msayad97/Amplifier/1kw-peak-rfpa-rc-1.0/1kw-peak-rfpa-rc-1.0/res/img/capacitor-holder-mounted.jpg

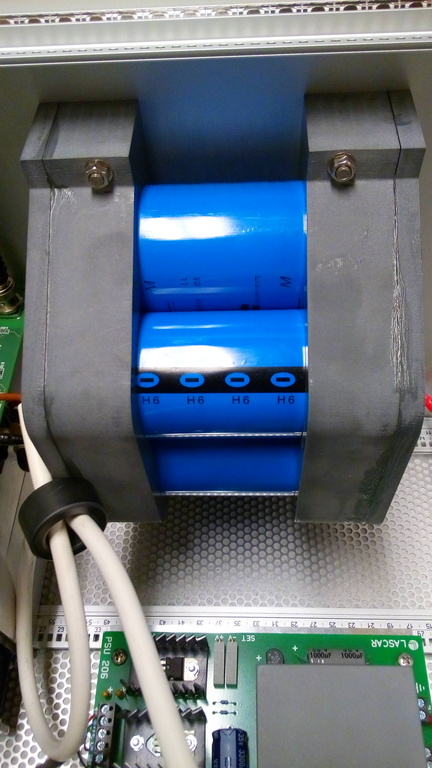
1kw-peak-rfpa-rc-1.0/1kw-peak-rfpa-rc-1.0/res/img/capacitor-holder-mounted.jpg
