msayad97/Amplifier/1kw-peak-rfpa-rc-1.0/1kw-peak-rfpa-rc-1.0/res/img/enclosure/IMG_20180207_160841.jpg

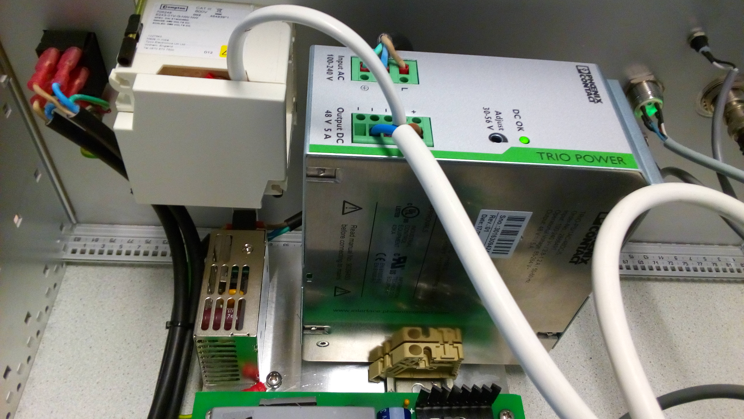
1kw-peak-rfpa-rc-1.0/1kw-peak-rfpa-rc-1.0/res/img/enclosure/IMG_20180207_160841.jpg
