msayad97/Amplifier/HF.png

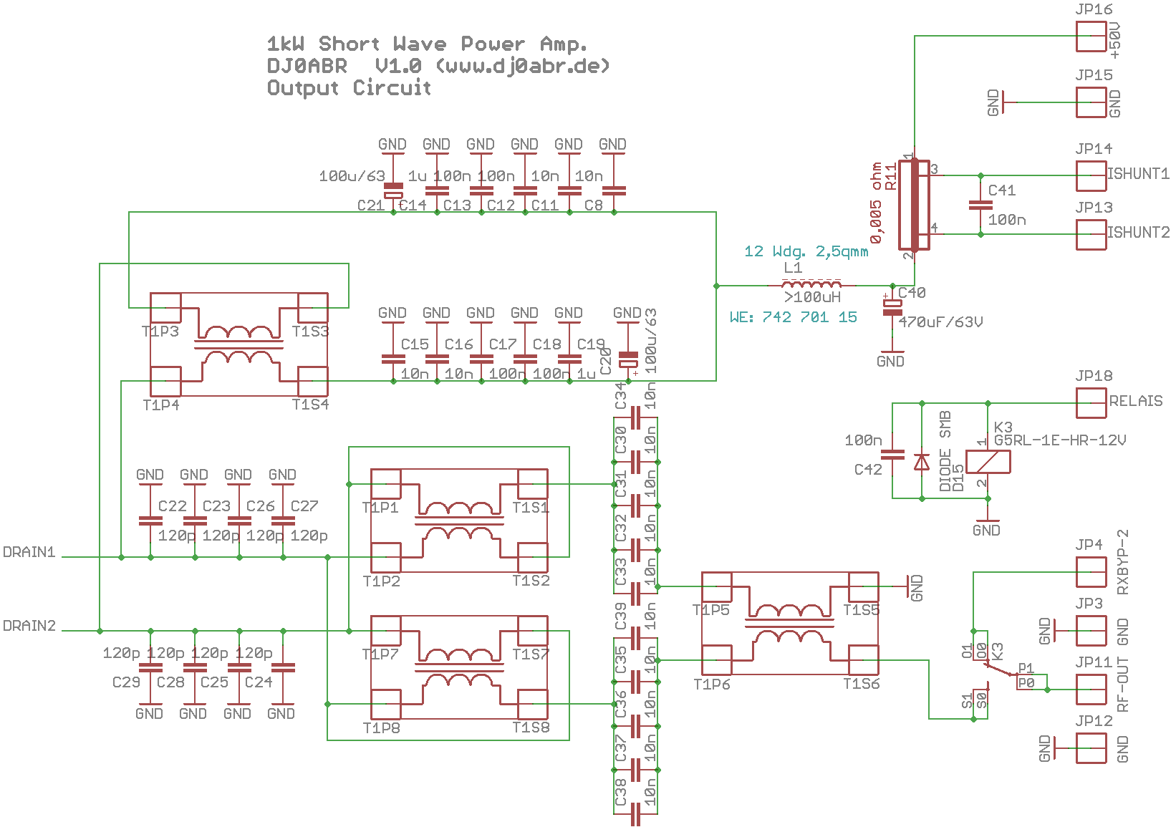
HF.png
