msayad97/Amplifier/KiCad/PCB/1.png

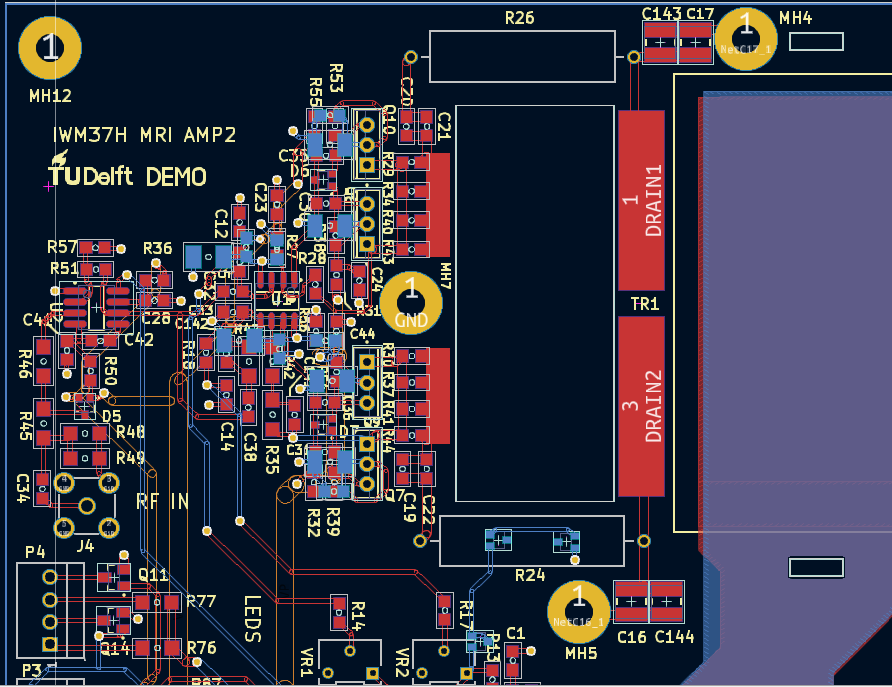
KiCad/PCB/1.png
