msayad97/Amplifier/KiCad/PCB/2.png

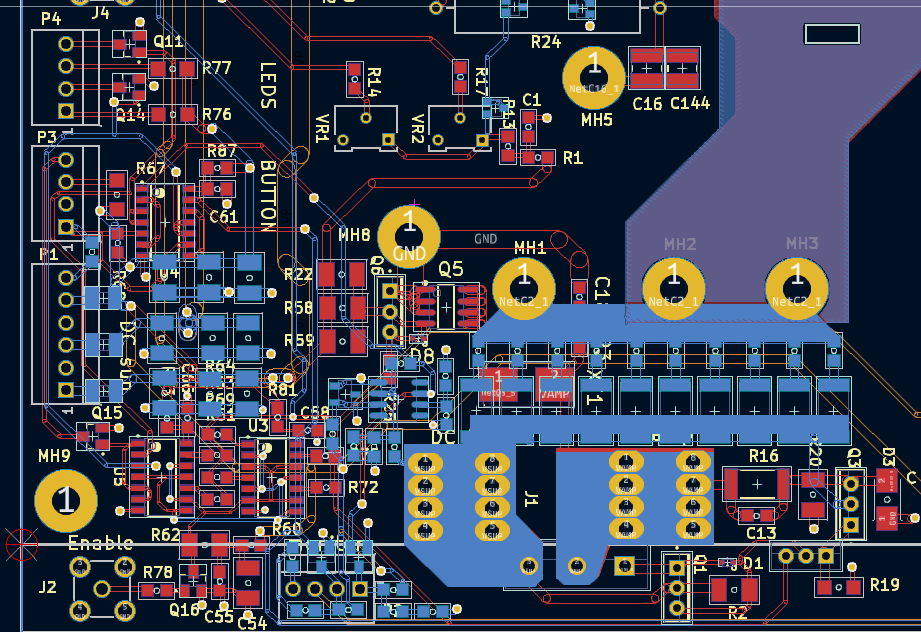
KiCad/PCB/2.png
