msayad97/Amplifier/KiCad/PCB/gs.png

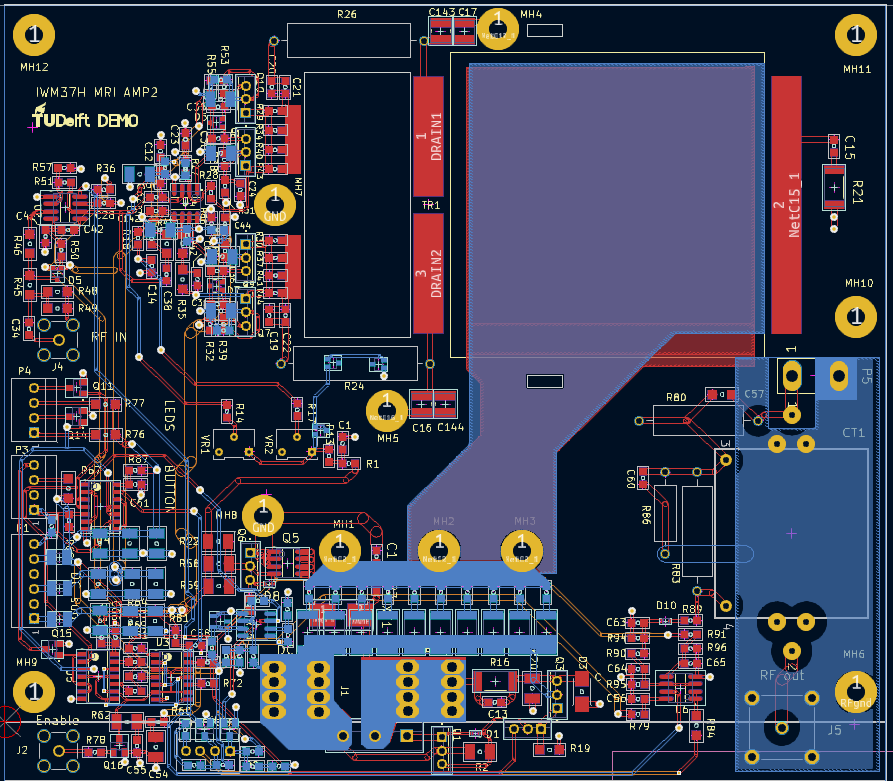
KiCad/PCB/gs.png
