msayad97/Amplifier/KiCad/PCB/PCB1.png

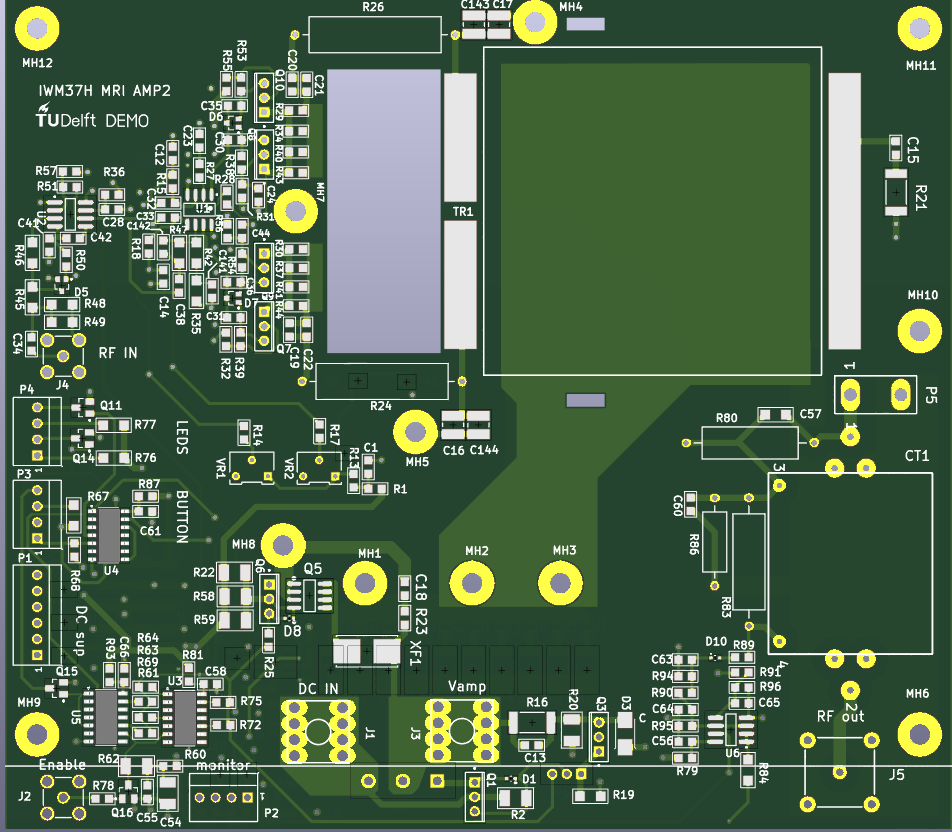
KiCad/PCB/PCB1.png
