msayad97/Amplifier/KiCad/PCB/PCB2.png

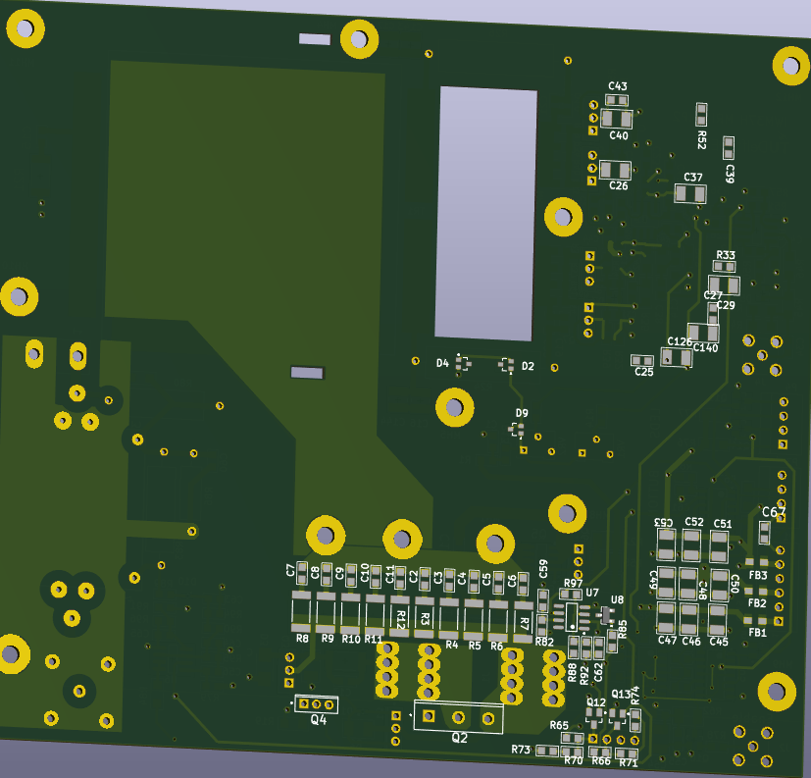
KiCad/PCB/PCB2.png
