msayad97/Amplifier/Pics/BSC340N08NS3.jpg

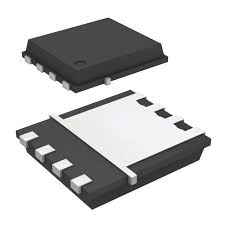
Pics/BSC340N08NS3.jpg
