msayad97/Amplifier/Pics/E4E.jpg

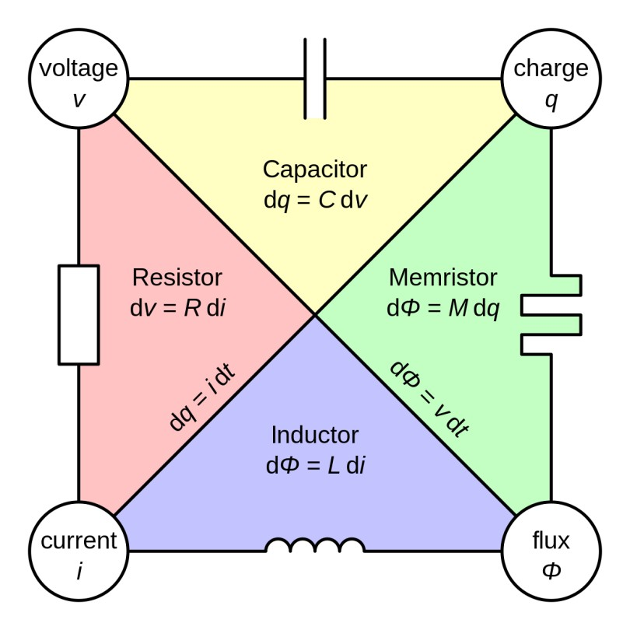
Pics/E4E.jpg
