msayad97/Amplifier/Pics/EE.jpg

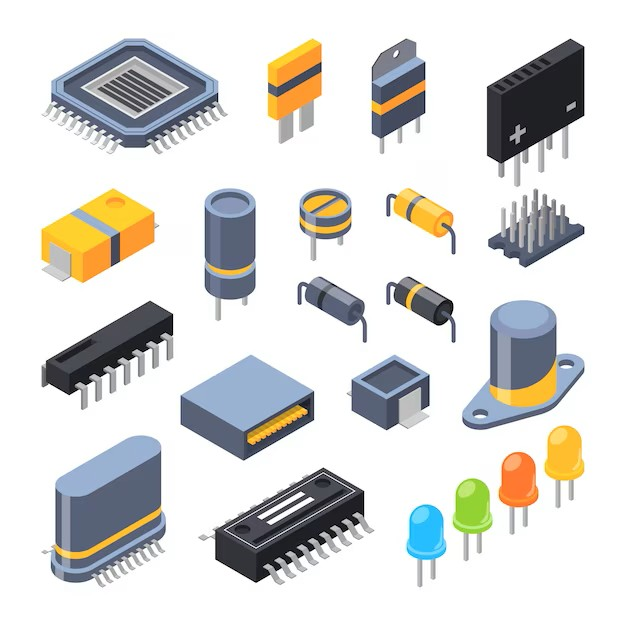
Pics/EE.jpg
