msayad97/Amplifier/Pics/IXTH90P10P.jpg

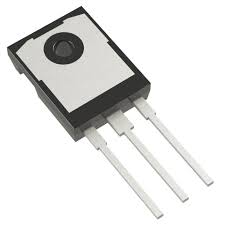
Pics/IXTH90P10P.jpg
