msayad97/Amplifier/Pics/ldmos.jpg

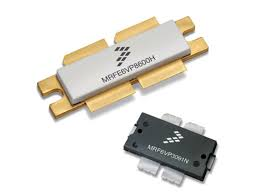
Pics/ldmos.jpg
