msayad97/Amplifier/Pics/opvs.png

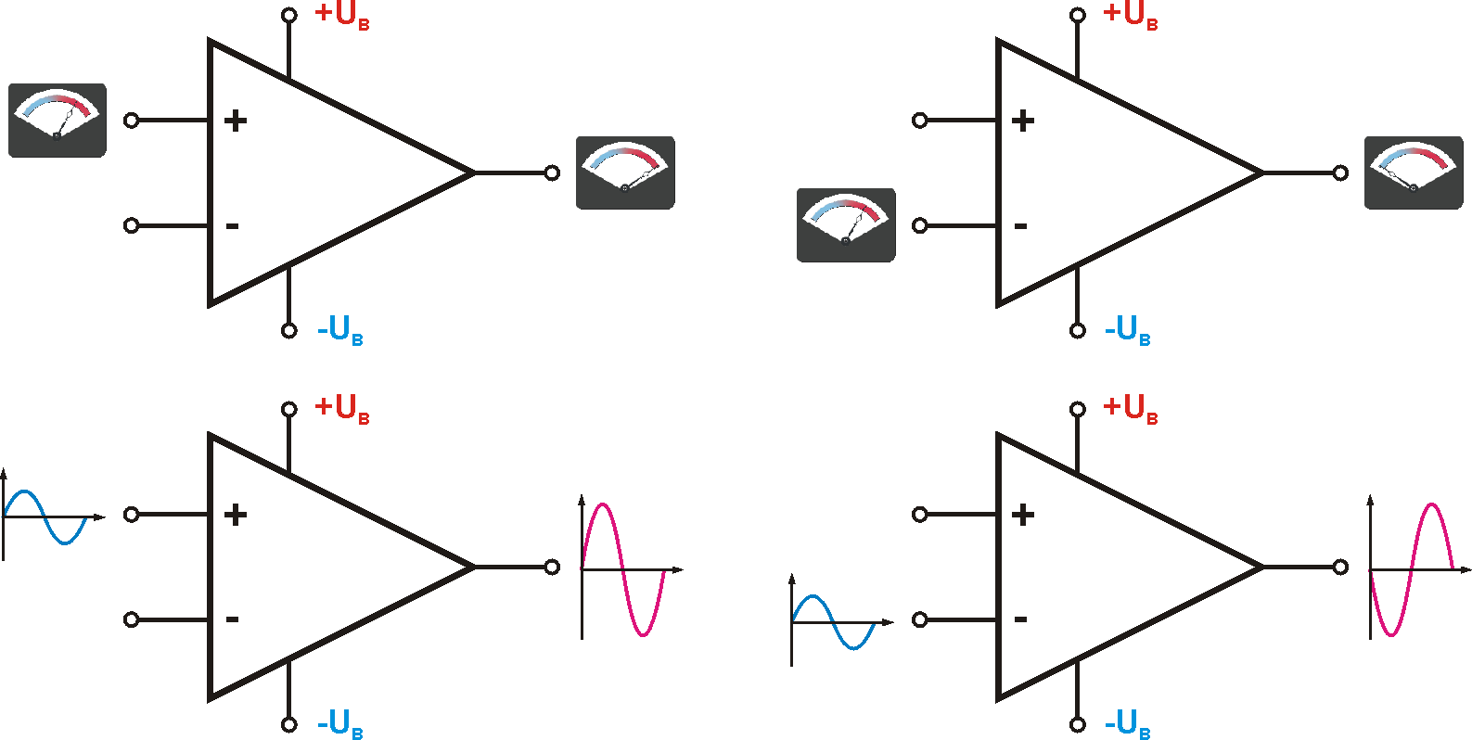
Pics/opvs.png
