msayad97/Amplifier/Pics/pcb.jpg

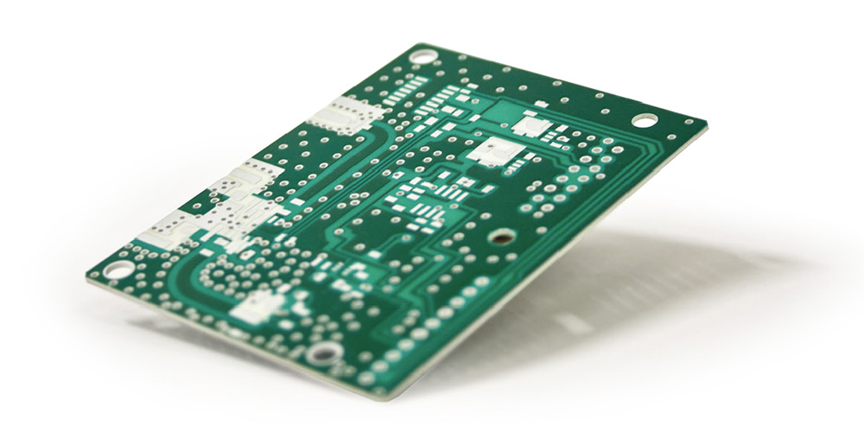
Pics/pcb.jpg
