msayad97/Amplifier/Pics/ssq.png

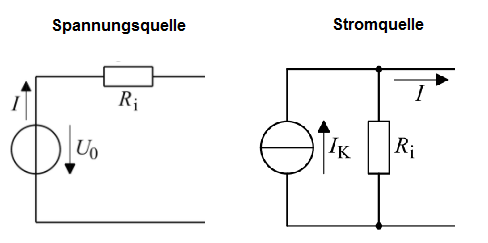
Pics/ssq.png
