msayad97/Amplifier/Pics_KiCad/1.png

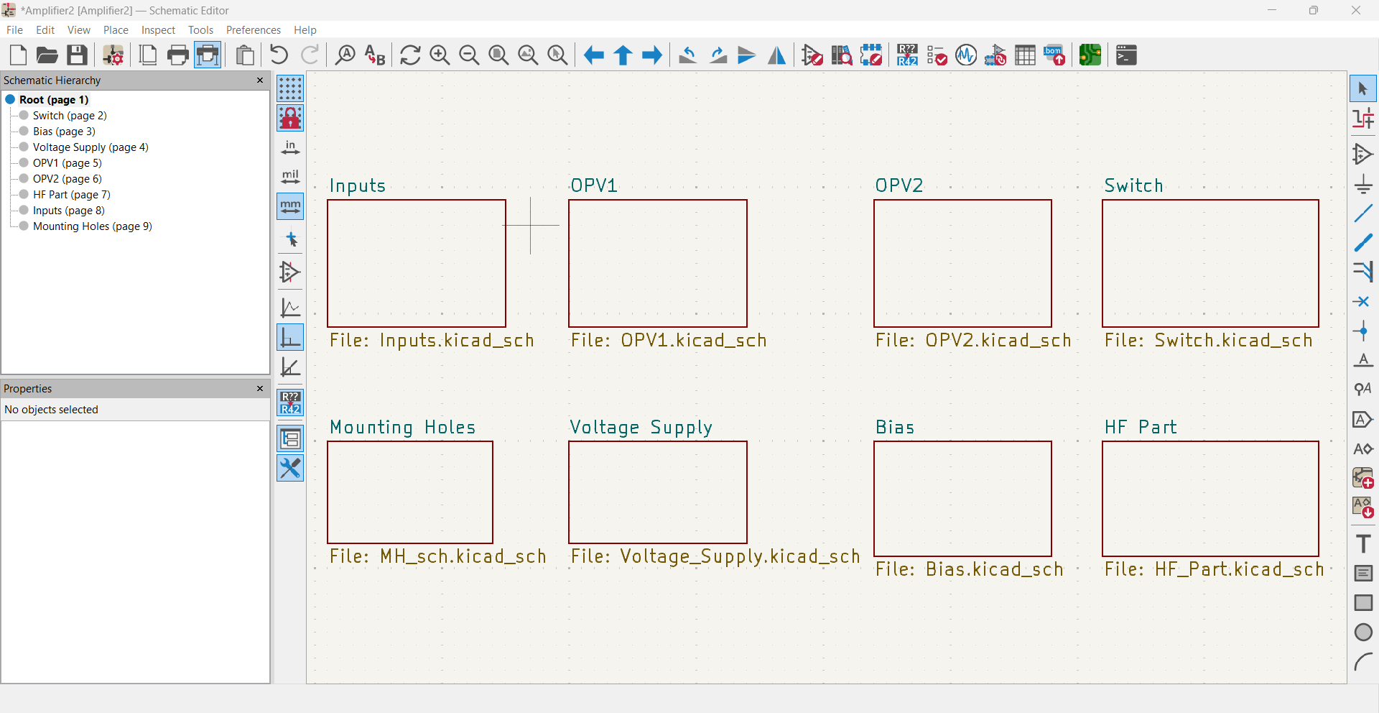
Pics_KiCad/1.png
