msayad97/Amplifier/Pics_KiCad/2.png

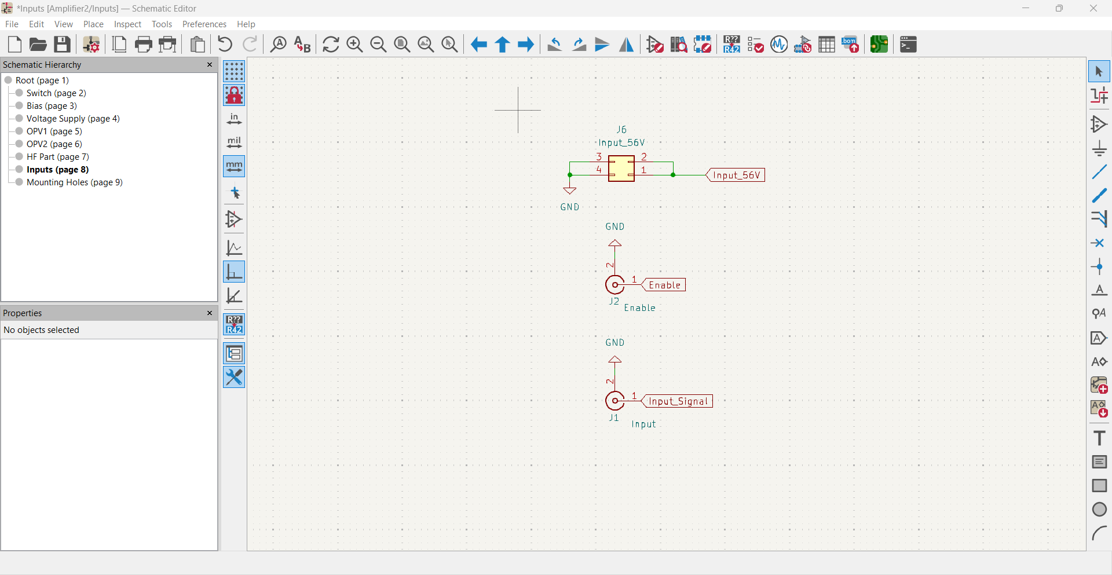
Pics_KiCad/2.png
