msayad97/Amplifier/Pics_KiCad/3.png

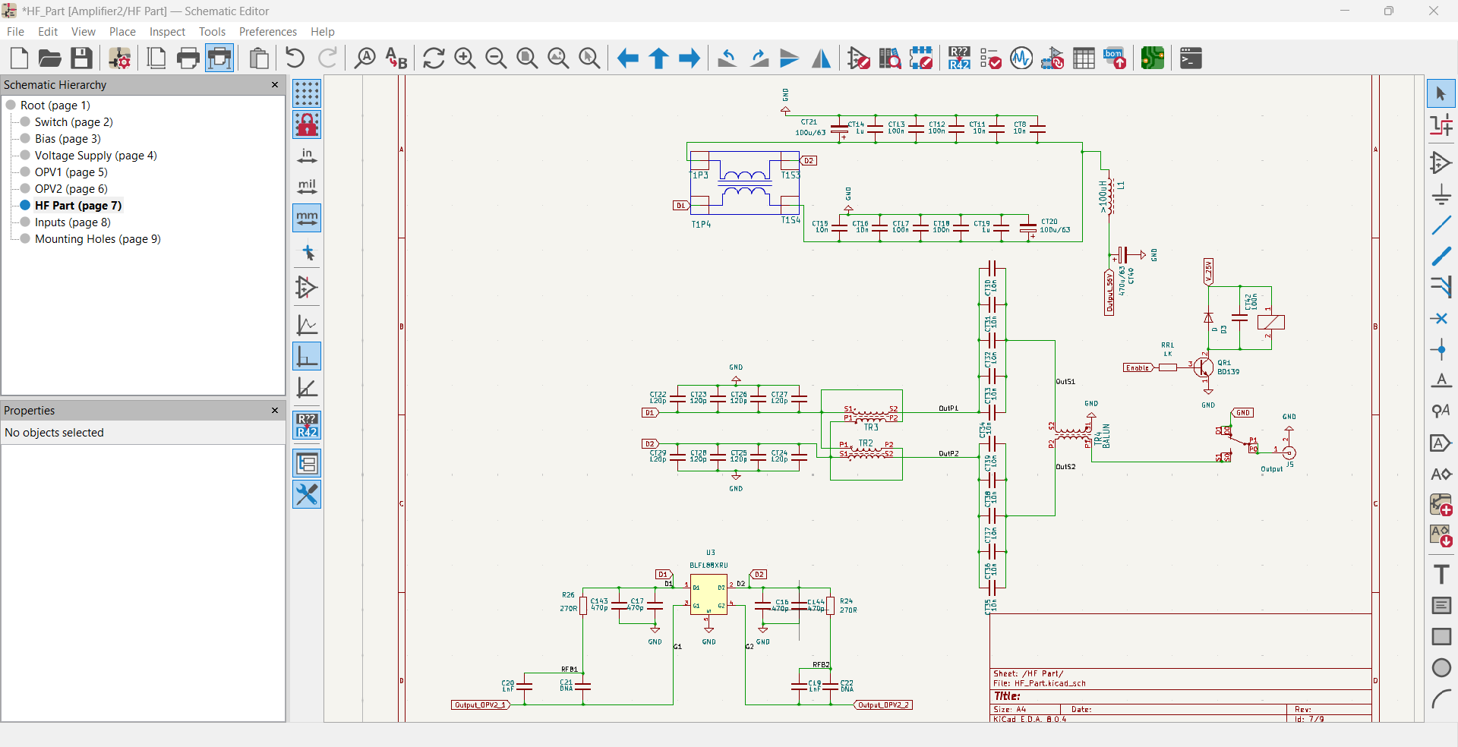
Pics_KiCad/3.png
