msayad97/Amplifier/Pics_KiCad/4.png

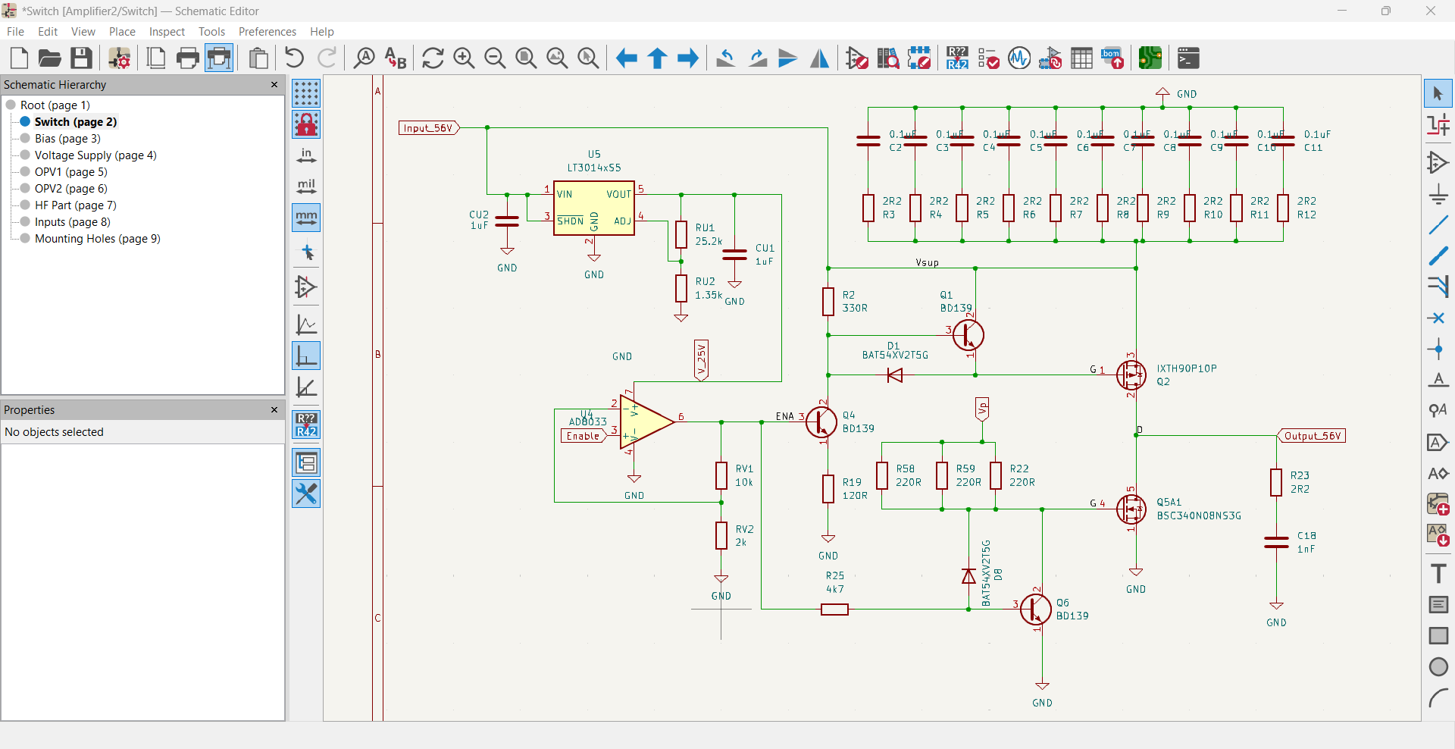
Pics_KiCad/4.png
