msayad97/Amplifier/Pics_KiCad/5.png

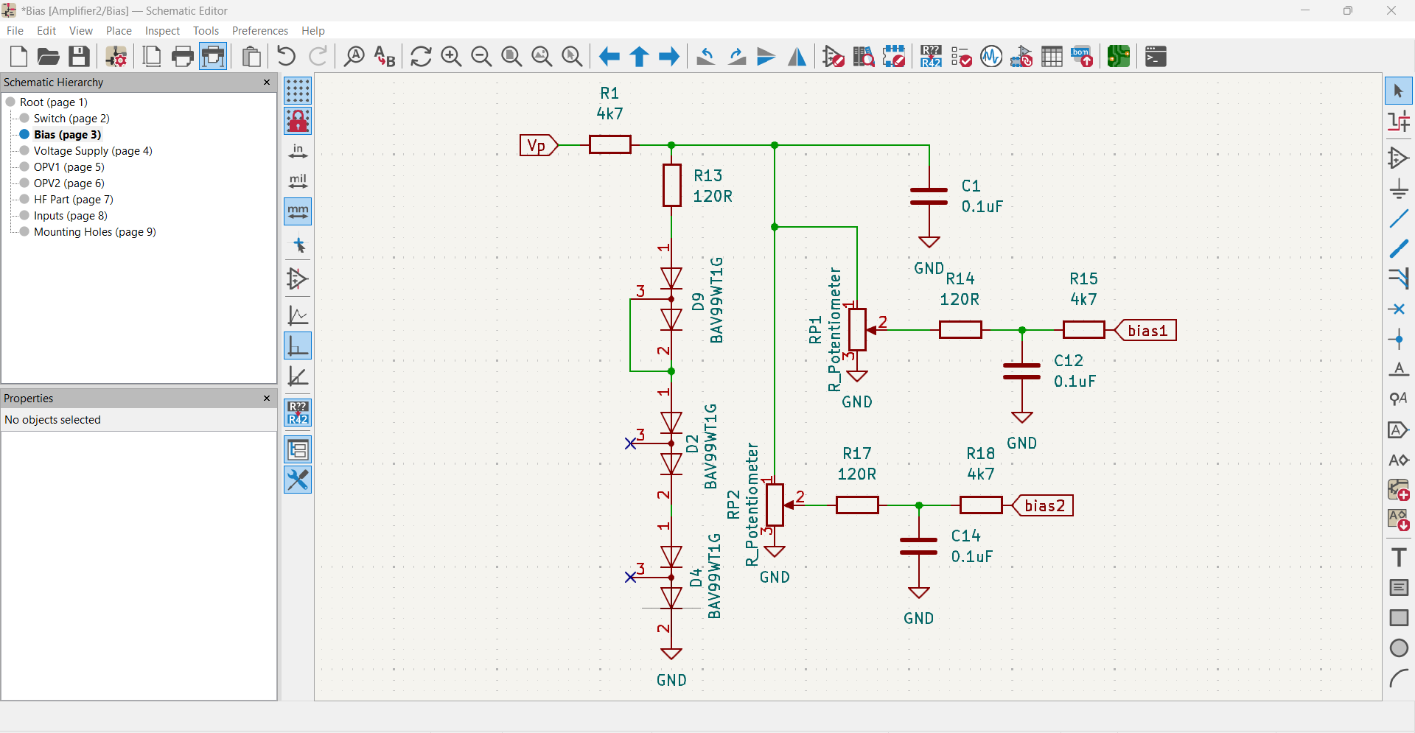
Pics_KiCad/5.png
