msayad97/Amplifier/Pics_KiCad/6.png

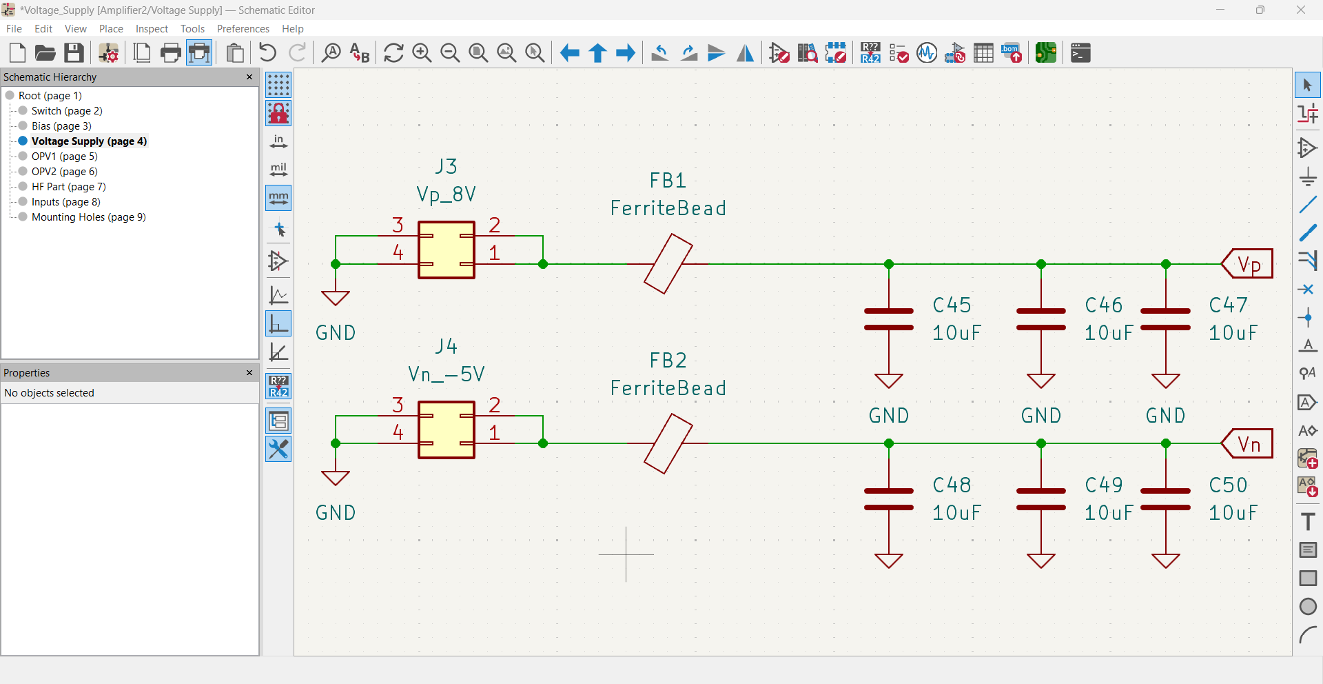
Pics_KiCad/6.png
