msayad97/Amplifier/Pics_KiCad/7.png

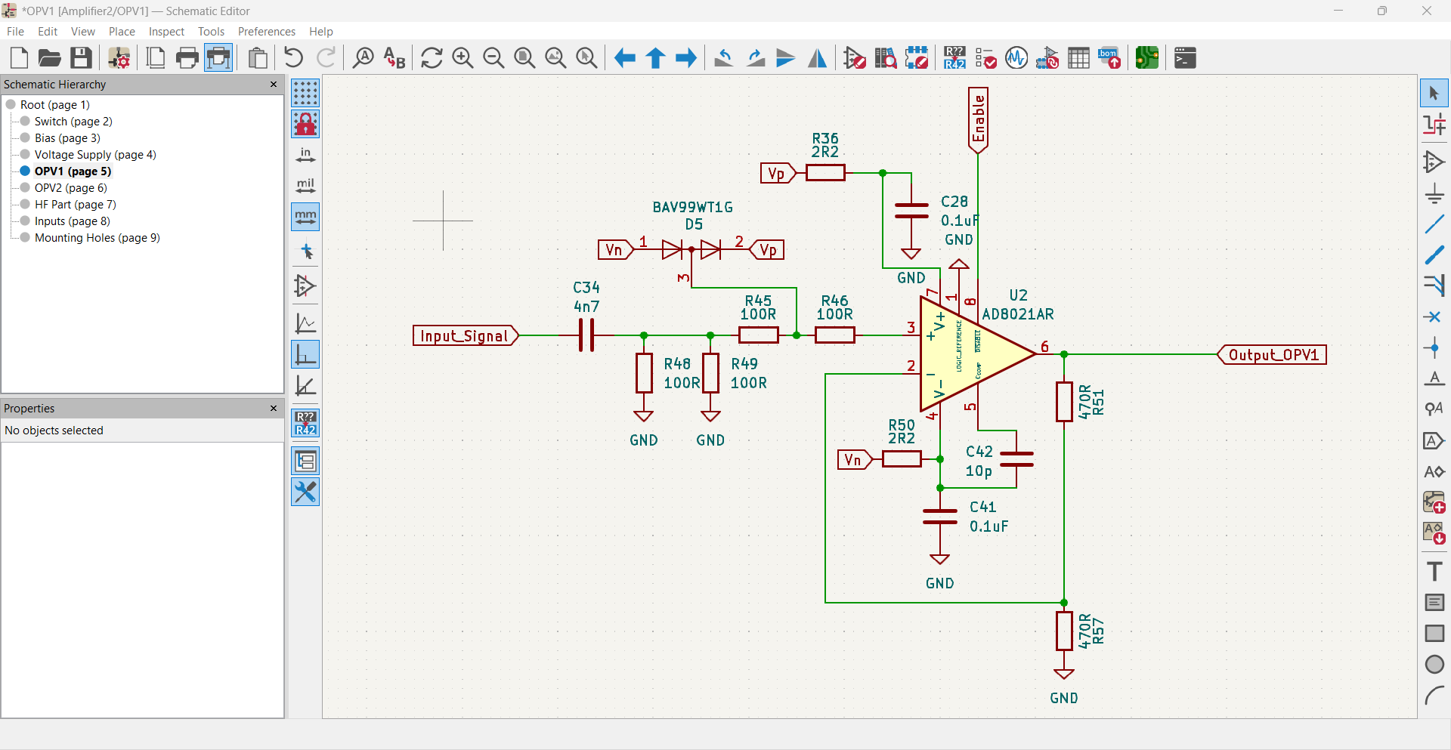
Pics_KiCad/7.png
