msayad97/Amplifier/Pics_KiCad/8.png

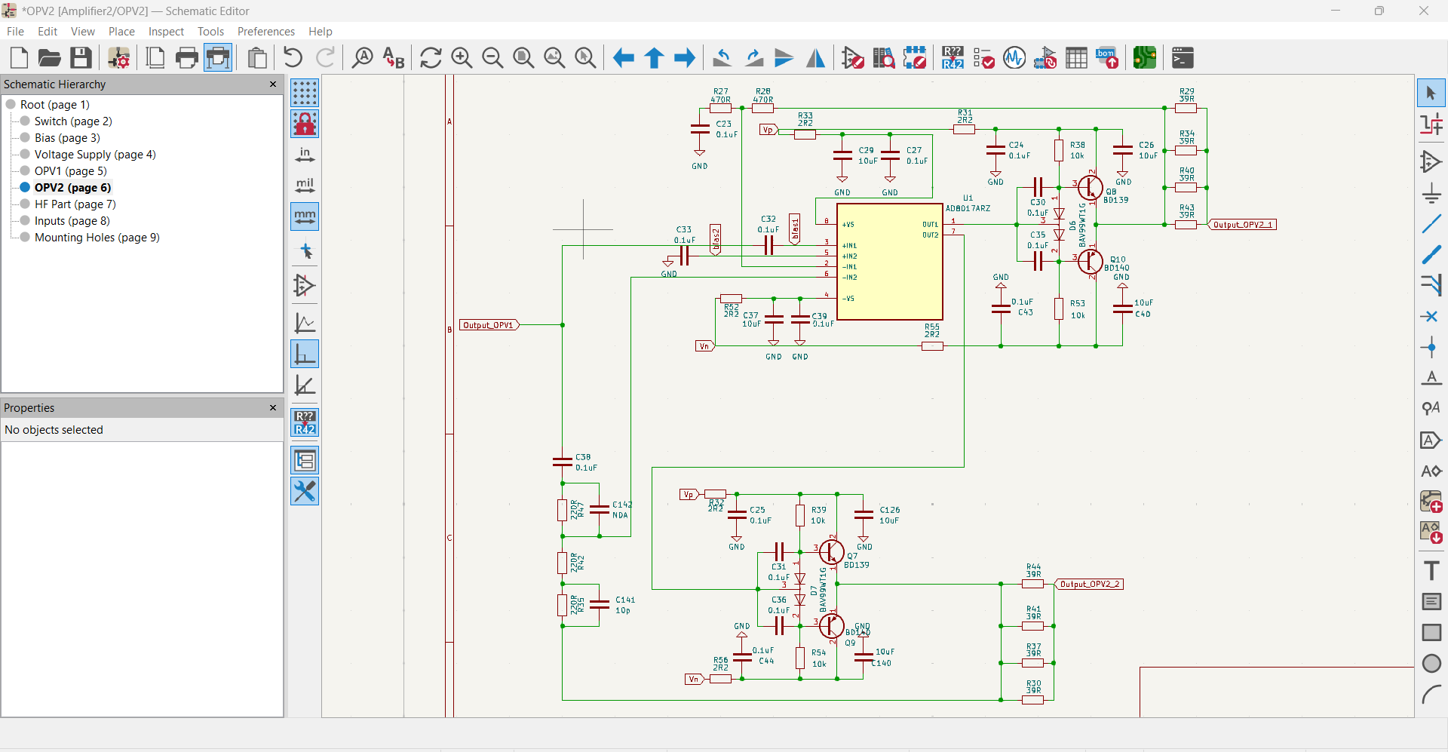
Pics_KiCad/8.png
