msayad97/Amplifier/Pics_KiCad/9.png

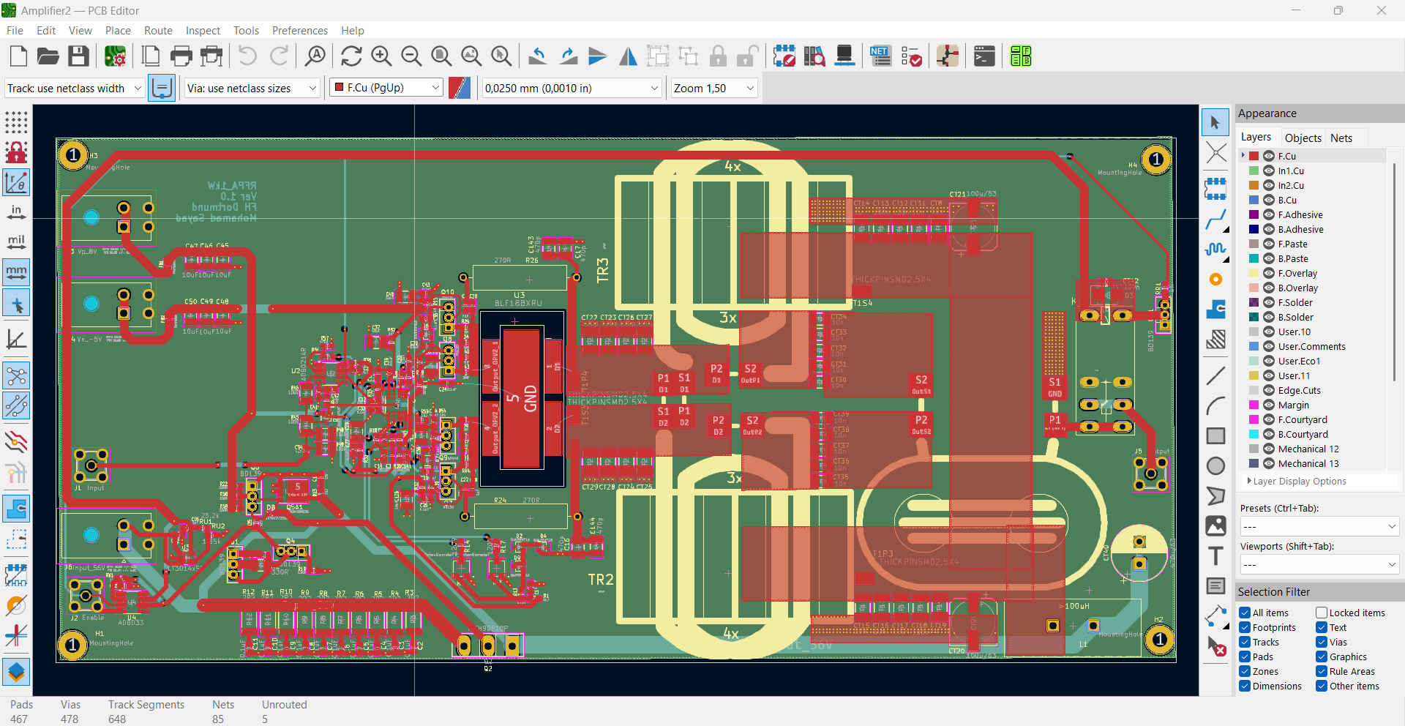
Pics_KiCad/9.png
