msayad97/Amplifier/Pics_KiCad/Bias.png

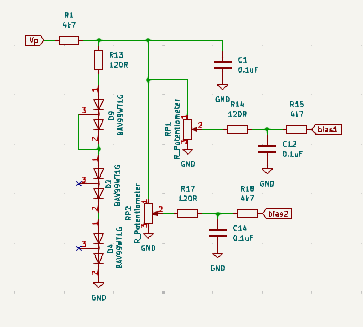
Pics_KiCad/Bias.png
