msayad97/Amplifier/Pics_KiCad/HFTeil.png

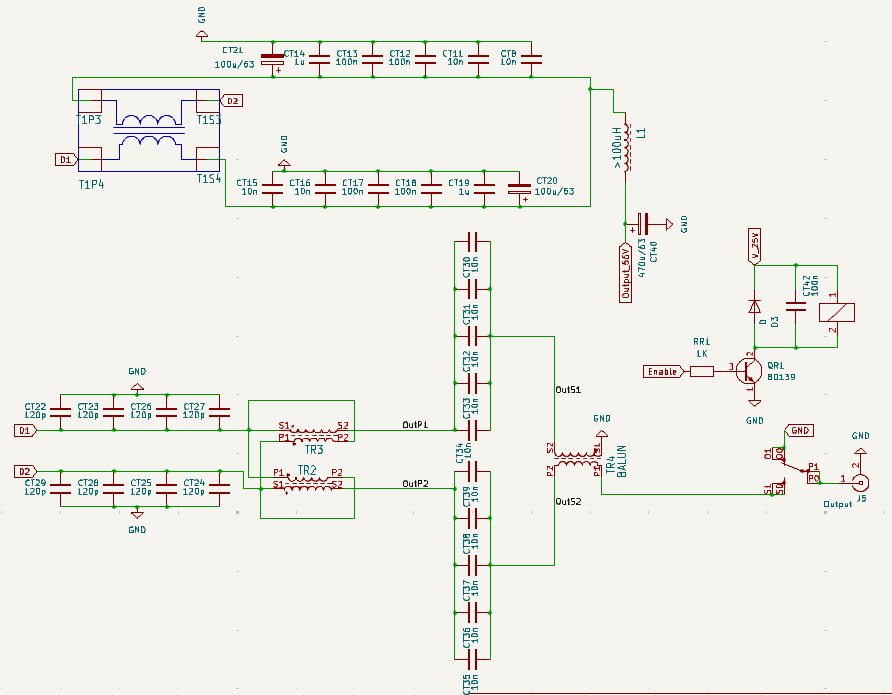
Pics_KiCad/HFTeil.png
