msayad97/Amplifier/Pics_KiCad/IStufe.png

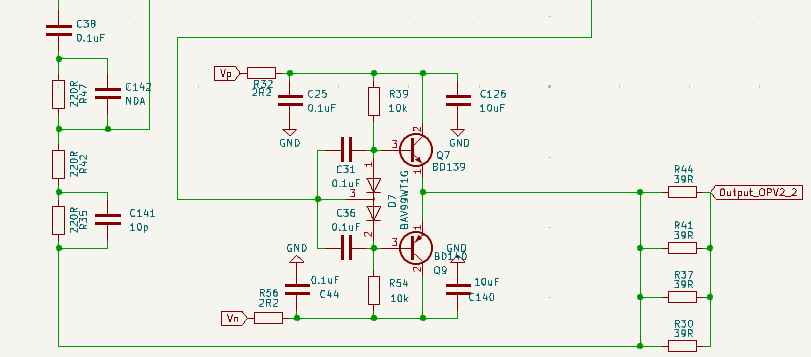
Pics_KiCad/IStufe.png
