msayad97/Amplifier/Pics_KiCad/kc1.png

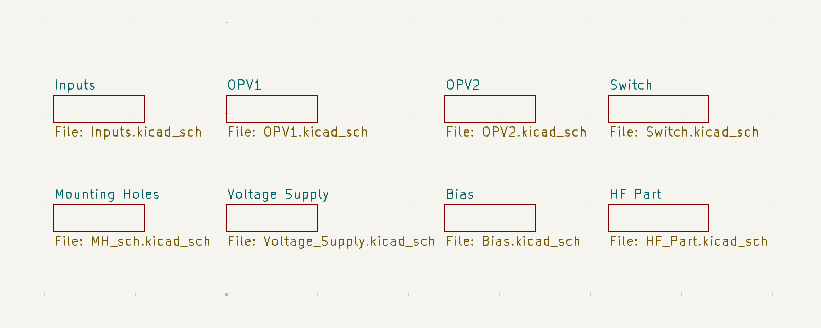
Pics_KiCad/kc1.png
