msayad97/Amplifier/Pics_KiCad/kc.png

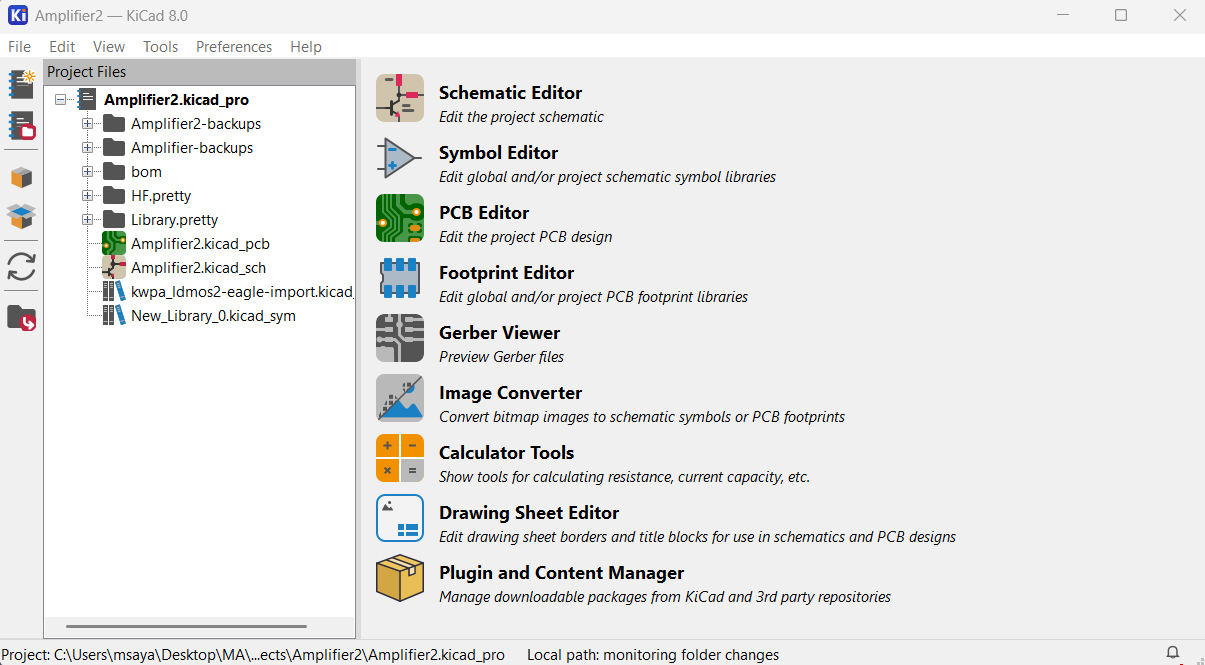
Pics_KiCad/kc.png
