msayad97/Amplifier/Pics_KiCad/kcpcb.png

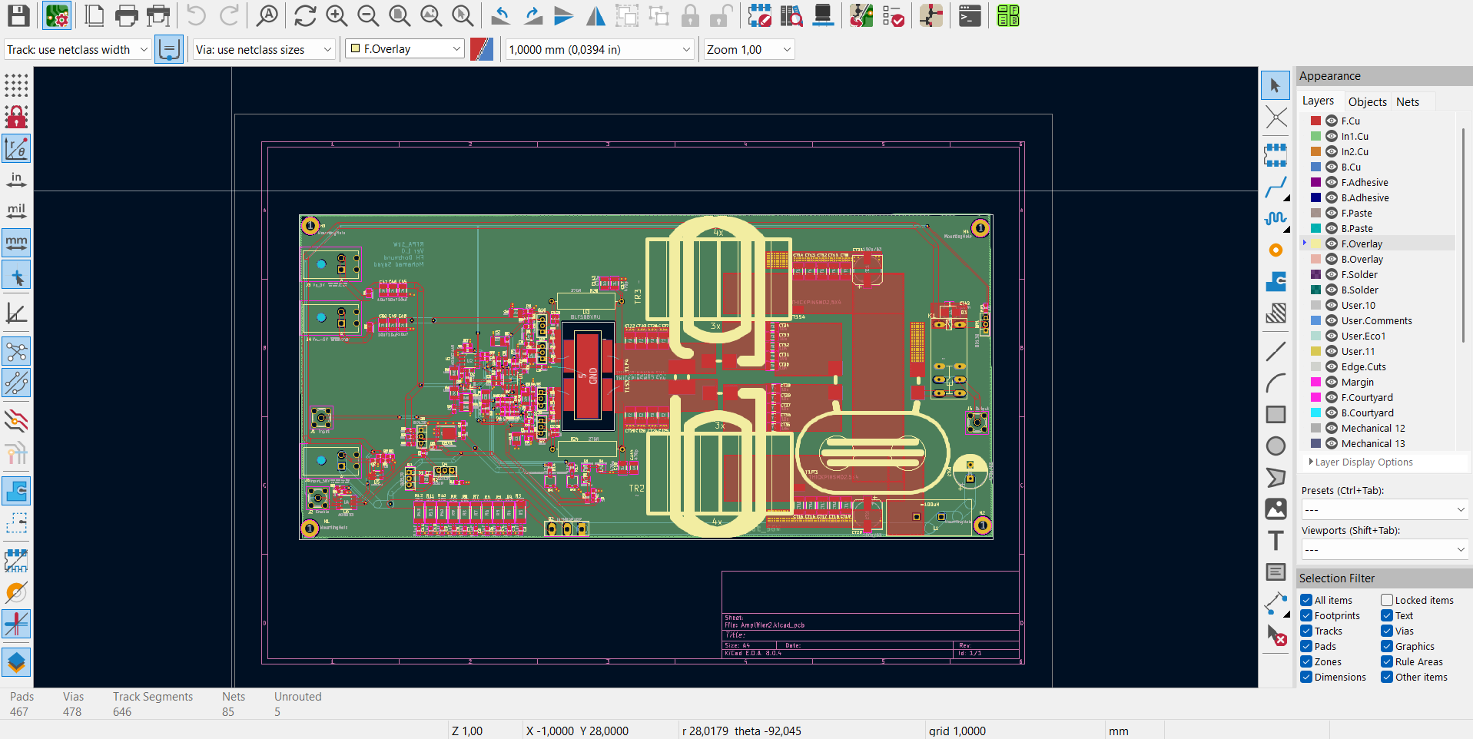
Pics_KiCad/kcpcb.png
