msayad97/Amplifier/Pics_KiCad/kcpcbb.png

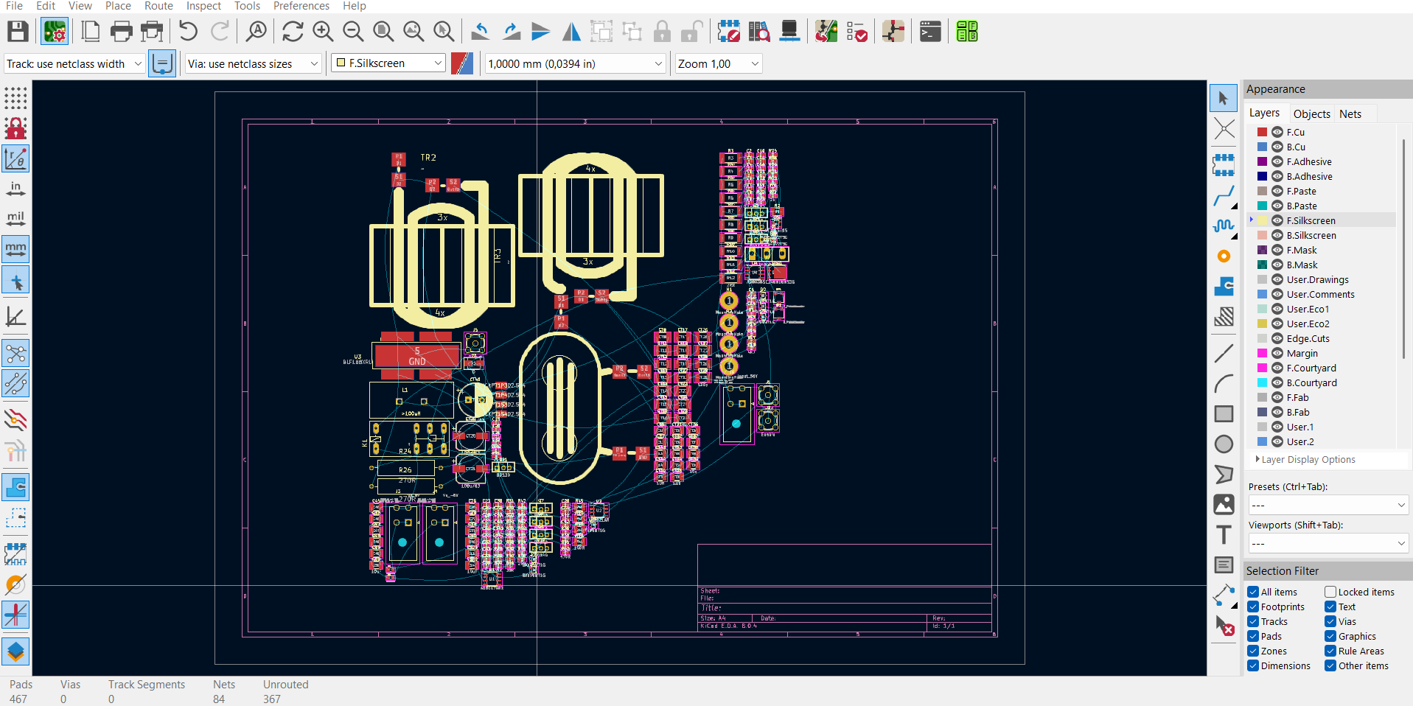
Pics_KiCad/kcpcbb.png
