msayad97/Amplifier/Pics_KiCad/kcrc.png

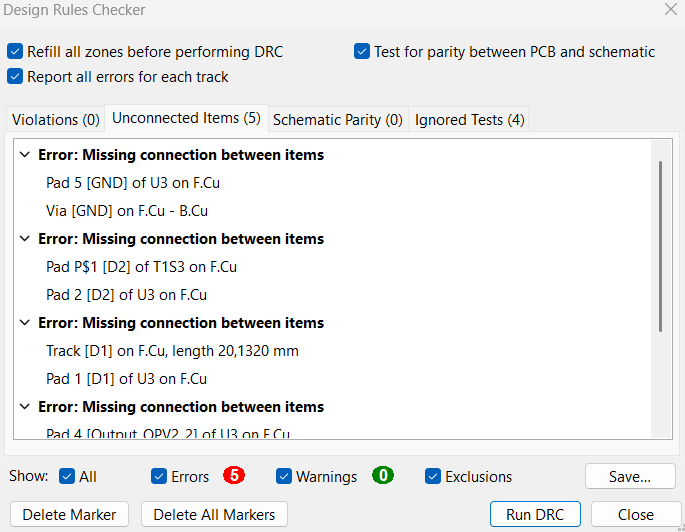
Pics_KiCad/kcrc.png
