msayad97/Amplifier/Pics_KiCad/LDMOS.png

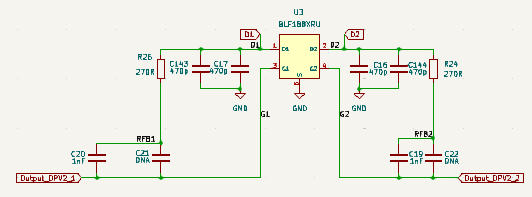
Pics_KiCad/LDMOS.png
