msayad97/Amplifier/Pics_KiCad/NIStufe.png

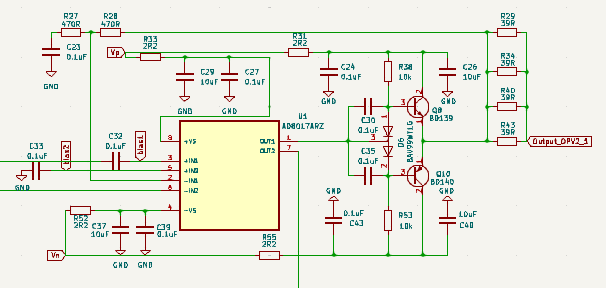
Pics_KiCad/NIStufe.png
