msayad97/Amplifier/Pics_KiCad/S1.png

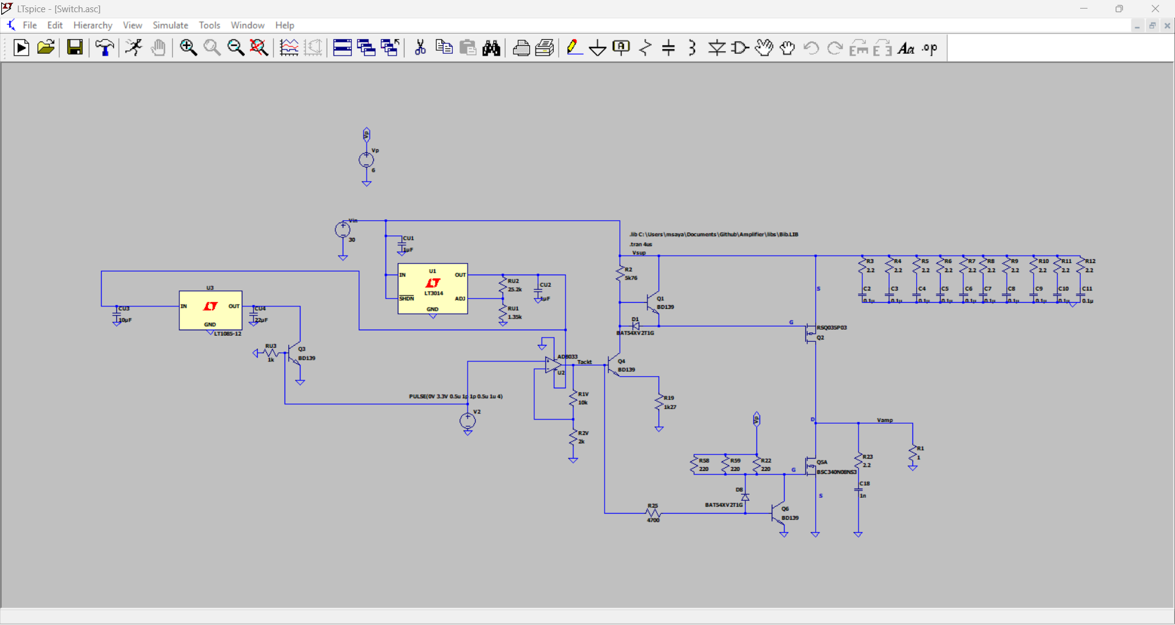
Pics_KiCad/S1.png
