msayad97/Amplifier/Pics_KiCad/S2.png

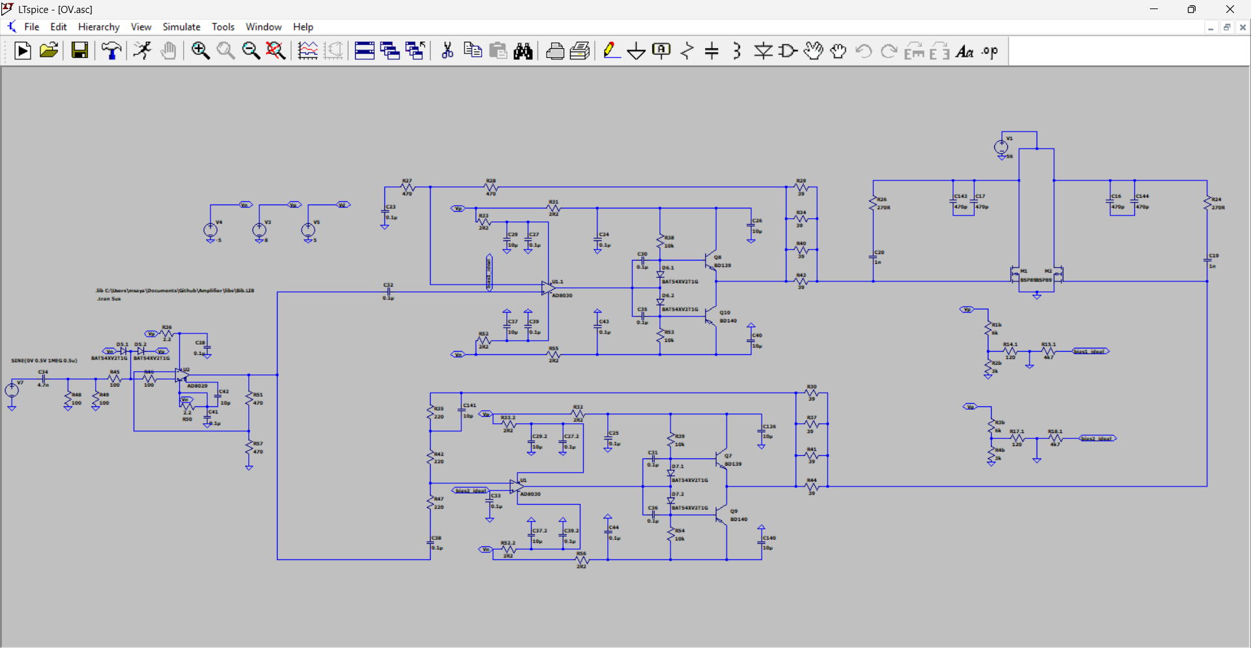
Pics_KiCad/S2.png
