msayad97/Amplifier/Pics_KiCad/stufe1.png

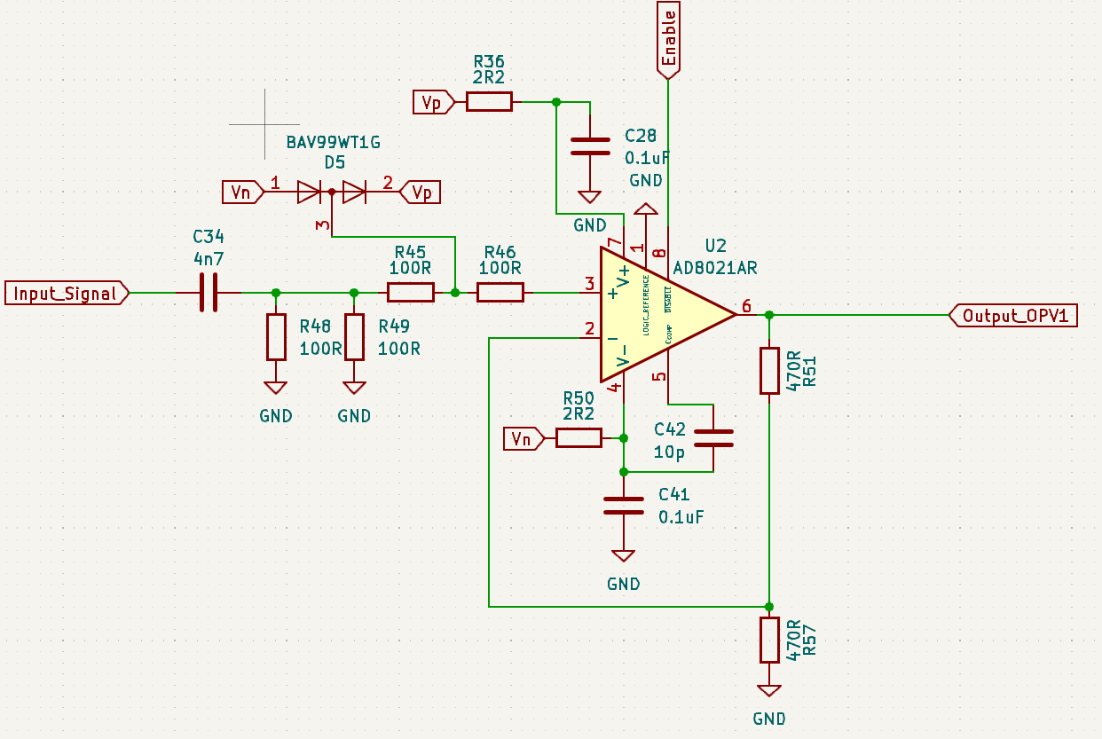
Pics_KiCad/stufe1.png
