msayad97/Amplifier/Pics_KiCad/switch.png

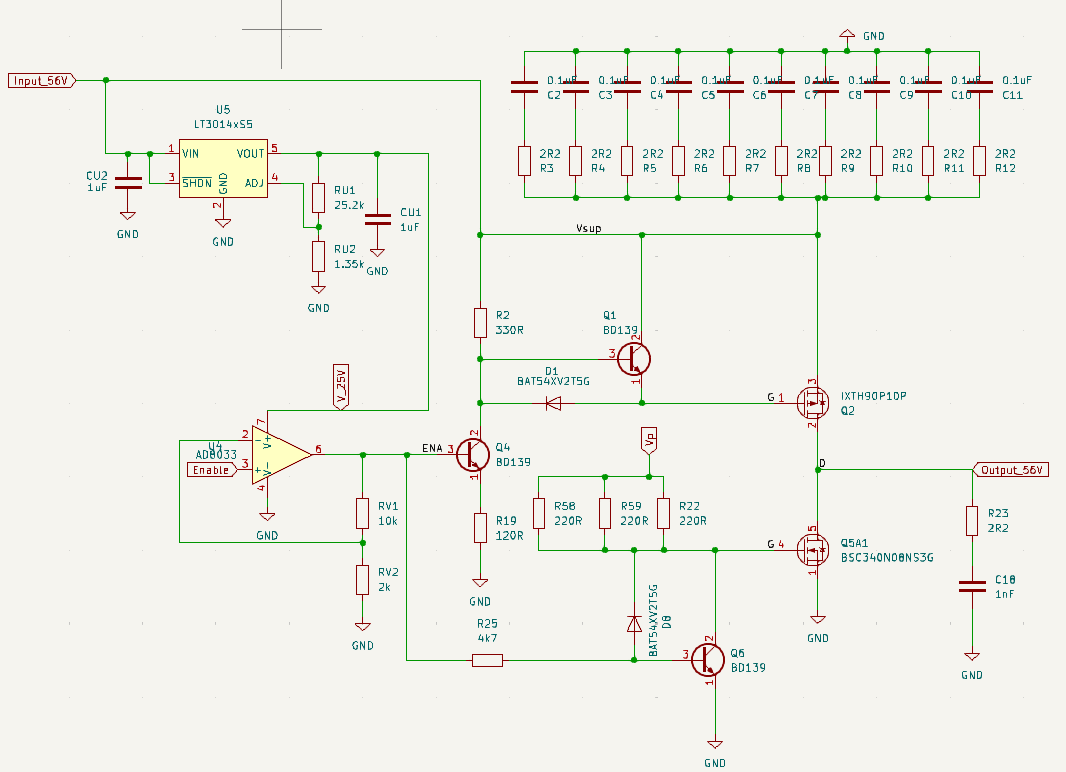
Pics_KiCad/switch.png
