msayad97/Amplifier/Pics_Labor/Coils.jpg

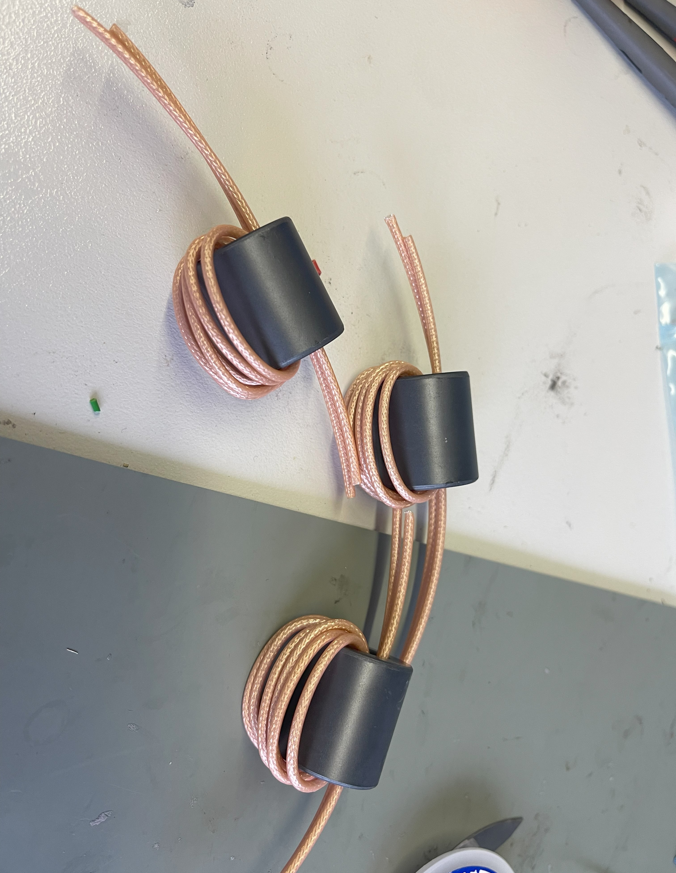
Pics_Labor/Coils.jpg
