msayad97/Amplifier/Pics_Labor/lm.jpg

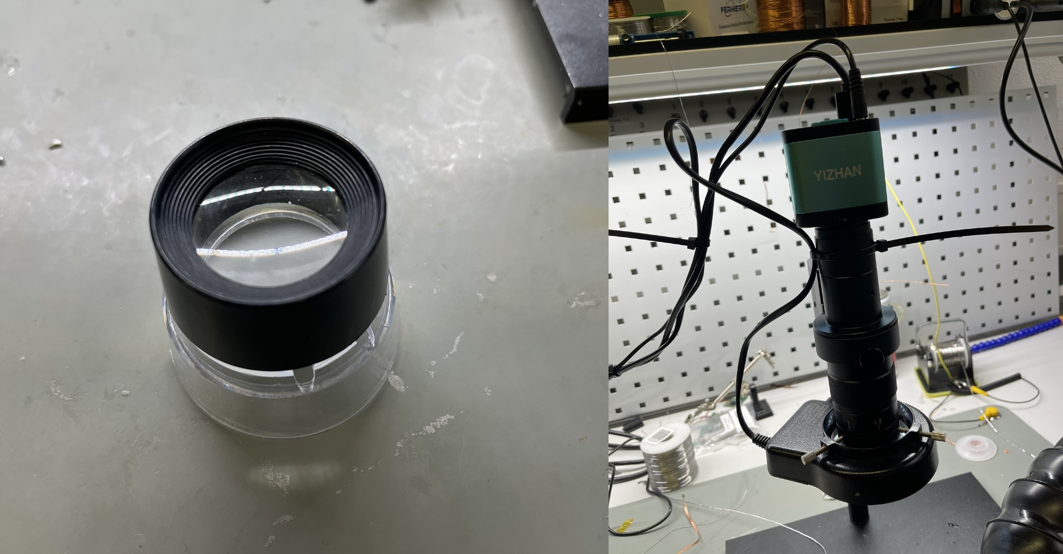
Pics_Labor/lm.jpg
