msayad97/Amplifier/Pics_Labor/Loeten.jpg

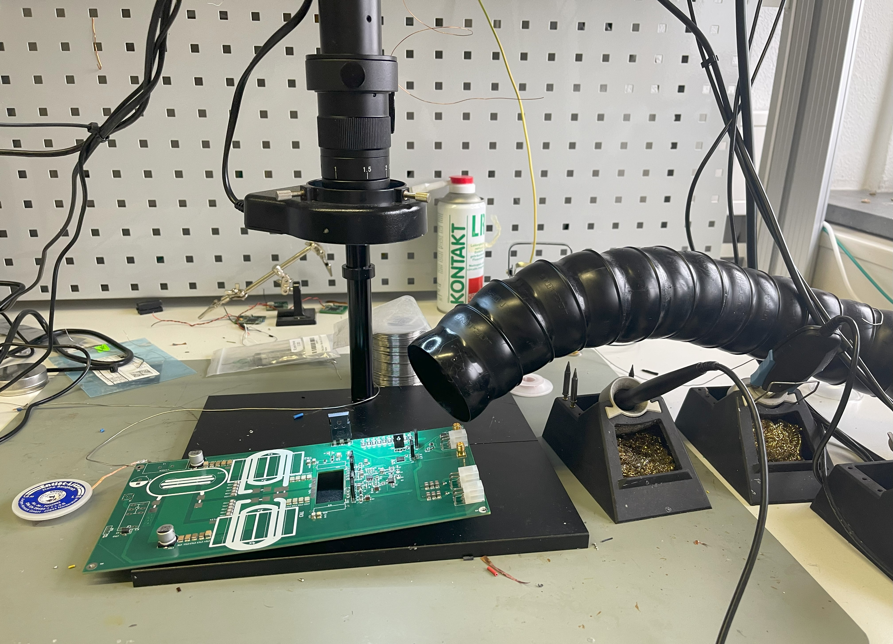
Pics_Labor/Loeten.jpg
