msayad97/Amplifier/Pics_Labor/Lupe.jpg

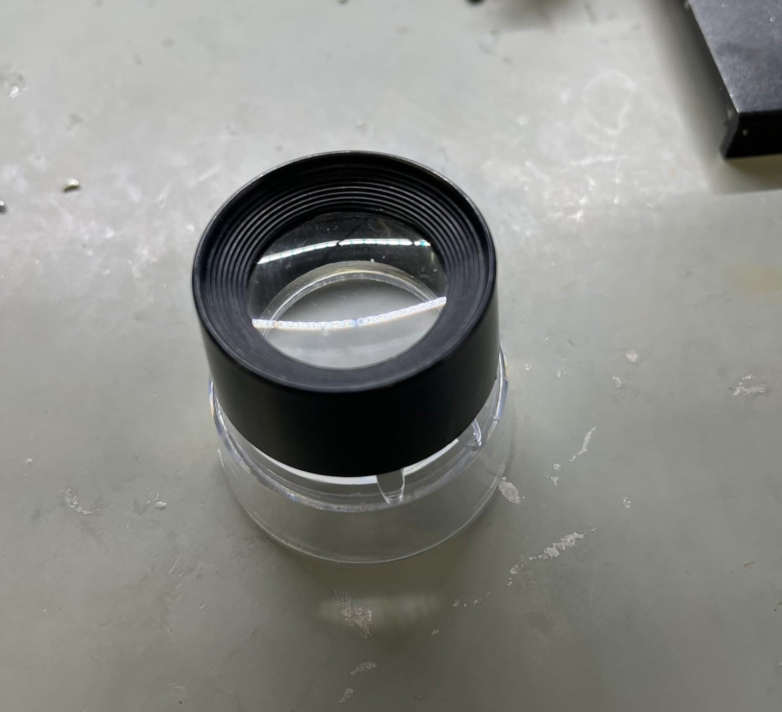
Pics_Labor/Lupe.jpg
