msayad97/Amplifier/Pics_Labor/Mikroskope.jpg

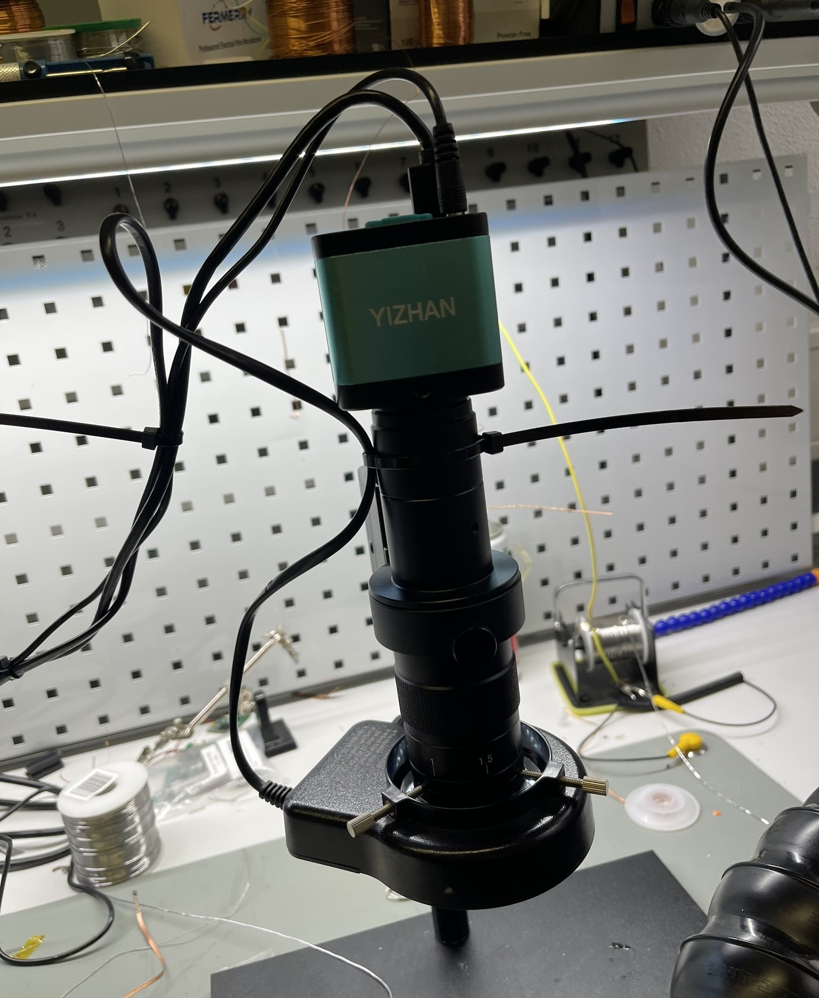
Pics_Labor/Mikroskope.jpg
