msayad97/Amplifier/Pics_Labor/Multimeter.jpg

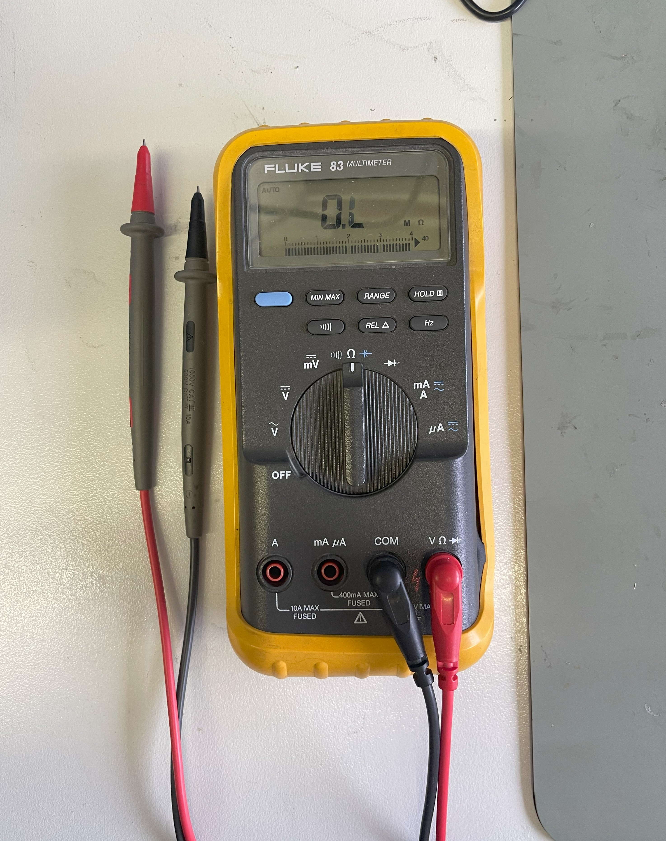
Pics_Labor/Multimeter.jpg
