msayad97/Amplifier/Pics_Labor/ok.jpg

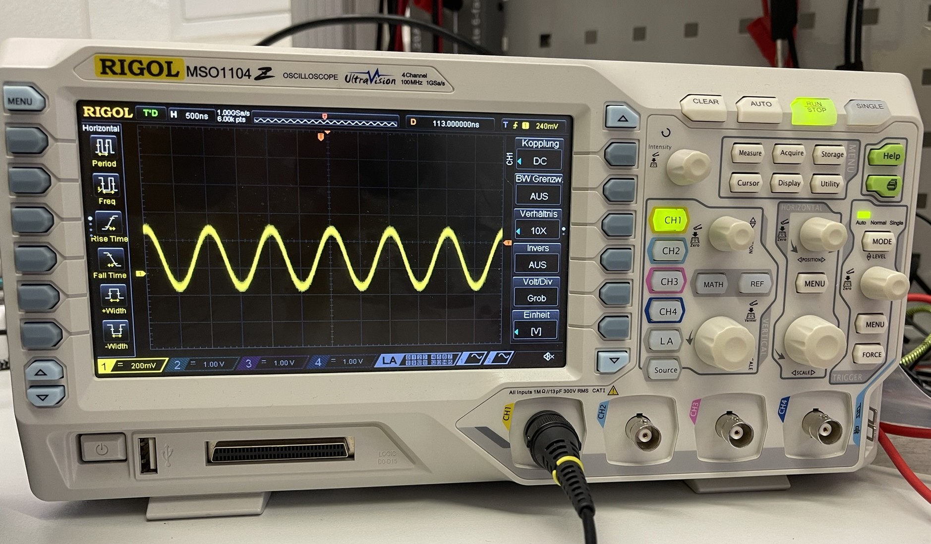
Pics_Labor/ok.jpg
