msayad97/Amplifier/Pics_Labor/oka1.jpg

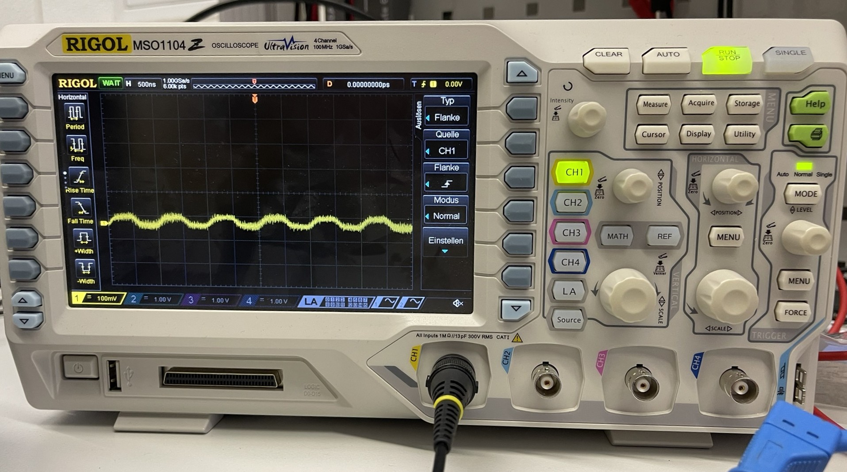
Pics_Labor/oka1.jpg
