msayad97/Amplifier/Pics_Labor/okes.jpg

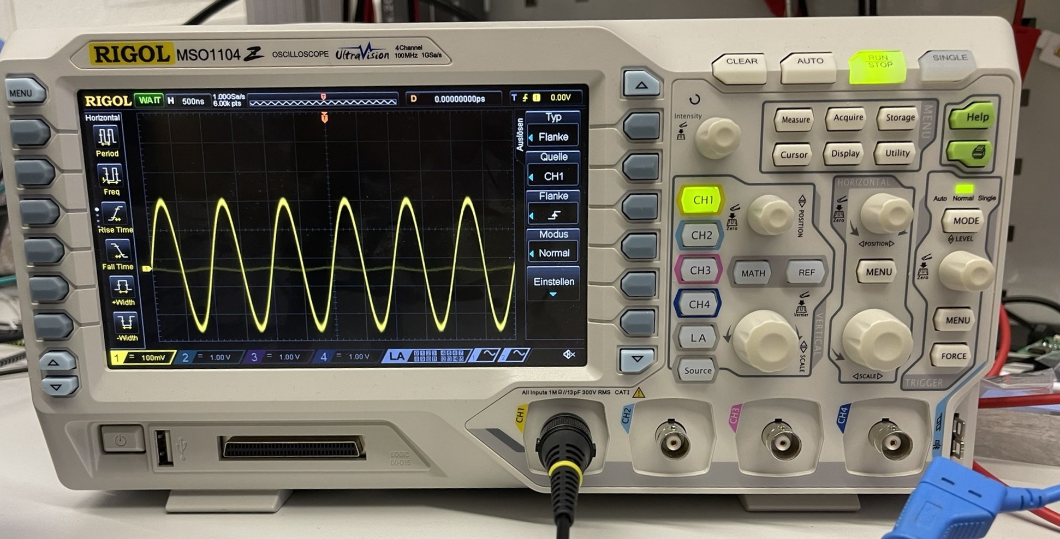
Pics_Labor/okes.jpg
