msayad97/Amplifier/Pics_Labor/Platine1.jpg

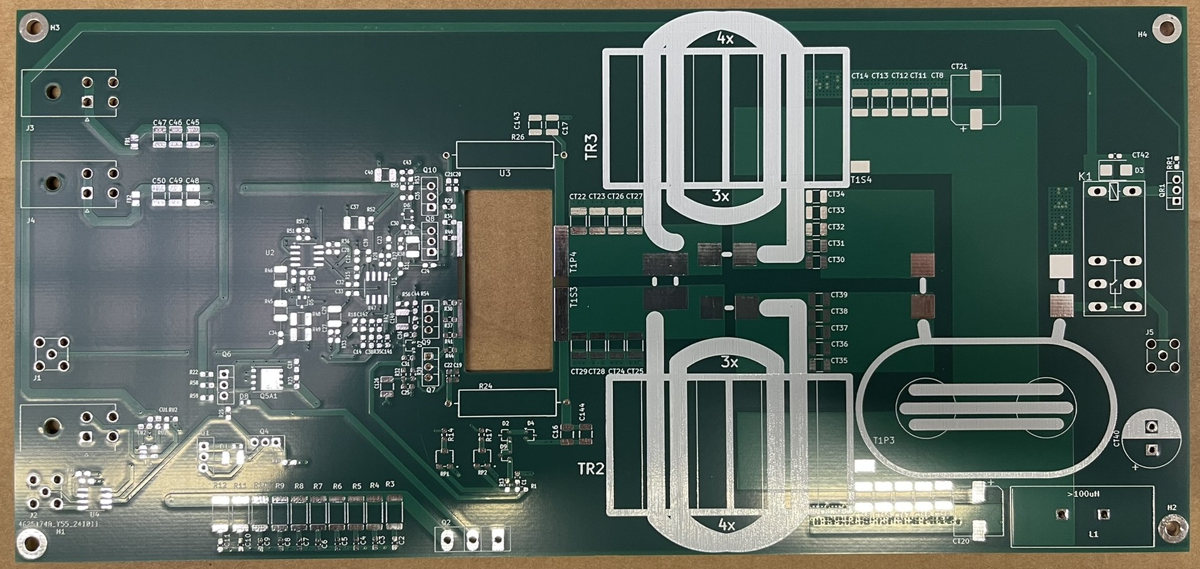
Pics_Labor/Platine1.jpg
