msayad97/Amplifier/Pics_Labor/Platine2.jpg

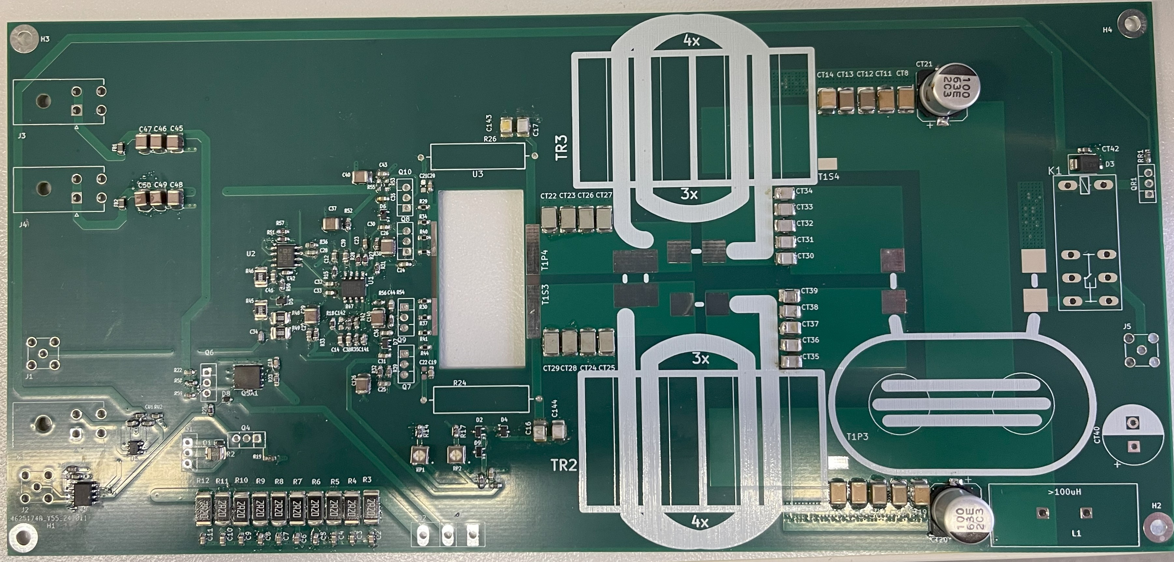
Pics_Labor/Platine2.jpg
