msayad97/Amplifier/Pics_Labor/Platine3.jpg

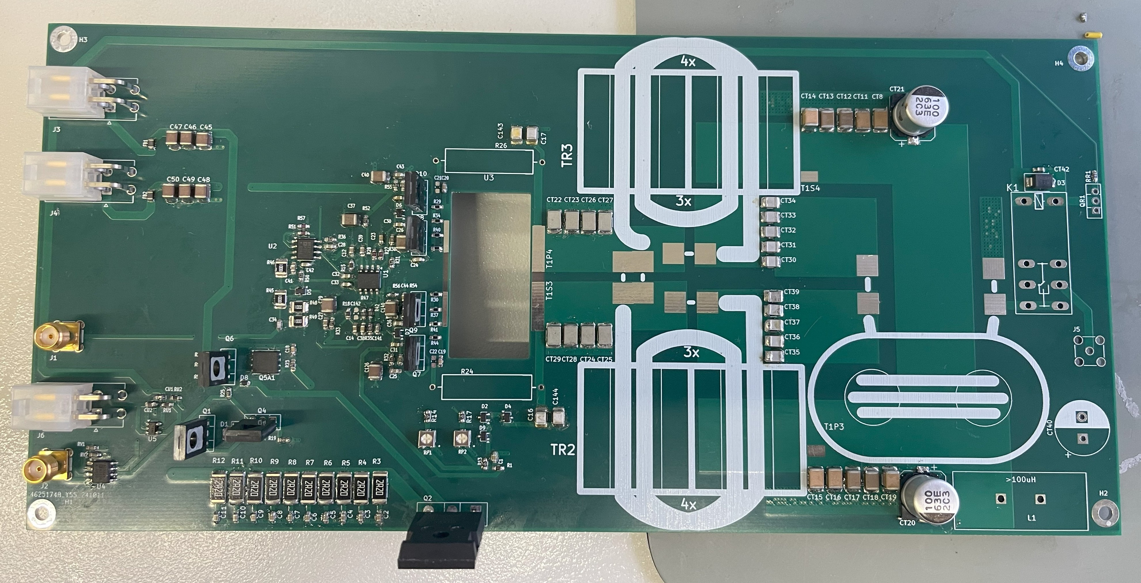
Pics_Labor/Platine3.jpg
