msayad97/Amplifier/Pics_Labor/pps.jpg

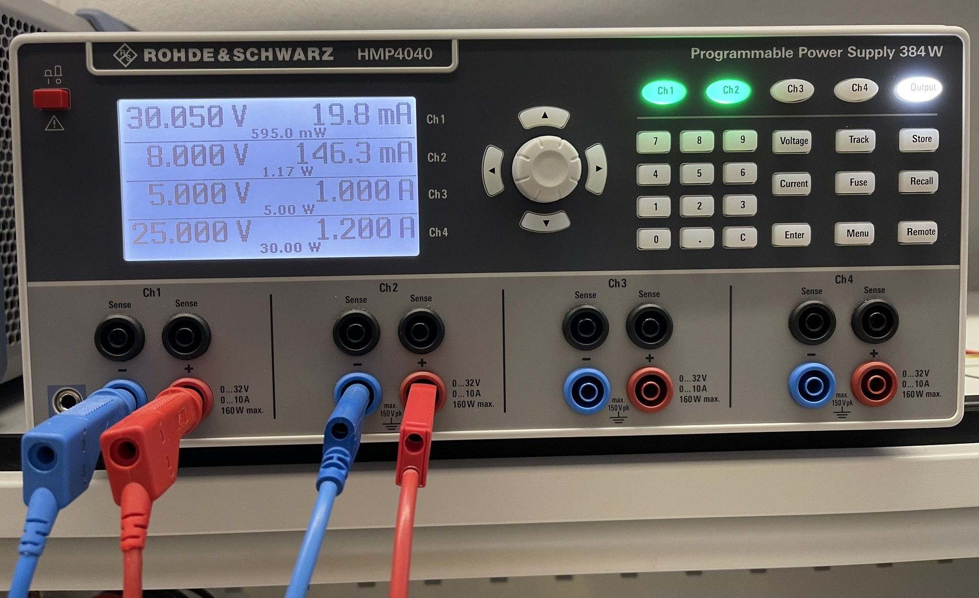
Pics_Labor/pps.jpg
