msayad97/Amplifier/Pics_Labor/psc.jpg

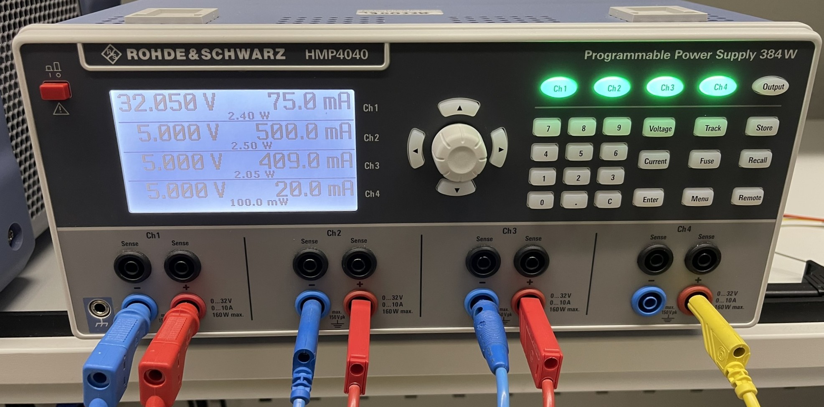
Pics_Labor/psc.jpg
