msayad97/Amplifier/Pics_Labor/pst.jpg

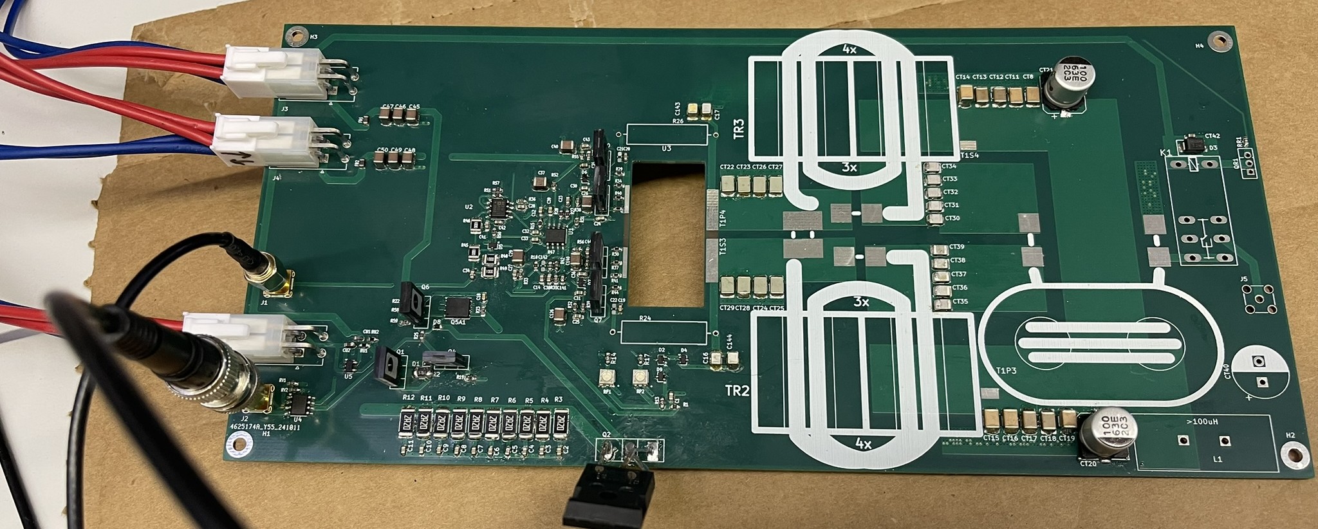
Pics_Labor/pst.jpg
