msayad97/Amplifier/Pics_Labor/Reflowofen.jpg

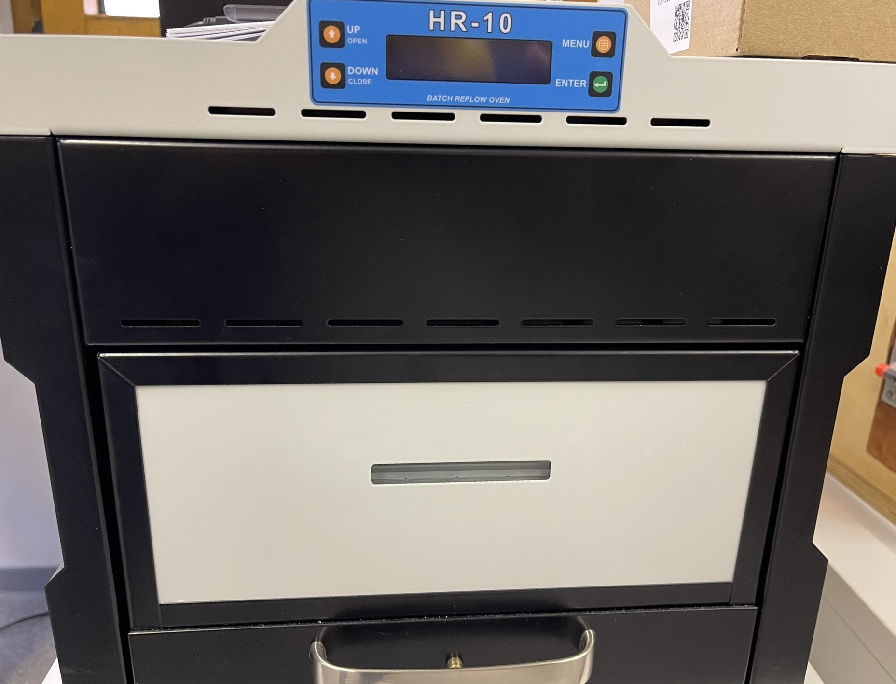
Pics_Labor/Reflowofen.jpg
