msayad97/Amplifier/Pics_Labor/Spannung_G.jpg

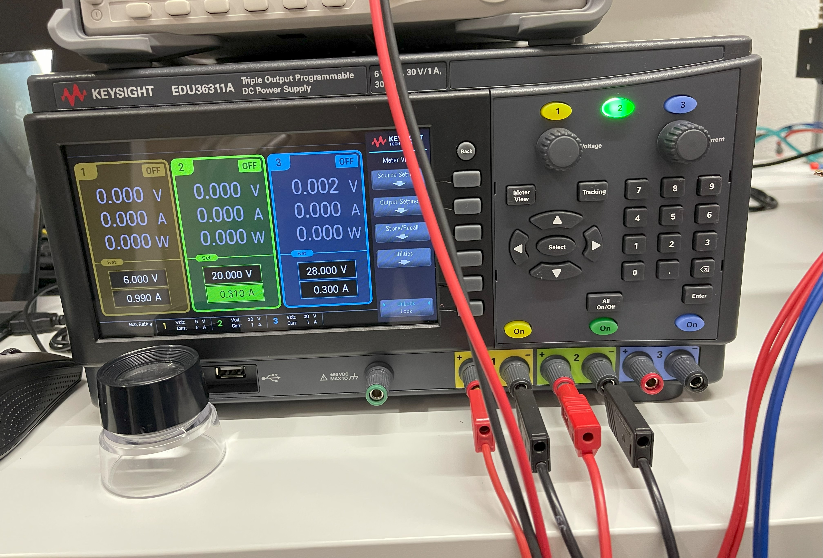
Pics_Labor/Spannung_G.jpg
