msayad97/Amplifier/Pics_Labor/spe.jpg

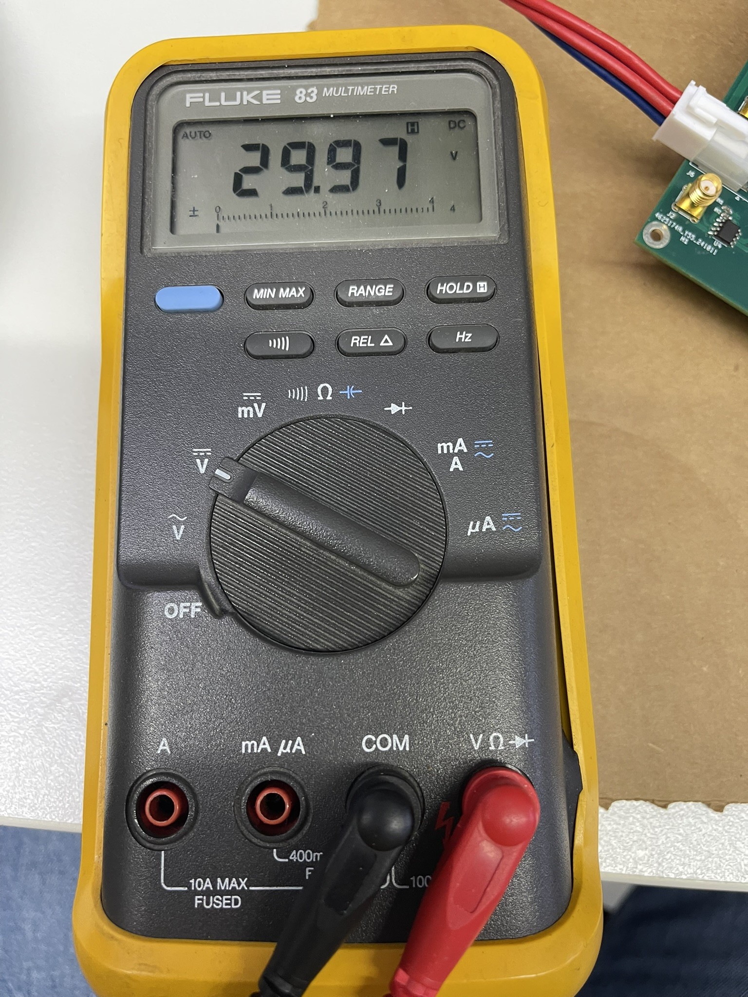
Pics_Labor/spe.jpg
