msayad97/Amplifier/Pics_Labor/wfg.jpg

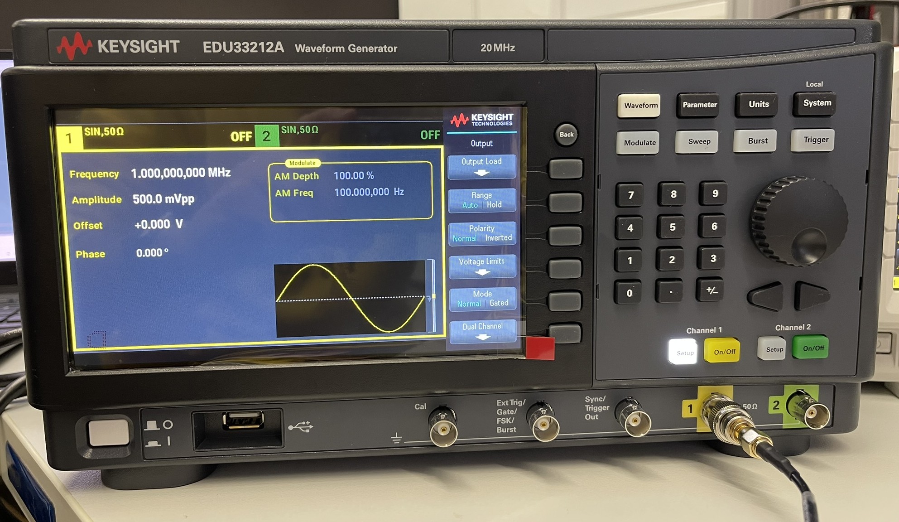
Pics_Labor/wfg.jpg
