msayad97/Amplifier/Parts.xlsx

Name | Zahl | Vorhanden | Value | Footprint | Link
Q2 | 1 | 2 | IXTH90P10P | TO247AA | https://www.mouser.de/ProductDetail/IXYS/IXTH90P10P?qs=cvHLLyFtoE2HXFAQhp8S5g%3D%3D
Q5 | 1 | 10 | BSC340N08NS3 | SO8_N | https://www.mouser.de/ProductDetail/Infineon-Technologies/BSC340N08NS3-G?qs=wK%252BoHS4yu56oxiRkZOh2VA%3D%3D
Q1, Q4, Q6, Q7, Q8, QR1 | 6 | 10 | BD139 | SOT-32 | https://www.mouser.de/ProductDetail/STMicroelectronics/BD139?qs=ljbEvF4DwOPW%2FLxHSWYMMA%3D%3D
Q9, Q10 | 2 | 0 | BD140 | SOT-32 | https://www.mouser.de/ProductDetail/STMicroelectronics/BD140?qs=ljbEvF4DwOOQh3TFtIzRQQ%3D%3D
D1, D8 | 2 | 19 | BAT54XV2T5G | ONSC-SOD-523 | https://www.mouser.de/ProductDetail/onsemi/BAT54XV2T5G?qs=Jh7l0IbPjidwB61nzvybLg%3D%3D
D2, D4, D5, D6, D7, D9 | 6 | 0 | BAV99WT1G | ONSC-SOT-323_SC-70 | https://www.mouser.de/ProductDetail/onsemi/BAV99WT1G?qs=vLkC5FC1VN9SjWG14gepYQ%3D%3D
D3 | 1 | 0 | Schottky Diode | SMB | https://www.mouser.de/ProductDetail/onsemi-Fairchild/S2M?qs=a0wxjULRyoFPR8XEAEgF8g%3D%3D
U1 | 1 | 0 | AD8017ARZ | SOIC-8_3.9x4.9mm | https://www.mouser.de/ProductDetail/Analog-Devices/AD8017ARZ?qs=%2FtpEQrCGXCxC1I0PLIQj%252Bw%3D%3D
U2 | 1 | 0 | AD8021ARZ | SOIC-8_3.9x4.9mm | https://www.mouser.de/ProductDetail/Analog-Devices/AD8021ARZ?qs=%2FtpEQrCGXCweFPqth1foHw%3D%3D
U3 | 1 | 0 | BLF188XRU | SOT-539A | https://www.digikey.de/de/products/detail/ampleon-usa-inc/568-10993-ND/4475922?productid=4475922&gad_source=1
U4 | 1 | 0 | AD8033 | SOIC-8_3.9x4.9mm | https://www.mouser.de/ProductDetail/Analog-Devices/AD8033ARZ
U5 | 1 | 0 | LT3014xS5 | SOT-23-5 | https://www.mouser.de/ProductDetail/Analog-Devices/LT3014ES5TRPBF?qs=ytflclh7QUWV0z9%2FazH%252BHQ%3D%3D
J3, J4, J6 | 3 | 0 | Molex Stecker | MOLEX_26013115 | https://www.mouser.de/ProductDetail/Molex/26-01-3115?qs=ZhwKFWhxrSGK%252BR23HkHJ9A%3D%3D
J1, J2, J5 | 3 | 0 | Connector_Coaxial | SMA_Amphenol_901-144_Vertical | https://www.mouser.de/ProductDetail/Amphenol-RF/901-144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
K1 | 1 | 0 | G5RL-1A-E-HR-DC24 |  | https://www.mouser.de/ProductDetail/Omron-Electronics/G5RL-1A-E-HR-DC24?qs=dLWB%2FtR6aAYjzNZDpNo%252BQw%3D%3D
L1 | 1 | 0 | Ferrite Ring | 74270115 | https://www.mouser.de/ProductDetail/Wurth-Elektronik/74270115?qs=5twSNpOB8ICdjrXY2lZ6Mg%3D%3D
TR1-TR4 | 8 | 0 | Ferrite Core | 875-28B0562-100 | https://www.mouser.de/ProductDetail/Laird-Performance-Materials/28B1020-100?qs=qgZcrvoyHAc38je3HtKGYg%3D%3D
Koaxialkabel | 2-3 m |  |  | RG-402 | https://www.digikey.de/de/products/filter/koaxialkabel-hf/475
Ferrite Bead | sind vorhanden ?
FB1, FB2 | 2 |  | BLM21PG300SN1B | SMD/SMT | https://www.mouser.de/ProductDetail/Murata-Electronics/BLM21PG300SN1B?qs=%2F%252BYoplLUB5gFXEj12WWW%2Fg%3D%3D
Resistors | sind vorhanden ?
R1, R15, R18, R25 | 4 |  | 4k7 | SM/R_0603 | https://www.mouser.de/ProductDetail/Panasonic/ERJ-3EKF4701V?qs=MVjVSMjNRMouVvwnqrpO2w%3D%3D
R23, R31, R32, R33, R36, R50, R52, R55, R56 | 9 |  | 2R2 | SM/R_0603 | https://www.mouser.de/ProductDetail/YAGEO/AF0603FR-072R2L?qs=tggtontpCXPYp5lxWRUBGQ%3D%3D
R27, R28, R51, R57 | 4 |  | 470R | SM/R_0603 | https://www.mouser.de/ProductDetail/Panasonic/ERJ-3EKF4700V?qs=MVjVSMjNRMpQ3VsSe9R%252BEw%3D%3D
R13, R14, R17 | 3 |  | 120R | SM/R_0603 | https://www.mouser.de/ProductDetail/Panasonic/ERJ-3EKF1200V?qs=iBwFsHVUAOfkZ4Bj0qjBGg%3D%3D
R29, R30 R34, R37, R40, R41, R43, R44 | 8 |  | 39R | SM/R_0603 | https://www.mouser.de/ProductDetail/Panasonic/ERJ-3EKF39R0V?qs=MVjVSMjNRMrPQ5sbEUWOOA%3D%3D
RV1 | 1 |  | 2k | SM/R_0603 | https://www.mouser.de/ProductDetail/Panasonic/ERJ-3EKF2001V?qs=66DK8nO8gJB6oRfYYGuuZQ%3D%3D
RV2, R38, R38, R53, R54 | 5 |  | 10k | SM/R_0603 | https://www.mouser.de/ProductDetail/Panasonic/ERJ-3EKF1002V?qs=H7k1u0Mp9JSrGPQ5%2F5COuw%3D%3D
RU1 | 1 |  | 25.2k | SM/R_0603 | https://www.mouser.de/ProductDetail/YAGEO/RT0603DRE0725K2L?qs=bQfrgN9vNvwDpsvHYd6T0A%3D%3D
RU2 | 1 |  | 1.35k | SM/R_0603 | https://www.mouser.de/ProductDetail/YAGEO/RT0603DRE071K35L?qs=bQfrgN9vNvxBhy5MLnTFmw%3D%3D
R22, R58, R59 | 3 |  | 220R/0.5W | SM/R_1210 | https://www.mouser.de/ProductDetail/YAGEO/RC1210FR-07220RL?qs=bz%2FLPVPAsTJDiDe0dEiWnQ%3D%3D
R2 | 1 |  | 30R/0.5W | SM/R_1210 | https://www.mouser.de/ProductDetail/YAGEO/RC1210FR-0730RL?qs=bz%2FLPVPAsTKt%2FuXlfH%252By9g%3D%3D
R45, R46, R48, R49 | 4 |  | 100R | SM/R_1210 | https://www.mouser.de/ProductDetail/YAGEO/RC1210FR-07100RL?qs=H6bTqIa4pvXUYEtXBKuT6Q%3D%3D
R19 | 1 |  | 120R | SM/R_1210 | https://www.mouser.de/ProductDetail/YAGEO/RC1210FR-07120RL?qs=H6bTqIa4pvXFKAQXn0HwSg%3D%3D
R35, R42, R47 | 3 |  | 220R | SM/R_1210 | https://www.mouser.de/ProductDetail/YAGEO/RC1210FR-07220RL?qs=bz%2FLPVPAsTJDiDe0dEiWnQ%3D%3D
R3 - R12 | 10 |  | 2R2 | SMD/R_2512 | https://www.mouser.de/ProductDetail/YAGEO/RC2512FK-072R2L?qs=GMd7ukQor4NniTQQgcp5QA%3D%3D
R24, R26 | 2 |  | 270R | THT | https://www.mouser.de/ProductDetail/Vishay-Beyschlag/MBA02040C2707JC100
RP1, RP2 | 2 |  | PVG3A504C01R00 | SMD/SMT-PVG3A | https://www.mouser.de/ProductDetail/Bourns/PVG3A504C01R00?qs=M0b1YOHIqsYRRc79b8YmqA%3D%3D
Capacitors | sind vorhanden ?
CT20, CT21 | 2 |  | 100u/63 | 10mm | https://www.mouser.de/ProductDetail/KEMET/EEV107M063A9PAA?qs=T9vdlufmP8xWnyLn5NExPw%3D%3D
CT40 | 1 |  | 470/63 | 12.5mm | https://www.mouser.de/ProductDetail/Panasonic/ECA-1JM471?qs=E4Q0ehfCm3r14YA4URj%252BEQ%3D%3D
C42 | 1 |  | 10p | SM/C_0603 | https://www.mouser.de/ProductDetail/YAGEO/CC0603JRNPO9BN100?qs=vTakOoo5QyIFwFOmdMrXhw%3D%3D
C34 | 1 |  | 4n7 | SM/C_0603 | https://www.mouser.de/ProductDetail/YAGEO/CC0603JRNPO9BN472?qs=mzRxyRlhVdt1Dpz0dRJBKQ%3D%3D
C18, C19, C20. CU1, CU2 | 5 |  | 1nF | SM/C_0603 | https://www.mouser.de/ProductDetail/YAGEO/CC0603JRNPO9BN102?qs=5q%252BqlK8CmJQpy%2F%252BA6LqOAg%3D%3D
C1 - C12, C14, C23, C24, C25, C27, C30, C31, C32, C33, C36, C38, C39, C28, C41, C43, C44 | 28 |  | 0.1uF | SM/C_0603 | https://www.mouser.de/ProductDetail/YAGEO/CC0603KRX7R9BB104?qs=vTakOoo5QyLvVCYM2ge8LQ%3D%3D
C21, C22, C142 | 3 |  | DNA | SM/C_0603
C16, C17, C143, C144 | 4 |  | 470p | SM/C_1210 | https://www.mouser.de/ProductDetail/YAGEO/CC1210JKNPOCBN471?qs=7s%252B3O6pAiyDWdRwrSwOy1Q%3D%3D
CT30 - CT 39 | 10 |  | 10n | SM/C_1210 | https://www.mouser.de/ProductDetail/Vishay/GA1210Y471KBEAR31G?qs=uwxL4vQweFMphFwYkYFSRw%3D%3D
C26, C29, C37, C40, C45 - C50, C126, C140 | 12 |  | 10uF | SM/C_1210 | https://www.mouser.de/ProductDetail/YAGEO/CC1210KKX5R9BB106?qs=vD1oOtXSXtyTFw74GyUNMg%3D%3D
CT22 - CT29 | 8 |  | 120p/3kW | SM/C_1812 | https://www.mouser.de/ProductDetail/Vishay-Vitramon/VJ1812A121KXGAT4X?qs=vnwGVgFuQibngR2KfGIO2g%3D%3D
CT8, CT11, CT15, CT16 | 4 |  | 10n/1kW | SM/C_1812 | https://www.mouser.de/ProductDetail/Vishay-Vitramon/VJ1812Y103MXGTW1BC?qs=9qnzKDpA3VCGTbAdPIIpZA%3D%3D
CT12, CT13, CT17, CT18 | 4 |  | 100n/500V | SM/C_1812 | https://www.mouser.de/ProductDetail/Vishay-Sprague/VJ1812Y104KXLAT4X?qs=8pwaB%2FoWVO0qwA%252BKaR5R%2Fg%3D%3D
CT14, CT19 | 2 |  | 1u/250V | SM/C_1812 | https://www.mouser.de/ProductDetail/KYOCERA-AVX/1812VC105KAT2A?qs=%252BdQmOuGyFcHXq8CuawQPbg%3D%3D
