msayad97/Amplifier/1kw-peak-rfpa-rc-1.0/1kw-peak-rfpa-rc-1.0/src/TODO capacitor-holder/20-04-02 Duitsland/Cad models/IWM37H-01-M304~Capacitor_holder_cover_PVC.dxf

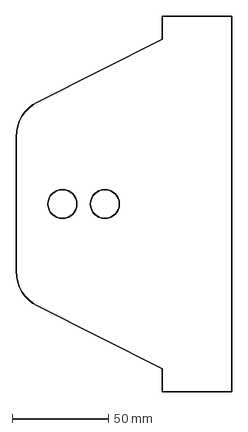
[picture p141: CAD file, 2024-08-07]
1kw-peak-rfpa-rc-1.0/1kw-peak-rfpa-rc-1.0/src/TODO capacitor-holder/20-04-02 Duitsland/Cad models/IWM37H-01-M304~Capacitor_holder_cover_PVC.dxf
111.8 x 194.6 mm
