msayad97/Amplifier/KiCad/3D models/PVG3A504C01R00.STEP

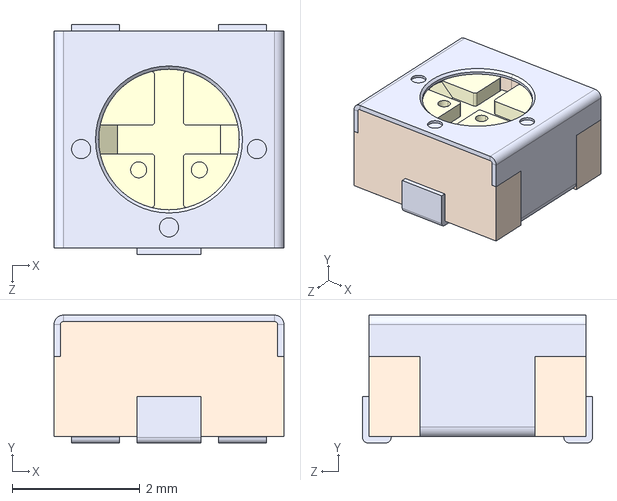
[picture p142: CAD file, 2024-08-15]
KiCad/3D models/PVG3A504C01R00.STEP
3.60 x 2.00 x 3.60 mm
