msayad97/Amplifier/KiCad/Projects/MRIAMP/ALTIUM_EMBEDDED_MODELS/DBZ0003AakaMF03A.stp

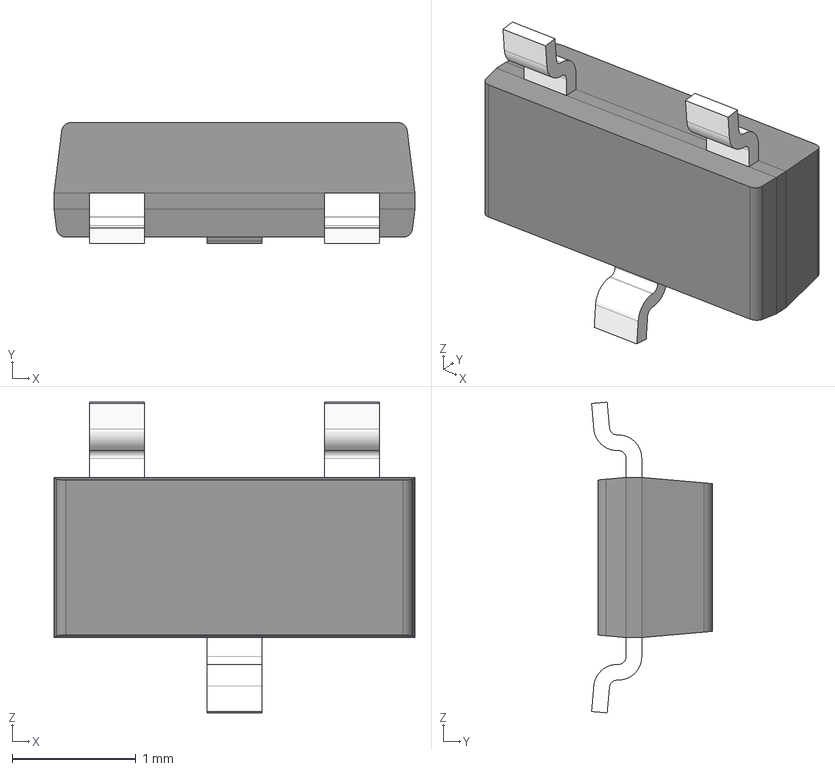
[picture p143: CAD file, 2024-08-07]
KiCad/Projects/MRIAMP/ALTIUM_EMBEDDED_MODELS/DBZ0003AakaMF03A.stp
2.92 x 0.978 x 2.51 mm
