msayad97/Amplifier/1kw-peak-rfpa-rc-1.0/1kw-peak-rfpa-rc-1.0/src/TODO capacitor-holder/20-04-02 Duitsland/Cad models/IWM37H-01-M305~Capacitor_con_plate_outer.dxf

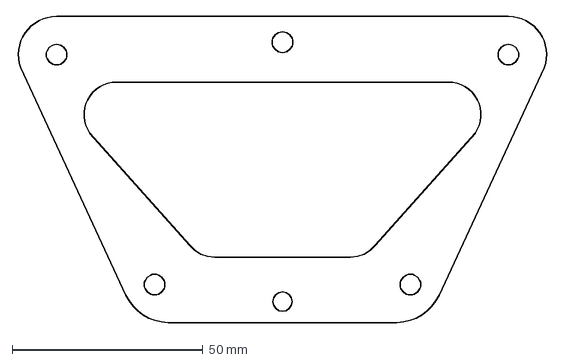
[picture p144: CAD file, 2024-08-07]
1kw-peak-rfpa-rc-1.0/1kw-peak-rfpa-rc-1.0/src/TODO capacitor-holder/20-04-02 Duitsland/Cad models/IWM37H-01-M305~Capacitor_con_plate_outer.dxf
139.3 x 80.1 mm
