msayad97/Amplifier/KiCad/3D models/BLM21PG300SN1B.STEP

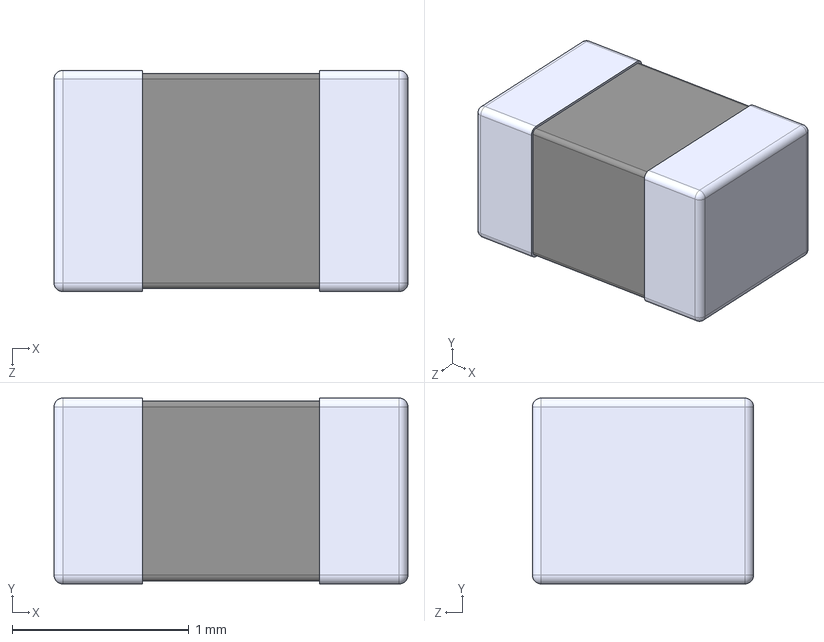
[picture p145: CAD file, 2024-08-15]
KiCad/3D models/BLM21PG300SN1B.STEP
2.00 x 1.05 x 1.25 mm
