msayad97/Amplifier/KiCad/Projects/MRIAMP/ALTIUM_EMBEDDED_MODELS/SOIC-14akaD0014AakaM14A.stp

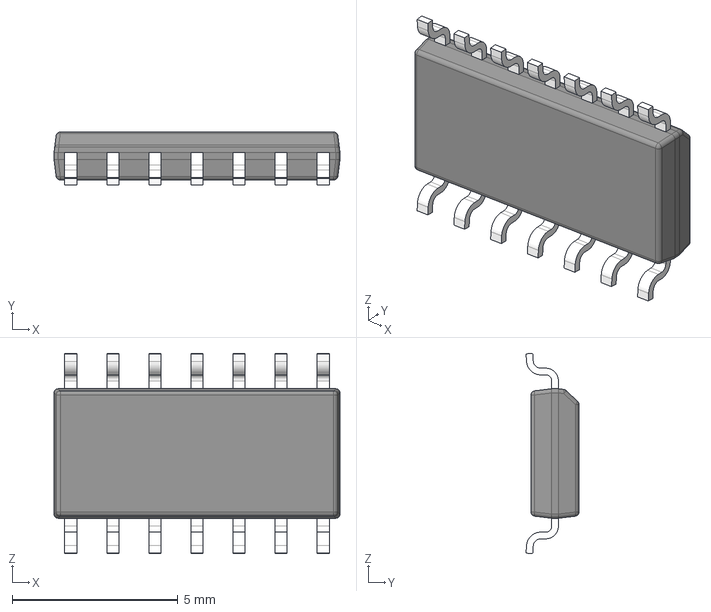
[picture p146: CAD file, 2024-08-07]
KiCad/Projects/MRIAMP/ALTIUM_EMBEDDED_MODELS/SOIC-14akaD0014AakaM14A.stp
8.64 x 1.60 x 6.05 mm
