msayad97/Amplifier/1kw-peak-rfpa-rc-1.0/1kw-peak-rfpa-rc-1.0/src/TODO capacitor-holder/20-04-02 Duitsland/Cad models/IWM37H-01-M306~Capacitor_con_plate_inner.dxf

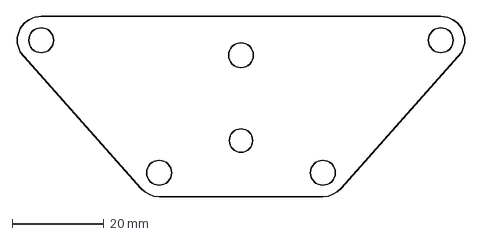
[picture p147: CAD file, 2024-08-07]
1kw-peak-rfpa-rc-1.0/1kw-peak-rfpa-rc-1.0/src/TODO capacitor-holder/20-04-02 Duitsland/Cad models/IWM37H-01-M306~Capacitor_con_plate_inner.dxf
97.8 x 39.2 mm
