msayad97/Amplifier/KiCad/3D models/26-01-3115--3DModel-STEP-269445.STEP

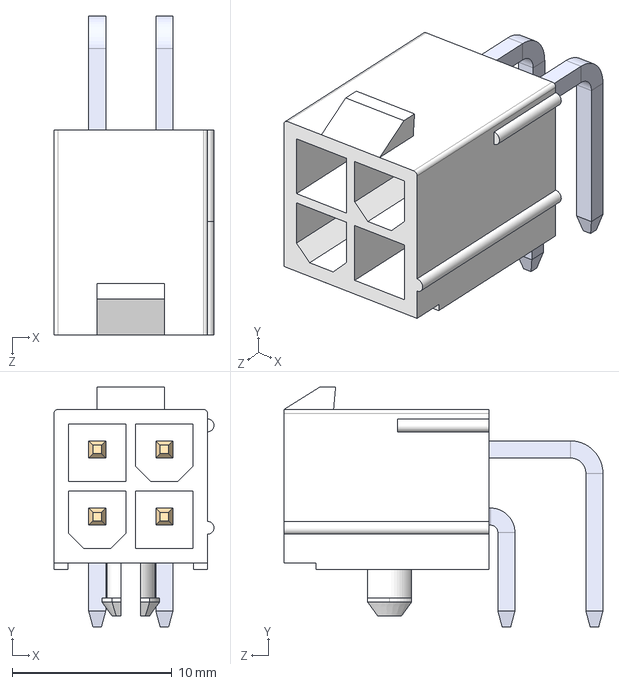
[picture p148: CAD file, 2024-08-15]
KiCad/3D models/26-01-3115--3DModel-STEP-269445.STEP
10.0 x 15.0 x 19.9 mm
