msayad97/Amplifier/1kw-peak-rfpa-rc-1.0/1kw-peak-rfpa-rc-1.0/src/TODO capacitor-holder/20-04-02 Duitsland/Cad models/IWM37H-01-M303~Capacitor_holder_cup_PVC.dxf

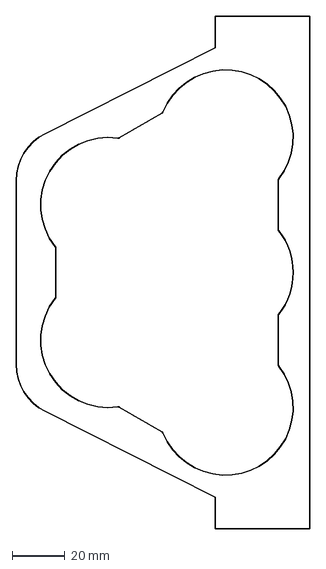
[picture p149: CAD file, 2024-08-07]
1kw-peak-rfpa-rc-1.0/1kw-peak-rfpa-rc-1.0/src/TODO capacitor-holder/20-04-02 Duitsland/Cad models/IWM37H-01-M303~Capacitor_holder_cup_PVC.dxf
111.5 x 194.6 mm
