msayad97/Amplifier/KiCad/3D models/901-144.stp

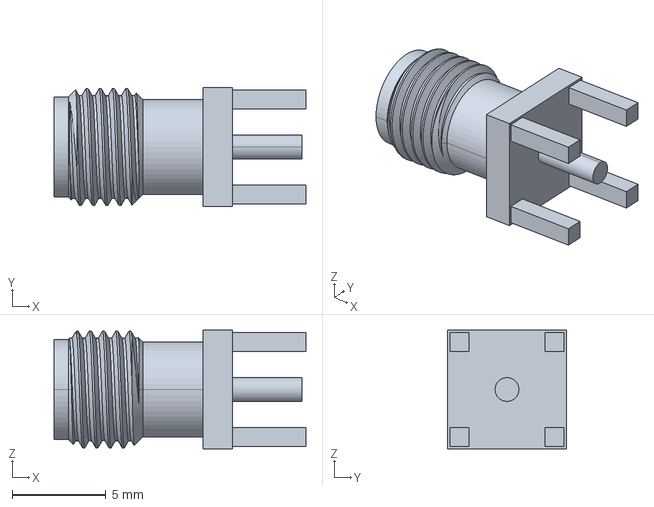
[picture p150: CAD file, 2024-08-15]
KiCad/3D models/901-144.stp
13.5 x 6.35 x 6.35 mm
