msayad97/Amplifier/KiCad/3D models/BLF188XRU.STEP

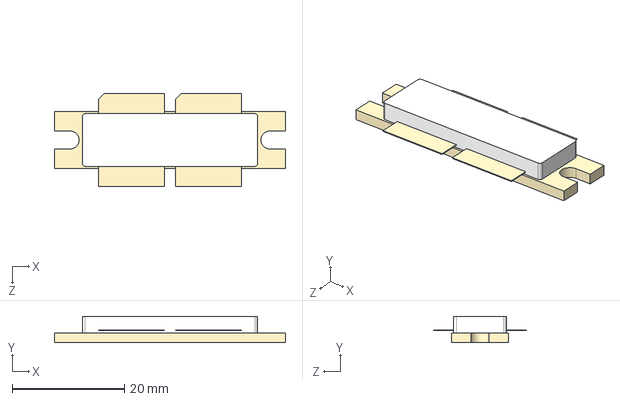
[picture p151: CAD file, 2024-07-07]
KiCad/3D models/BLF188XRU.STEP
41.2 x 4.70 x 16.6 mm
