msayad97/Amplifier/Pics_Labor/Test_V.jpg

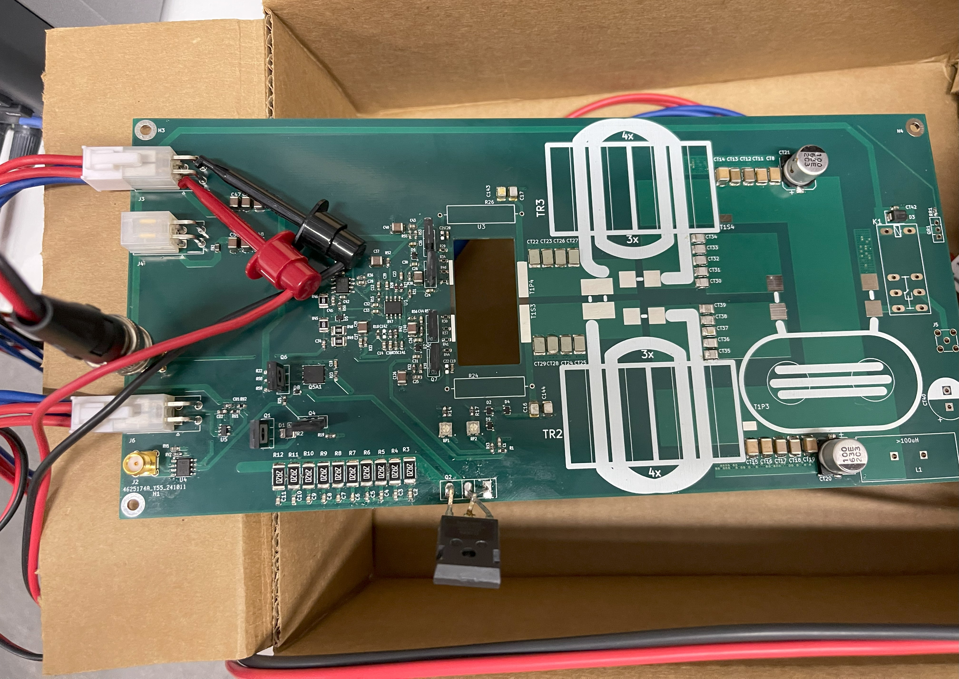
Pics_Labor/Test_V.jpg
