msayad97/Amplifier/1kw-peak-rfpa-rc-1.0/1kw-peak-rfpa-rc-1.0/src/TODO capacitor-holder/20-04-02 Duitsland/Drawings/IWM37H-01-M303~Capacitor_holder_cup_PVC.pdf

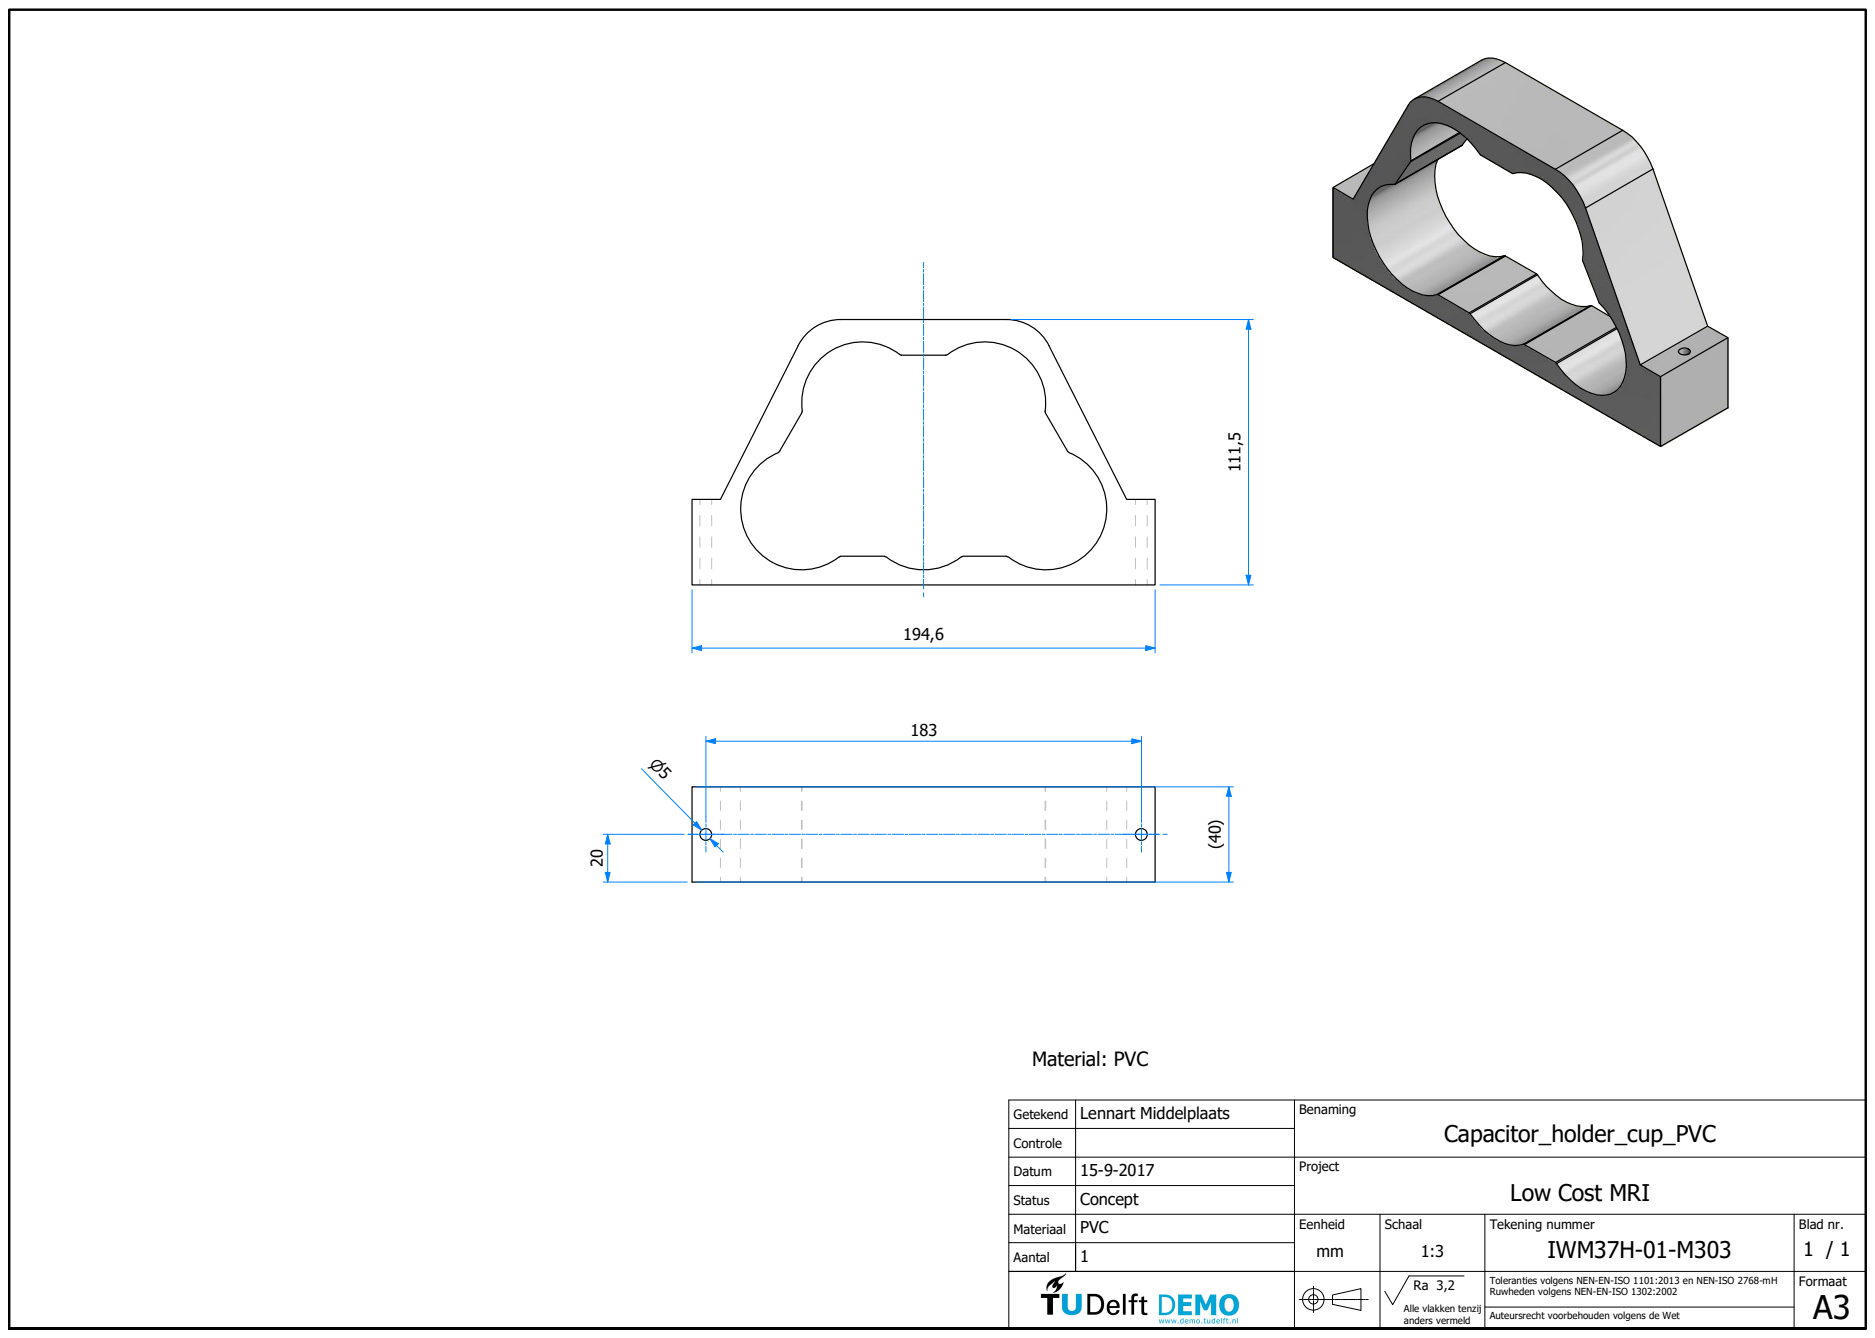
[picture p176: page 1]
Material: PVC

Getekend | Lennart Middelplaats | Benaming Capacitor_holder_cup_PVC

Controle
Datum | 15-9-2017 | Project Low Cost MRI

Status | Concept

Materiaal | PVC | Eenheid mm | Schaal 1:3 | Tekening nummer IWM37H-01-M303 | Blad nr. 1 / 1

Aantal | 1

Ra 3,2 Alle vlakken tenzij anders vermeld | Toleranties volgens NEN-EN-ISO 1101:2013 en NEN-ISO 2768-mH Ruwheden volgens NEN-EN-ISO 1302:2002 | Formaat A3

Auteursrecht voorbehouden volgens de Wet
