msayad97/Amplifier/1kw-peak-rfpa-rc-1.0/1kw-peak-rfpa-rc-1.0/src/TODO capacitor-holder/20-04-02 Duitsland/Drawings/IWM37H-01-M305~Capacitor_con_plate_outer.pdf

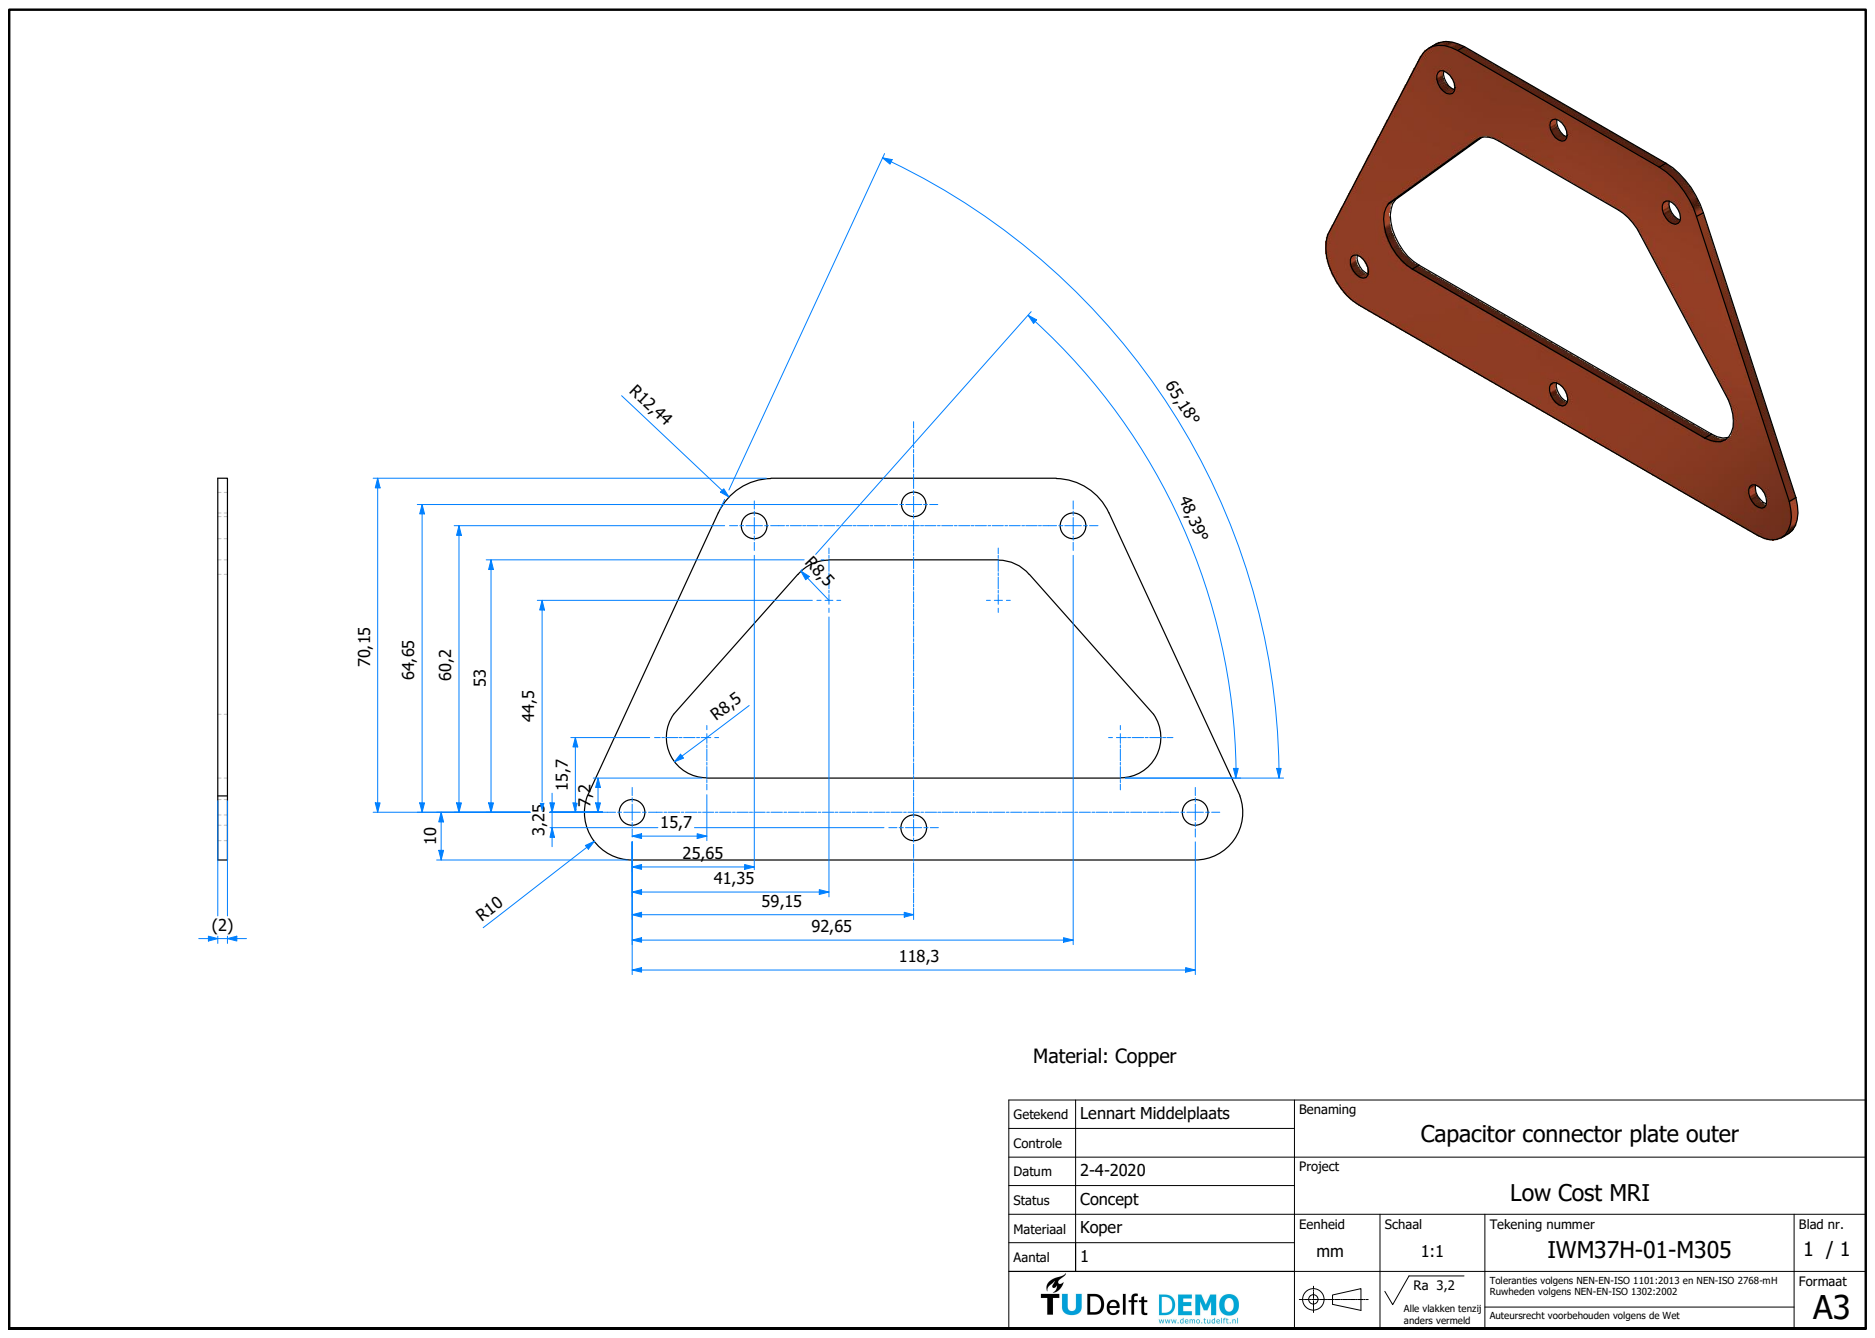
[picture p177: page 1]
Material: Copper

Getekend | Lennart Middelplaats | Benaming Capacitor connector plate outer

Controle
Datum | 2-4-2020 | Project Low Cost MRI

Status | Concept

Materiaal | Koper | Eenheid mm | Schaal 1:1 | Tekening nummer IWM37H-01-M305 | Blad nr. 1 / 1

Aantal | 1

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

Auteursrecht voorbehouden volgens de Wet
