msayad97/Amplifier/Schematic Prints AMP2.pdf

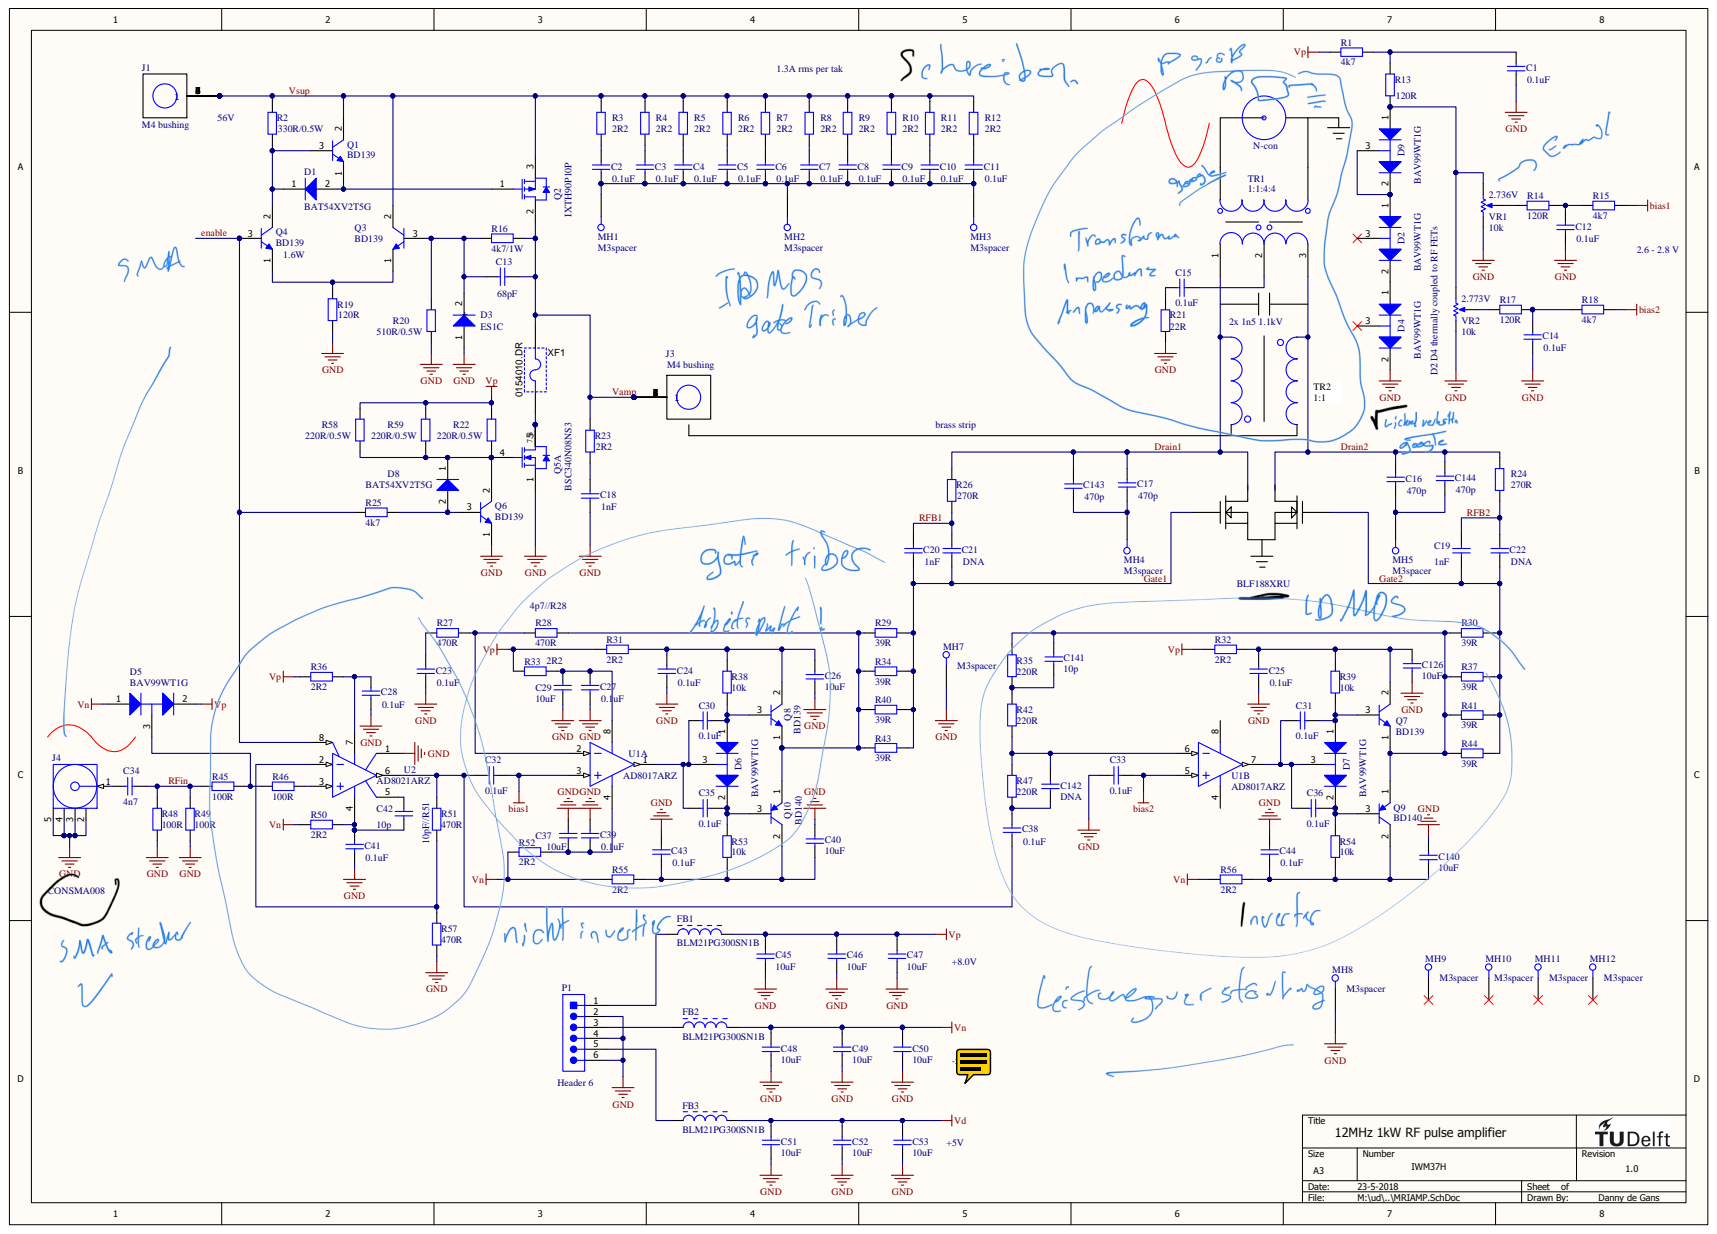
[picture p178: page 1]

D2 D4 thermally coupled to RF FETs
