msayad97/Amplifier/1kw-peak-rfpa-rc-1.0/1kw-peak-rfpa-rc-1.0/src/TODO capacitor-holder/20-04-02 Duitsland/Drawings/IWM37H-01-S013~Capacitor_holder.pdf

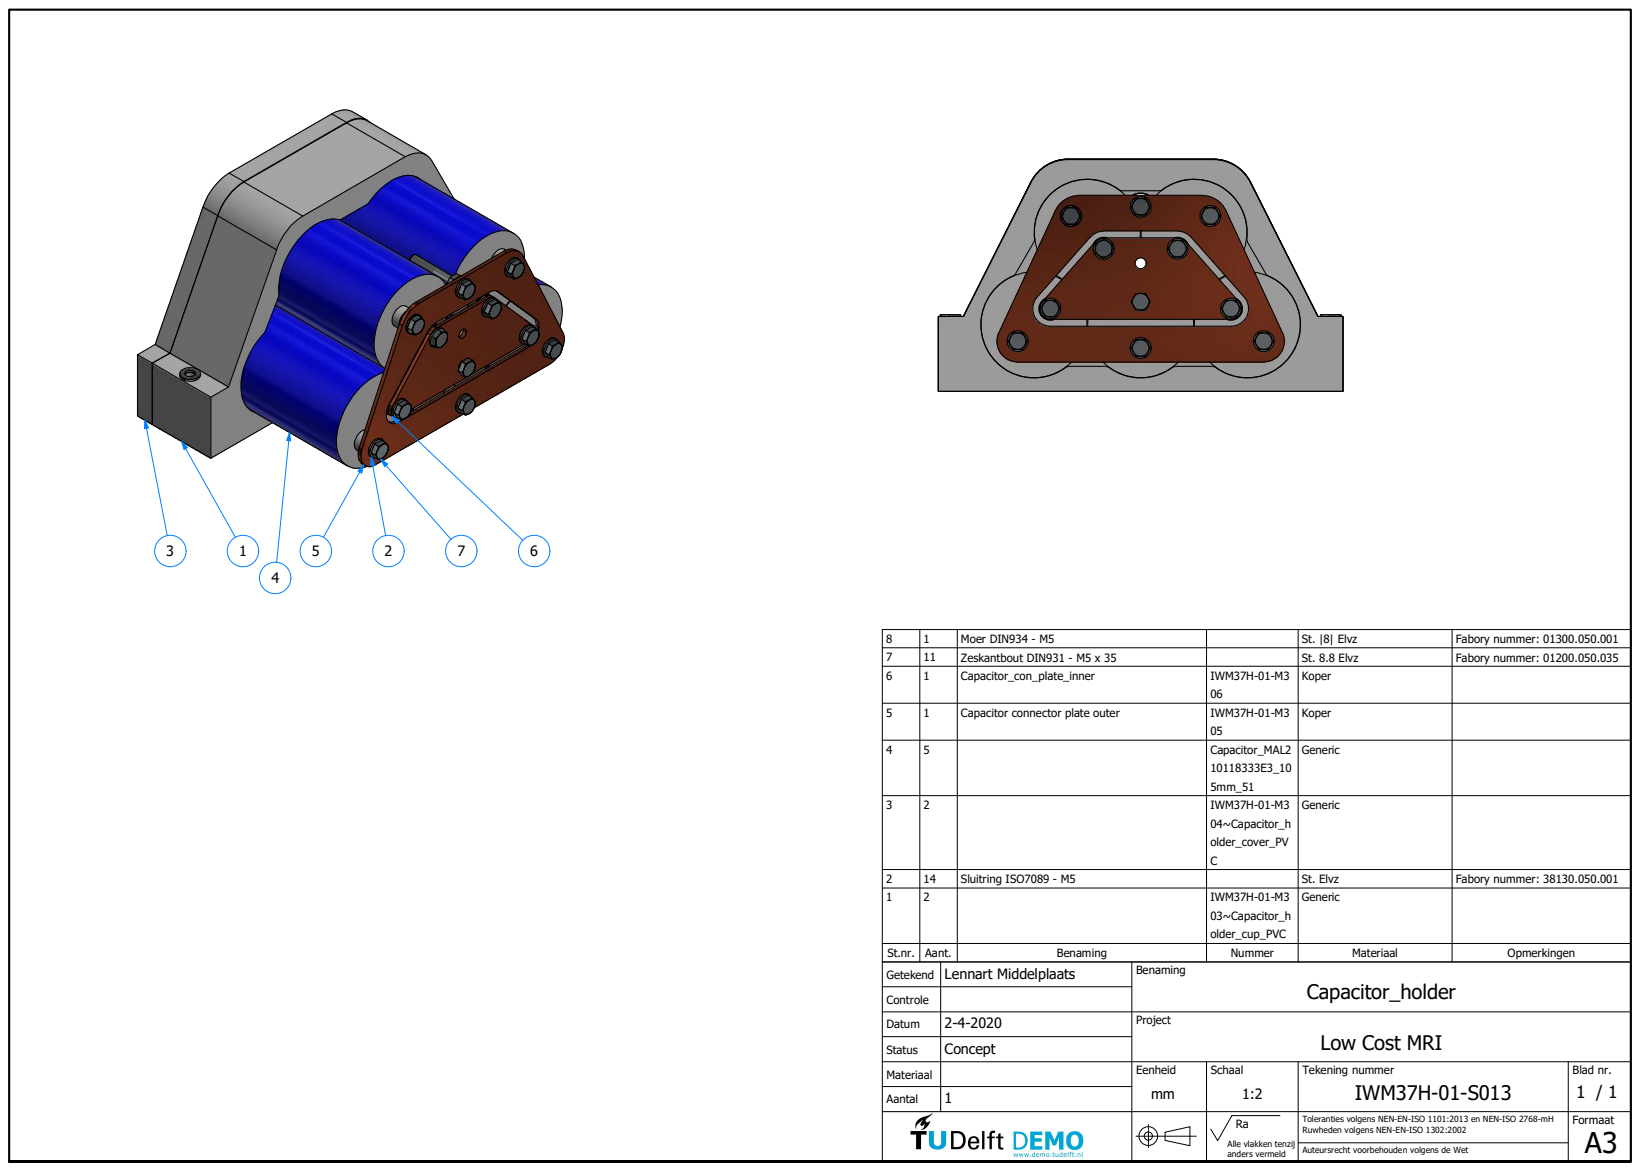
[picture p179: page 1]
al Controle; Project; Alle

8 | 1 | M o e r D I N 9 3 4 -M 5 | | S t . |8| Elv z | F a b o r y n u m m e r : 0 1 3 0 0 . 0 5 0 . 0 0 1
7 | 1 1 | Z e s k a n t b o u t D I N 9 3 1 -M 5 x 3 5 | | S t . 8 . 8 Elv z | F a b o r y n u m m e r : 0 1 2 0 0 . 0 5 0 . 0 3 5
6 | 1 | C a p a c i t o r _ c o n _ pla t e _ i n n e r | I W M 3 7 H -0 1 -M 3 0 6 | K o p e r

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

3 | 2 | | I W M 3 7 H -0 1 -M 3 0 4 ~ C a p a c i t o r_ h old e r_ c o v e r_ P V C | G e n e r i c

2 | 1 4 | Slu i t r i n g I S O 7 0 8 9 -M 5 | | S t . Elv z | F a b o r y n u m m e r : 3 8 1 3 0 . 0 5 0 . 0 0 1
1 | 2 | | I W M 3 7 H -0 1 -M 3 0 3 ~ C a p a c i t o r_ h old e r_ c u p _ P V C | G e n e r i c

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

M a t e r i a al Aantal | 1 | E e n h e i d m m | S c h a 1 : 2 | T e ke n i n g n u m m e r I W M 3 7 H -0 1 -S 0 1 3 | Bla d n r . 1 / 1
