msayad97/Amplifier/LTSpice/Simulations/Switch/Switch.asc

C2: cap; 0.1µ
C3: cap; 0.1µ
C4: cap; 0.1µ
C5: cap; 0.1µ
C6: cap; 0.1µ
C7: cap; 0.1µ
C8: cap; 0.1µ
C9: cap; 0.1µ
C10: cap; 0.1µ
C11: cap; 0.1µ
C18: cap; 1n
CU1: cap; 1µF
CU2: cap; 1µF
CU3: cap; 10µF
CU4: cap; 22µF
D1: diode; BAT54XV2T1G
D8: diode; BAT54XV2T1G
Q1: npn; BD139
Q2: pmos; RSQ035P03
Q3: npn; BD139
Q4: npn; BD139
Q5A: nmos; BSC340N08NS3
Q6: npn; BD139
R1: res; 1
R1V: res; 10k
R2: res; 5k76; pwr=0.5
R2V: res; 2k
R3: res; 2.2
R4: res; 2.2
R5: res; 2.2
R6: res; 2.2
R7: res; 2.2
R8: res; 2.2
R9: res; 2.2
R10: res; 2.2
R11: res; 2.2
R12: res; 2.2
R19: res; 1k27
R22: res; 220; pwr=0.5
R23: res; 2.2
R25: res; 4700
R58: res; 220; pwr=0.5
R59: res; 220; pwr=0.5
RU1: res; 1.35k
RU2: res; 25.2k
RU3: res; 1k
U1: LT3014
U2: AD8033
U3: LT1085-12
V2: voltage; PULSE(0V 3.3V 0.5u 1p 1p 0.5u 1u 4)
Vin: voltage; 30
Vp: voltage; 6
Named nets: 0, Vsup, Vamp, Vp, Tackt
.tran 4us
.lib C:\\Users\\msaya\\Documents\\Github\\Amplifier\\libs\\Bib.LIB
G
G
D
S
S
