msayad97/Amplifier/LTSpice/Simulations/Switch/Switch1.asc

C1: cap; 0.1µ
C2: cap; 0.1µ
C3: cap; 0.1µ
C4: cap; 0.1µ
C5: cap; 0.1µ
C6: cap; 0.1µ
C7: cap; 0.1µ
C8: cap; 0.1µ
C9: cap; 0.1µ
C10: cap; 0.1µ
C11: cap; 0.1µ
C13: cap; 68p
C18: cap; 1n
D1: diode; BAT54XV2T1G
D2.1: diode; BAT54XV2T1G
D2.2: diode; BAT54XV2T1G
D3: diode; ES1D
D4.1: diode; BAT54XV2T1G
D4.2: diode; BAT54XV2T1G
D8: diode; BAT54XV2T1G
D9.1: diode; BAT54XV2T1G
D9.2: diode; BAT54XV2T1G
Q1: npn; BD139
Q2: pmos; RSQ035P03
Q3: npn; BD139
Q4: npn; BD139
Q5A: nmos; BSC340N08NS3
Q6: npn; BD139
R1: res; 4k7
R2: res; 330; pwr=0.5
R3: res; 2.2
R4: res; 2.2
R5: res; 2.2
R6: res; 2.2
R7: res; 2.2
R8: res; 2.2
R9: res; 2.2
R10: res; 2.2
R11: res; 2.2
R12: res; 2.2
R13: res; 120
R14: res; 120
R15: res; 4k7
R16: res; 4k7
R17: res; 120
R18: res; 4k7
R19: res; 120
R20: res; 510R
R22: res; 220; pwr=0.5
R23: res; 2.2
R25: res; 4700
R58: res; 220; pwr=0.5
R59: res; 220; pwr=0.5
Rtest1: res; 1
V1: voltage; 56
V2: voltage; PULSE(0V 20V 0.5u 1n 1n 0.5u 1u 3)
Vd: voltage; 5
Vn: voltage; -4
Vp: voltage; 8
Named nets: 0, Vsup, Vp, Vamp, Tackt, bias1, bias2, Vn, Vd
.tran 4us
.lib C:\\Users\\msaya\\Documents\\Github\\Amplifier\\libs\\Bib.LIB
G
G
D
S
S
