msayad97/Amplifier/LTSpice/Simulations/OVtest/OVtest.asc

C28: cap; 0.1µ
C34: cap; 4.7n
C41: cap; 0.1µ
C42: cap; 10p
CR51: cap; 10p
D5.1: diode; BAT54XV2T1G
D5.2: diode; BAT54XV2T1G
R36: res; 2.2
R45: res; 100
R46: res; 100
R48: res; 100
R49: res; 100
R50: res; 2.2
R51: res; 470
R57: res; 470
U1: AD8029
V3: voltage; 8
V4: voltage; -4
V5: voltage; 5
V7: voltage; SINE(0V 10V 1MEG 0.5u)
Named nets: 0, Vp, Vn, Vd
.tran 5us
.lib C:\\Users\\msaya\\Documents\\Github\\Amplifier\\libs\\Bib.LIB
