msayad97/Amplifier/LTSpice/Simulations/PAmp/PAmp.asc

C1: cap; 0.1µ
C2: cap; 0.1µ
C3: cap; 0.1µ
C4: cap; 0.1µ
C5: cap; 0.1µ
C6: cap; 0.1µ
C7: cap; 0.1µ
C8: cap; 0.1µ
C9: cap; 0.1µ
C10: cap; 0.1µ
C11: cap; 0.1µ
C18: cap; 1n
C23: cap; 0.1µ
C24: cap; 0.1µ
C25: cap; 0.1µ
C26: cap; 10µ
C27: cap; 0.1µ
C28: cap; 0.1µ
C29: cap; 10µ
C30: cap; 0.1µ
C31: cap; 0.1µ
C32: cap; 0.1µ
C34: cap; 4.7n
C35: cap; 0.1µ
C36: cap; 0.1µ
C37: cap; 10µ
C38: cap; 0.1µ
C39: cap; 0.1µ
C40: cap; 10µ
C41: cap; 0.1µ
C42: cap; 10p
C43: cap; 0.1µ
C44: cap; 0.1µ
C126: cap; 10µ
C140: cap; 10µ
C141: cap; 10p
C142: cap; 0.1µ
CR51: cap; 10p
D1: diode; BAT54XV2T1G
D2.1: diode; BAT54XV2T1G
D2.2: diode; BAT54XV2T1G
D2: diode; BAT54XV2T1G
D4.1: diode; BAT54XV2T1G
D4.2: diode; BAT54XV2T1G
D5.1: diode; BAT54XV2T1G
D5.2: diode; BAT54XV2T1G
D6.1: diode; BAT54XV2T1G
D6.2: diode; BAT54XV2T1G
D7.1: diode; BAT54XV2T1G
D7.2: diode; BAT54XV2T1G
D9.1: diode; BAT54XV2T1G
D9.2: diode; BAT54XV2T1G
Q1: npn; BD139
Q2: pmos; RSQ035P03
Q4: npn; BD139
Q5A: nmos; BSC340N08NS3
Q6: npn; BD139
Q7: npn; BD139
Q8: npn; BD139
Q9: pnp; BD140
Q10: pnp; BD140
R1: res; 4k7
R1testt: res; 1Meg
R1testttt: res; 1Meg
R2: res; 330; pwr=0.5
R3: res; 2.2
R4: res; 2.2
R5: res; 2.2
R6: res; 2.2
R7: res; 2.2
R8: res; 2.2
R9: res; 2.2
R10: res; 2.2
R11: res; 2.2
R12: res; 2.2
R13: res; 120
R14: res; 120
R15: res; 4k7
R17: res; 120
R18: res; 4k7
R19: res; 120
R22: res; 220; pwr=0.5
R23: res; 2.2
R25: res; 4700
R27: res; 470
R28: res; 470
R29: res; 39
R30: res; 39
R31: res; 2R2
R32: res; 2R2
R33: res; 2R2
R34: res; 39
R35: res; 220
R36: res; 2.2
R37: res; 39
R38: res; 10k
R39: res; 10k
R40: res; 39
R41: res; 39
R42: res; 220
R43: res; 39
R44: res; 39
R45: res; 100
R46: res; 100
R47: res; 220
R48: res; 100
R49: res; 100
R50: res; 2.2
R51: res; 470
R52: res; 2R2
R53: res; 10k
R54: res; 10k
R55: res; 2R2
R56: res; 2R2
R57: res; 470
R58: res; 220; pwr=0.5
R59: res; 220; pwr=0.5
Rtest1: res; 1
U1: AD8021
U2.1: AD8017
U2: AD8017
V1: voltage; 56
V3: voltage; 8
V4: voltage; -4
V5: voltage; 5
V7: voltage; SINE(0V 10V 1MEG 0.5u)
Vtackt1: voltage; PULSE(0V 20V 0.5u 0 0 0.5u 1u 3)
Named nets: 0, Vp, Vn, Vd, 8, 4, bias1, bias2, Vsup, Vamp, Tackt
.tran 5us
.lib C:\\Users\\msaya\\Documents\\Github\\Amplifier\\libs\\Bib.LIB
G
G
D
S
S
