msayad97/Amplifier/LTSpice/Simulations/OVK/OV/OV.asc

C1: cap; 0.1µ
C16: cap; 470p
C17: cap; 470p
C19: cap; 1n
C20: cap; 1n
C23: cap; 0.1µ
C24: cap; 0.1µ
C25: cap; 0.1µ
C26: cap; 10µ
C27.2: cap; 0.1µ
C27: cap; 0.1µ
C28: cap; 0.1µ
C29.2: cap; 10µ
C29: cap; 10µ
C30: cap; 0.1µ
C31: cap; 0.1µ
C32: cap; 0.1µ
C33: cap; 0.1µ
C34: cap; 4.7n
C35: cap; 0.1µ
C36: cap; 0.1µ
C37.2: cap; 10µ
C37: cap; 10µ
C38: cap; 0.1µ
C39.2: cap; 0.1µ
C39: cap; 0.1µ
C40: cap; 10µ
C41: cap; 0.1µ
C42: cap; 10p
C43: cap; 0.1µ
C44: cap; 0.1µ
C126: cap; 10µ
C140: cap; 10µ
C141: cap; 10p
C143: cap; 470p
C144: cap; 470p
D2.1: diode; BAT54XV2T1G
D2.2: diode; BAT54XV2T1G
D4.1: diode; BAT54XV2T1G
D4.2: diode; BAT54XV2T1G
D5.1: diode; BAT54XV2T1G
D5.2: diode; BAT54XV2T1G
D6.1: diode; BAT54XV2T1G
D6.2: diode; BAT54XV2T1G
D7.1: diode; BAT54XV2T1G
D7.2: diode; BAT54XV2T1G
D9.1: diode; BAT54XV2T1G
D9.2: diode; BAT54XV2T1G
M1: nmos; BSP89
M2: nmos; BSP89
Q7: npn; BD139
Q8: npn; BD139
Q9: pnp; BD140
Q10: pnp; BD140
R1: res; 4k7
R1b: res; 6k
R2b: res; 3k
R3b: res; 6k
R4b: res; 3k
R13: res; 120
R14.1: res; 120
R14: res; 120
R15.1: res; 4k7
R15: res; 4k7
R17.1: res; 120
R17: res; 120
R18.1: res; 4k7
R18: res; 4k7
R24: res; 270R
R26: res; 270R
R27: res; 470
R28: res; 470
R29: res; 39
R30: res; 39
R31: res; 2R2
R32: res; 2R2
R33.2: res; 2R2
R33: res; 2R2
R34: res; 39
R35: res; 220
R36: res; 2.2
R37: res; 39
R38: res; 10k
R39: res; 10k
R40: res; 39
R41: res; 39
R42: res; 220
R43: res; 39
R44: res; 39
R45: res; 100
R46: res; 100
R47: res; 220
R48: res; 100
R49: res; 100
R50: res; 2.2
R51: res; 470
R52.2: res; 2R2
R52: res; 2R2
R53: res; 10k
R54: res; 10k
R55: res; 2R2
R56: res; 2R2
R57: res; 470
U1.1: AD8030
U1: AD8030
U2: AD8029
V1: voltage; 56
V3: voltage; 8
V4: voltage; -5
V5: voltage; 5
V7: voltage; SINE(0V 0.5V 1MEG 0.5u)
Named nets: 0, Vp, Vn, Vd, bias1, bias2, bias1_ideal, bias2_ideal
.tran 5us
.lib C:\\Users\\msaya\\Documents\\Github\\Amplifier\\libs\\Bib.LIB
