msayad97/Amplifier/LTSpice/Simulations/OVK/inv/inv.asc

C1: cap; 0.1µ
C25: cap; 0.1µ
C27: cap; 0.1µ
C29: cap; 10µ
C31: cap; 0.1µ
C33: cap; 0.1µ
C36: cap; 0.1µ
C37: cap; 10µ
C38: cap; 0.1µ
C39: cap; 0.1µ
C44: cap; 0.1µ
C126: cap; 10µ
C140: cap; 10µ
C141: cap; 10p
D2.1: diode; BAT54XV2T1G
D2.2: diode; BAT54XV2T1G
D4.1: diode; BAT54XV2T1G
D4.2: diode; BAT54XV2T1G
D7.1: diode; BAT54XV2T1G
D7.2: diode; BAT54XV2T1G
D9.1: diode; BAT54XV2T1G
D9.2: diode; BAT54XV2T1G
M1: nmos; BSP89
Q1: npn; BD139
Q2: pnp; BD140
R1: res; 4k7
R2: res; 120
R3: res; 4k7
R4: res; 6k
R5: res; 3k
R13: res; 120
R14: res; 120
R15: res; 4k7
R17: res; 120
R18: res; 4k7
R30: res; 39
R32: res; 2R2
R33: res; 2R2
R35: res; 220
R37: res; 39
R39: res; 10k
R41: res; 39
R42: res; 220
R44: res; 39
R47: res; 220
R52: res; 2R2
R54: res; 10k
R56: res; 2R2
U1: AD8030
V1: voltage; SINE(0 0.5V 1MEG 0.5us)
V2: voltage; 56
V3: voltage; 8
V4: voltage; -4
V5: voltage; 5
V6: voltage; 10
Named nets: Vp, Vn, Vd, 0, bias1, bias2, bias2_ideal
.tran 5us
.lib C:\\Users\\msaya\\Documents\\Github\\Amplifier\\libs\\Bib.LIB
