msayad97/Amplifier/LTSpice/Simulations/OVK/nicht_inv/nicht_inv.asc

C1: cap; 0.1µ
C12.1: cap; 0.1µ
C12: cap; 0.1µ
C14: cap; 0.1µ
C23: cap; 0.1µ
C24: cap; 0.1µ
C26: cap; 10µ
C27: cap; 0.1µ
C29: cap; 10µ
C30: cap; 0.1µ
C32: cap; 0.1µ
C35: cap; 0.1µ
C37: cap; 10µ
C39: cap; 0.1µ
C40: cap; 10µ
C43: cap; 0.1µ
D2.1: diode; BAT54XV2T1G
D2.2: diode; BAT54XV2T1G
D4.1: diode; BAT54XV2T1G
D4.2: diode; BAT54XV2T1G
D6.1: diode; BAT54XV2T1G
D6.2: diode; BAT54XV2T1G
D9.1: diode; BAT54XV2T1G
D9.2: diode; BAT54XV2T1G
M1: nmos; BSP89
Q8: npn; BD139
Q10: pnp; BD140
R1: res; 4k7
R2: res; 6k
R3: res; 3k
R4: res; 10
R13: res; 120
R14.1: res; 120
R14: res; 120
R15.1: res; 4k7
R15: res; 4k7
R17: res; 120
R18: res; 4k7
R27: res; 470
R28: res; 470
R29: res; 39
R31: res; 2R2
R33: res; 2R2
R34: res; 39
R38: res; 10k
R40: res; 39
R43: res; 39
R52: res; 2R2
R53: res; 10k
R55: res; 2R2
U1: AD8030
V1: voltage; 10
V2: voltage; 5
V3: voltage; 8
V4: voltage; -4
V5: voltage; 5
V7: voltage; SINE(0V 0.5V 1MEG 0.5u)
VR1.1: res; 1k
VR1.2: res; 10k
VR2.1: res; 2k
VR2.2: res; 8k
Named nets: Vp, Vn, Vd, 0, bias1, bias2, bias1_ideal
.tran 5us
.lib C:\\Users\\msaya\\Documents\\Github\\Amplifier\\libs\\Bib.LIB
