msayad97/Amplifier/(list of files, drawings)

Other design files:
1kw-peak-rfpa-rc-1.0/1kw-peak-rfpa-rc-1.0/src/MRIamp/monitoring.SchDoc
1kw-peak-rfpa-rc-1.0/1kw-peak-rfpa-rc-1.0/src/MRIamp/MRIAMP.PcbDoc
1kw-peak-rfpa-rc-1.0/1kw-peak-rfpa-rc-1.0/src/MRIamp/MRIamp.PcbLib
1kw-peak-rfpa-rc-1.0/1kw-peak-rfpa-rc-1.0/src/MRIamp/MRIAMP.SchDoc
1kw-peak-rfpa-rc-1.0/1kw-peak-rfpa-rc-1.0/src/MRIamp/MRIamp.SchLib
1kw-peak-rfpa-rc-1.0/1kw-peak-rfpa-rc-1.0/src/MRIamp/PCB_Project_MRIamp.PrjPCB
1kw-peak-rfpa-rc-1.0/1kw-peak-rfpa-rc-1.0/src/MRIamp/PCC-0339-00456-1/Released/INF-PG-TO247-3-44.PcbLib
1kw-peak-rfpa-rc-1.0/1kw-peak-rfpa-rc-1.0/src/MRIamp/stroomtrafo.SchLib
1kw-peak-rfpa-rc-1.0/1kw-peak-rfpa-rc-1.0/src/TrafoPCB-NoGap/TrafoPCB-NoGap.PcbDoc
1kw-peak-rfpa-rc-1.0/1kw-peak-rfpa-rc-1.0/src/TrafoPCB-WithGap/TrafoPCB-WithGap.PcbDoc
KiCad/Projects/MRIAMP/MRIAMP.PcbDoc
