msayad97/Amplifier/KiCad/Projects/Amplifier2/Amplifier2.kicad_pcb

## KiCad design KiCad/Projects/Amplifier2/Amplifier2.kicad_pcb (2025-01-21)

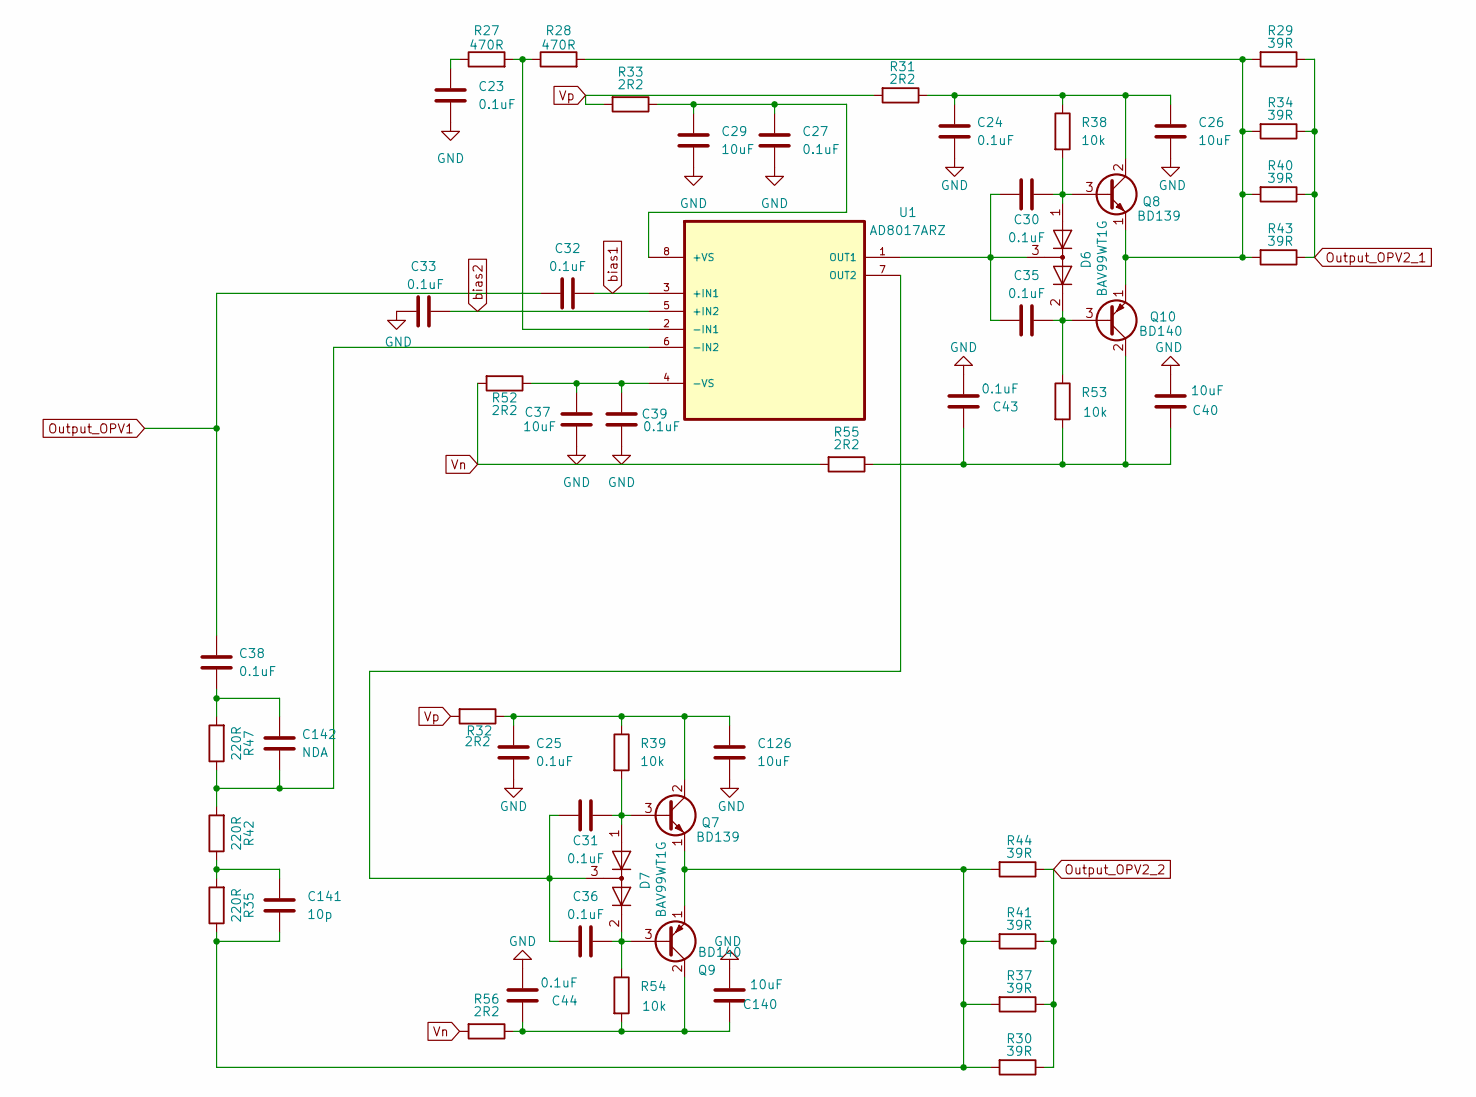
[picture p180: schematic OPV2.kicad_sch]

Parts:
C23, C24, C25, C27, C30, C31, C32, C33, C35, C36, C38, C39, C43, C44: 0.1uF; C_0603_1608Metric_Pad1.08x0.95mm_HandSolder
C26, C29, C37, C40, C126, C140: 10uF; C_1210_3225Metric_Pad1.33x2.70mm_HandSolder
C141: 10p; C_0603_1608Metric_Pad1.08x0.95mm_HandSolder
C142: NDA; C_0603_1608Metric_Pad1.08x0.95mm_HandSolder
D6, D7: BAV99WT1G; SOT-323_SC-70
Q7, Q8: BD139; TO-126-3_Vertical
Q9, Q10: BD140; TO-126-3_Vertical
R27, R28: 470R; R_0603_1608Metric_Pad0.98x0.95mm_HandSolder
R29, R30, R34, R37, R40, R41, R43, R44: 39R; R_0603_1608Metric_Pad0.98x0.95mm_HandSolder
R31, R32, R33, R52, R55, R56: 2R2; R_0603_1608Metric_Pad0.98x0.95mm_HandSolder
R35, R42, R47: 220R; R_0603_1608Metric_Pad0.98x0.95mm_HandSolder
R38, R39, R53, R54: 10k; R_0603_1608Metric_Pad0.98x0.95mm_HandSolder
U1: AD8017ARZ; SOIC-8_3.9x4.9mm_P1.27mm; MPN AD8017ARZ

Connections:
GND: C23.2, C24.2, C25.2, C26.2, C27.2, C29.2, C33.1, C37.2, C39.2, C40.2, C43.2, C44.2, C126.2, C140.2; also elsewhere on the board
unnamed: C23.1, R27.1
unnamed: C141.1, R35.2, R42.1
unnamed: C38.2, C142.1, R47.2
unnamed: C35.2, D6.2 (A), Q10.3 (B), R53.1
unnamed: C36.2, D7.2 (A), Q9.3 (B), R54.1
unnamed: C31.2, D7.1 (K), Q7.3 (B), R39.2
unnamed: C25.1, C126.1, Q7.2 (C), R32.1, R39.1
unnamed: C141.2, Q7.1 (E), Q9.1 (E), R30.2, R35.1, R37.2, R41.2, R44.2
unnamed: C30.2, D6.1 (K), Q8.3 (B), R38.2
unnamed: C24.1, C26.1, Q8.2 (C), R31.1, R38.1
unnamed: C44.1, C140.1, Q9.2 (C), R54.2, R56.1
unnamed: C40.1, C43.1, Q10.2 (C), R53.2, R55.1
unnamed: Q8.1 (E), Q10.1 (E), R28.2, R29.2, R34.2, R40.2, R43.2
unnamed: C27.1, C29.1, R33.1, U1.8 (+VS)
unnamed: R27.2, R28.1, U1.2 (-IN1)
unnamed: C142.2, R42.2, R47.1, U1.6 (-IN2)
unnamed: C37.1, C39.1, R52.1, U1.4 (-VS)
unnamed: C30.1, C35.1, D6.3 (K), U1.1 (OUT1)
unnamed: C31.1, C36.1, D7.3 (K), U1.7 (OUT2)
Output_OPV1: C32.1, C38.1; also elsewhere on the board
Output_OPV2_1: R29.1, R34.1, R40.1, R43.1; also elsewhere on the board
Output_OPV2_2: R30.1, R37.1, R41.1, R44.1; also elsewhere on the board
Vn: R52.2, R55.2, R56.2; also elsewhere on the board
Vp: R31.2, R32.2, R33.2; also elsewhere on the board
bias1: C32.2, U1.3 (+IN1); also elsewhere on the board
bias2: C33.2, U1.5 (+IN2); also elsewhere on the board

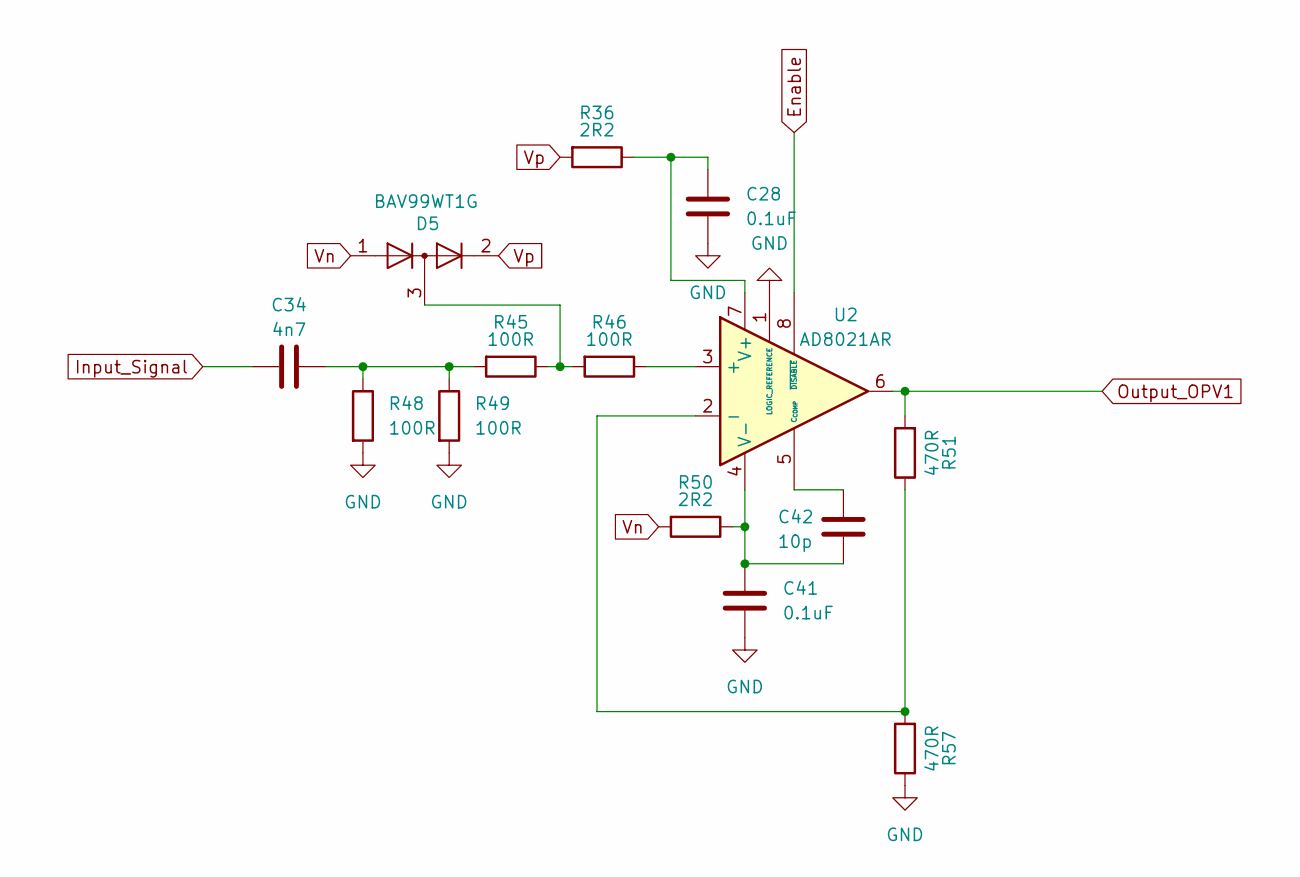
[picture p181: schematic OPV1.kicad_sch]

Parts:
C28, C41: 0.1uF; C_0603_1608Metric_Pad1.08x0.95mm_HandSolder
C34: 4n7; C_0603_1608Metric_Pad1.08x0.95mm_HandSolder
C42: 10p; C_0603_1608Metric_Pad1.08x0.95mm_HandSolder
D5: BAV99WT1G; SOT-323_SC-70
R36, R50: 2R2; R_0603_1608Metric_Pad0.98x0.95mm_HandSolder
R45, R46, R48, R49: 100R; R_1210_3225Metric_Pad1.30x2.65mm_HandSolder
R51, R57: 470R; R_0603_1608Metric_Pad0.98x0.95mm_HandSolder
U2: AD8021AR; SOIC-8_3.9x4.9mm_P1.27mm

Connections:
Enable: U2.8 (~DISABLE); also elsewhere on the board
GND: C28.2, C41.2, R48.2, R49.2, R57.1, U2.1 (LOGIC_REFERENCE); also elsewhere on the board
Input_Signal: C34.1; also elsewhere on the board
unnamed: C34.2, R45.2, R48.1, R49.1
unnamed: D5.3 (K), R45.1, R46.2
unnamed: R46.1, U2.3 (+)
unnamed: R51.1, R57.2, U2.2 (-)
unnamed: C42.1, U2.5 (C_{COMP})
unnamed: C28.1, R36.1, U2.7 (V+)
unnamed: C41.1, C42.2, R50.1, U2.4 (V-)
Output_OPV1: R51.2, U2.6; also elsewhere on the board
Vn: D5.1 (K), R50.2; also elsewhere on the board
Vp: D5.2 (A), R36.2; also elsewhere on the board

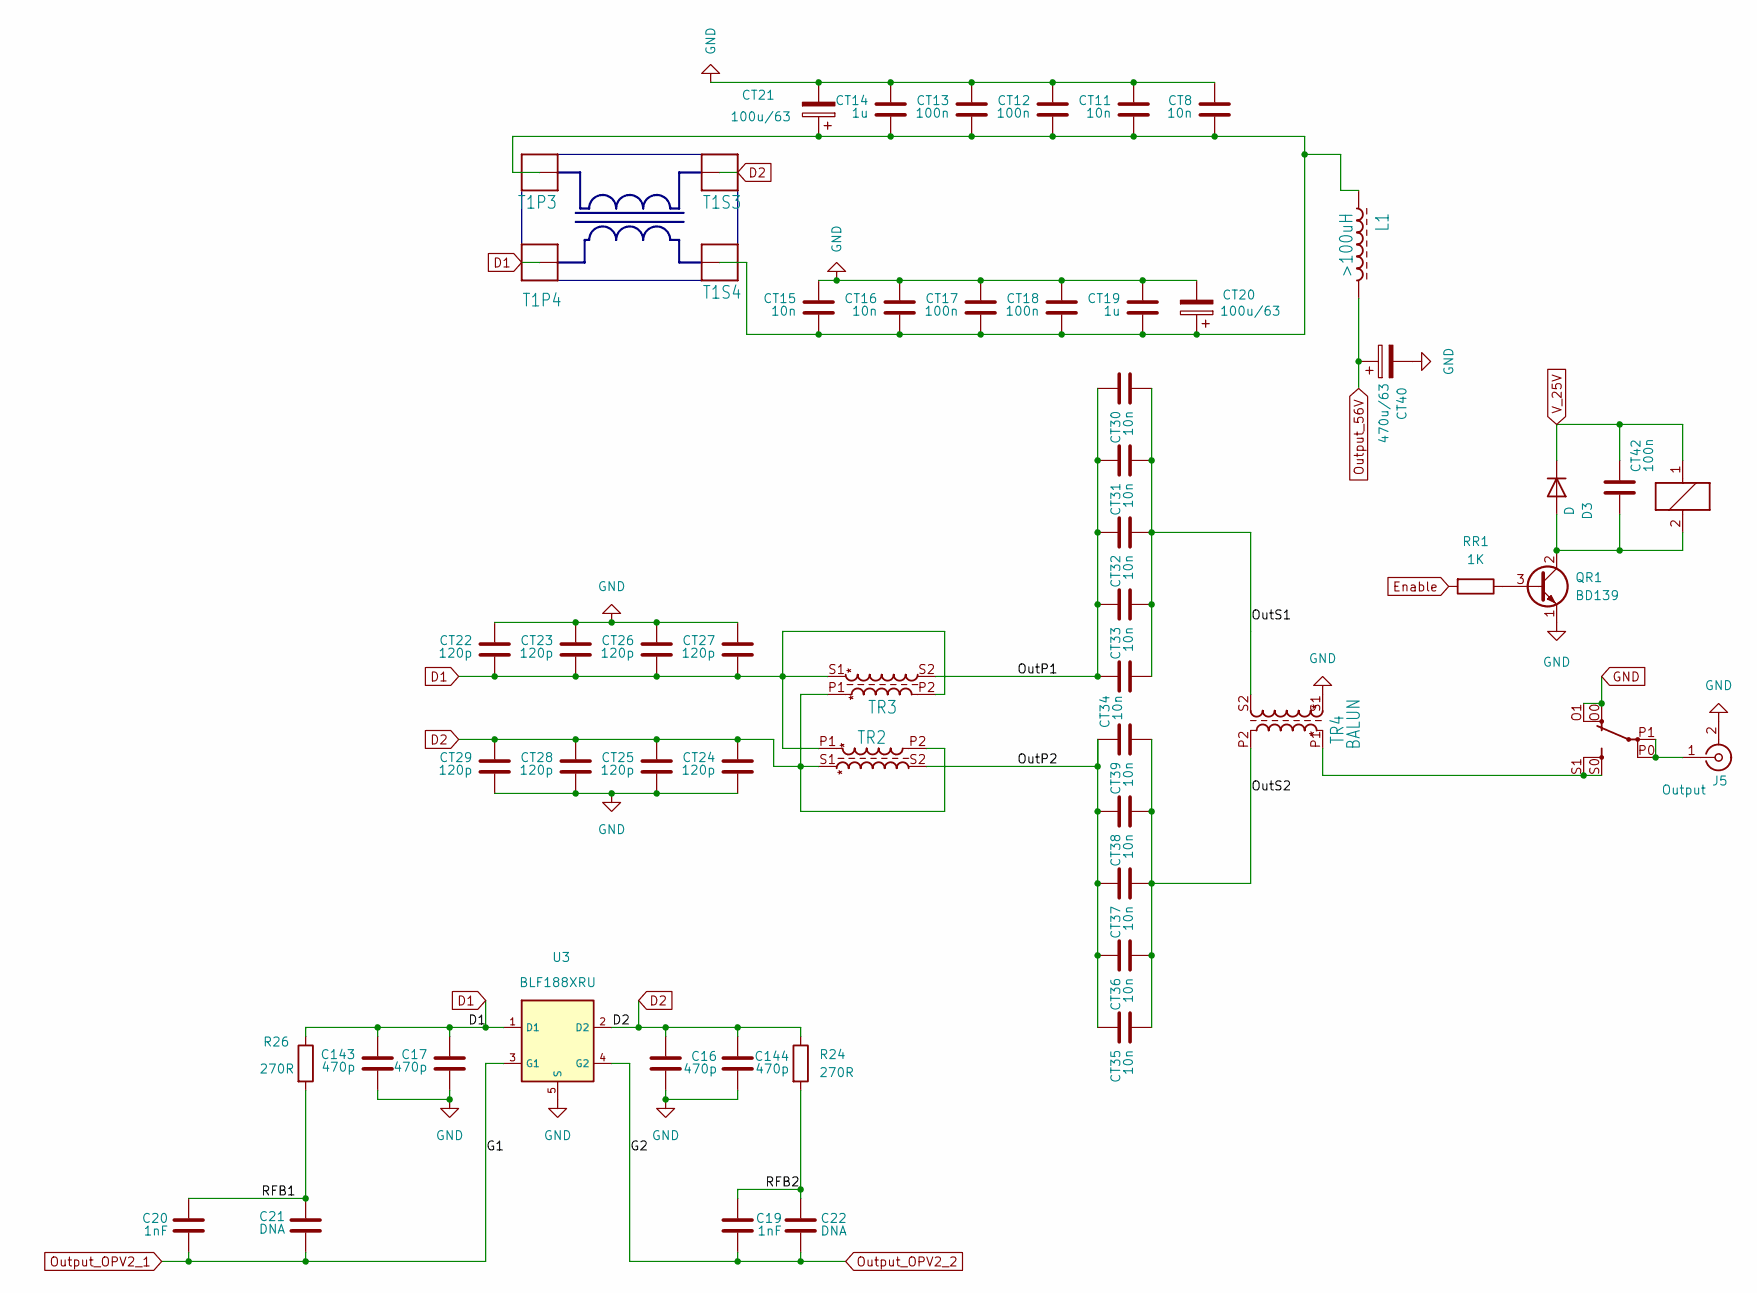
[picture p182: schematic HF_Part.kicad_sch]

Parts:
C16, C17, C143, C144: 470p; C_1210_3225Metric_Pad1.33x2.70mm_HandSolder
C19, C20: 1nF; C_0603_1608Metric_Pad1.08x0.95mm_HandSolder
C21, C22: DNA; C_0603_1608Metric_Pad1.08x0.95mm_HandSolder
CT8, CT11, CT15, CT16: 10n; C_1812_4532Metric_Pad1.57x3.40mm_HandSolder
CT12, CT13, CT17, CT18: 100n; C_1812_4532Metric_Pad1.57x3.40mm_HandSolder
CT14, CT19: 1u; C_1812_4532Metric_Pad1.57x3.40mm_HandSolder
CT20, CT21: 100u/63; CP_Elec_10x10.5
CT22, CT23, CT24, CT25, CT26, CT27, CT28, CT29: 120p; C_1812_4532Metric_Pad1.57x3.40mm_HandSolder
CT30, CT31, CT32, CT33, CT34, CT35, CT36, CT37, CT38, CT39: 10n; C_1210_3225Metric_Pad1.33x2.70mm_HandSolder
CT40: 470u/63; CP_Radial_D12.5mm_P5.00mm
CT42: 100n; C_0603_1608Metric_Pad1.08x0.95mm_HandSolder
D3: D; D_SMB
J5: Output; SMA_Amphenol_901-144_Vertical
K1: G2RE
L1: >100uH; KERN90_STEHEND_2PIN
QR1: BD139; TO-126-3_Vertical
R24, R26: 270R; AX_1.000X.225_.034
RR1: 1K; R_0603_1608Metric_Pad0.98x0.95mm_HandSolder
T1P3, T1P4, T1S3, T1S4: THICKPINSMD2,5X4; SMDPAD2,5X4
TR2: DOPPELRINGKERN
TR3: DOPPELRINGKERN_REV
TR4: BALUN; DOPPELLMANTEL_STEHEND
U3: BLF188XRU; BLF188

Connections:
/HF Part/OutP1: CT30.2, CT31.2, CT32.2, CT33.2, CT34.2, TR3.S2
/HF Part/OutP2: CT35.2, CT36.2, CT37.2, CT38.2, CT39.2, TR2.S2
/HF Part/OutS1: CT30.1, CT31.1, CT32.1, CT33.1, CT34.1, TR4.S2
/HF Part/OutS2: CT35.1, CT36.1, CT37.1, CT38.1, CT39.1, TR4.P2
/HF Part/RFB1: C20.2, C21.2, R26.2
/HF Part/RFB2: C19.2, C22.2, R24.2
D1: C17.2, C143.2, CT22.1, CT23.1, CT26.1, CT27.1, R26.1, T1P4.P$1 (1), TR2.P1, TR3.P2, TR3.S1, U3.1 (D1)
D2: C16.2, C144.2, CT24.2, CT25.2, CT28.2, CT29.2, R24.1, T1S3.P$1 (1), TR2.P2, TR2.S1, TR3.P1, U3.2 (D2)
Enable: RR1.2; also elsewhere on the board
GND: C16.1, C17.1, C143.1, C144.1, CT8.2, CT11.2, CT12.2, CT13.2, CT14.2, CT15.2, CT16.2, CT17.2, CT18.2, CT19.2, CT20.2, CT21.2, CT22.2, CT23.2, CT24.1, CT25.1, CT26.2, CT27.2, CT28.1, CT29.1, CT40.2, J5.2 (Ext), K1.O0 (O), K1.O1 (O@1), QR1.1 (E), TR4.S1, U3.5 (S); also elsewhere on the board
unnamed: CT42.2, D3.2 (A), K1.2, QR1.2 (C)
unnamed: J5.1 (In), K1.P0 (P@1), K1.P1
unnamed: K1.S0 (S), K1.S1 (S@1), TR4.P1
unnamed: CT8.1, CT11.1, CT12.1, CT13.1, CT14.1, CT15.1, CT16.1, CT17.1, CT18.1, CT19.1, CT20.1, CT21.1, L1.P$2 (2), T1P3.P$1 (1), T1S4.P$1 (1)
unnamed: QR1.3 (B), RR1.1
Output_56V: CT40.1, L1.P$1 (1); also elsewhere on the board
Output_OPV2_1: C20.1, C21.1, U3.3 (G1); also elsewhere on the board
Output_OPV2_2: C19.1, C22.1, U3.4 (G2); also elsewhere on the board
V_25V: CT42.1, D3.1 (K), K1.1; also elsewhere on the board

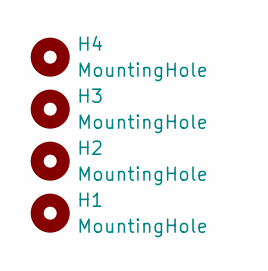
[picture p183: schematic MH_sch.kicad_sch]

Parts:
H1, H2, H3, H4: MountingHole; MountingHole_3.2mm_M3_Pad

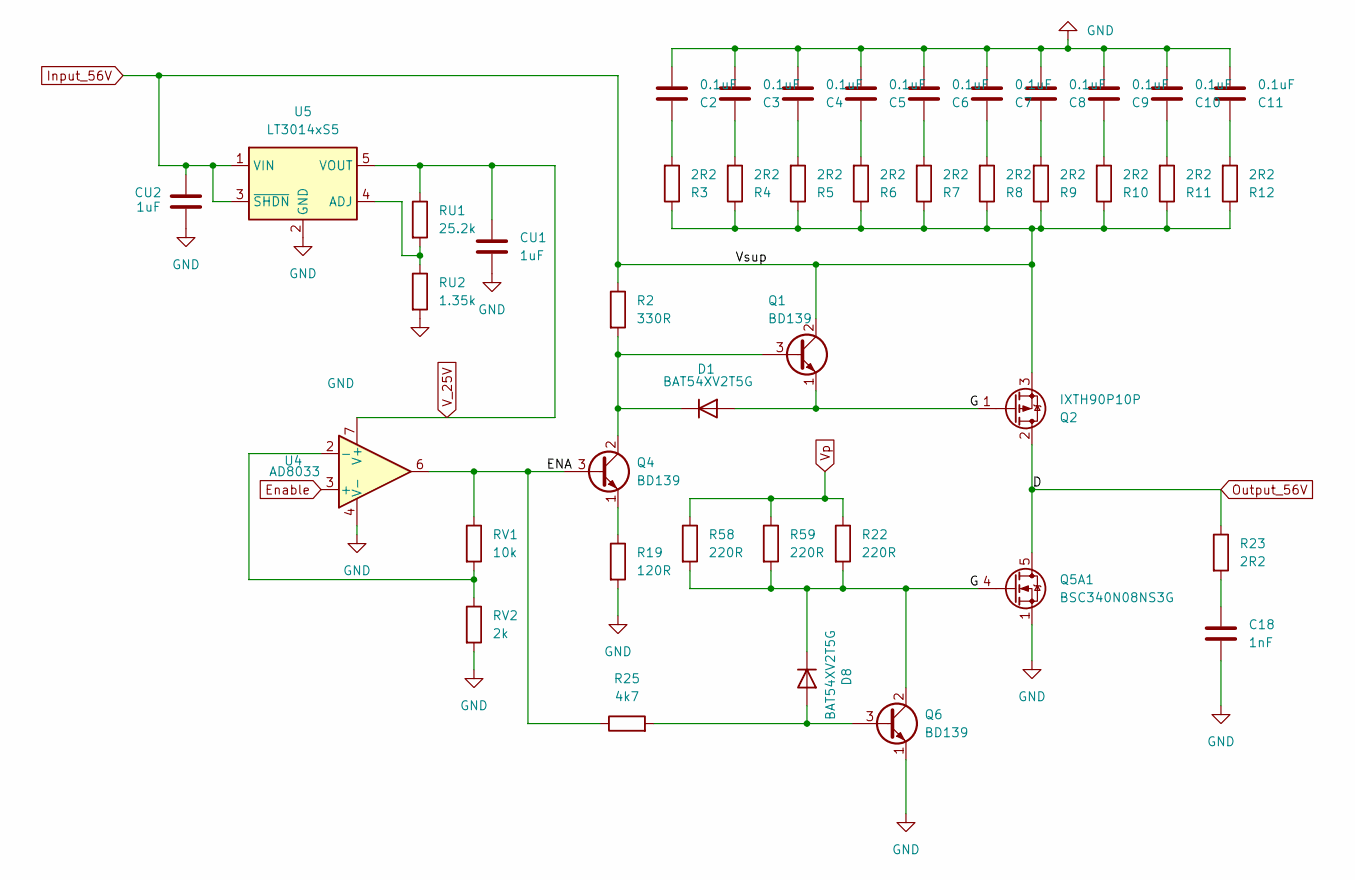
[picture p184: schematic Switch.kicad_sch]

Parts:
C2, C3, C4, C5, C6, C7, C8, C9, C10, C11: 0.1uF; C_0603_1608Metric_Pad1.08x0.95mm_HandSolder
C18: 1nF; C_0603_1608Metric_Pad1.08x0.95mm_HandSolder
CU1, CU2: 1uF; C_0603_1608Metric_Pad1.08x0.95mm_HandSolder
D1, D8: BAT54XV2T5G; D_SOD-523_new
Q1, Q4, Q6: BD139; TO-126-3_Vertical
Q2: IXTH90P10P; TO-247-3_MOSFET
Q5A1: BSC340N08NS3G; TDSON-8-1
R2: 330R; R_1210_3225Metric_Pad1.30x2.65mm_HandSolder
R3, R4, R5, R6, R7, R8, R9, R10, R11, R12: 2R2; R_2512_6332Metric_Pad1.40x3.35mm_HandSolder
R19: 120R; R_0603_1608Metric_Pad0.98x0.95mm_HandSolder
R22, R58, R59: 220R; R_0603_1608Metric_Pad0.98x0.95mm_HandSolder
R23: 2R2; R_0603_1608Metric_Pad0.98x0.95mm_HandSolder
R25: 4k7; R_0603_1608Metric_Pad0.98x0.95mm_HandSolder
RU1: 25.2k; R_0603_1608Metric_Pad0.98x0.95mm_HandSolder
RU2: 1.35k; R_0603_1608Metric_Pad0.98x0.95mm_HandSolder
RV1: 10k; R_0603_1608Metric_Pad0.98x0.95mm_HandSolder
RV2: 2k; R_0603_1608Metric_Pad0.98x0.95mm_HandSolder
U4: AD8033; SOIC-8_3.9x4.9mm_P1.27mm
U5: LT3014xS5; SOT-23-5

Connections:
/Switch/ENA: Q4.3 (B), R25.1, RV1.1, U4.6
/Switch/G: D1.1 (A), D8.2 (K), Q1.1 (E), Q2.1 (G), Q5A1.4 (G), Q6.2 (C), R22.2, R58.2, R59.2
Enable: U4.3 (+); also elsewhere on the board
GND: C2.2, C3.2, C4.2, C5.2, C6.2, C7.2, C8.2, C9.2, C10.2, C11.2, C18.2, CU1.2, CU2.2, Q5A1.1 (S), Q5A1.2 (S), Q5A1.3 (S), Q6.1 (E), R19.2, RU2.2, RV2.2, U4.4 (V-), U5.2 (GND); also elsewhere on the board
Input_56V: CU2.1, Q1.2 (C), Q2.3 (S), R2.1, R3.1, R4.1, R5.1, R6.1, R7.1, R8.1, R9.1, R10.1, R11.1, R12.1, U5.1 (VIN), U5.3 (~SHDN); also elsewhere on the board
unnamed: C2.1, R3.2
unnamed: C3.1, R4.2
unnamed: C4.1, R5.2
unnamed: C5.1, R6.2
unnamed: C6.1, R7.2
unnamed: C7.1, R8.2
unnamed: C8.1, R9.2
unnamed: C9.1, R10.2
unnamed: C10.1, R11.2
unnamed: C11.1, R12.2
unnamed: C18.1, R23.2
unnamed: D1.2 (K), Q1.3 (B), Q4.2 (C), R2.2
unnamed: D8.1 (A), Q6.3 (B), R25.2
unnamed: Q4.1 (E), R19.1
unnamed: RV1.2, RV2.1, U4.2 (-)
unnamed: RU1.2, RU2.1, U5.4 (ADJ)
Output_56V: Q2.2 (D), Q5A1.5 (D), R23.1; also elsewhere on the board
V_25V: CU1.1, RU1.1, U4.7 (V+), U5.5 (VOUT); also elsewhere on the board
Vp: R22.1, R58.1, R59.1; also elsewhere on the board

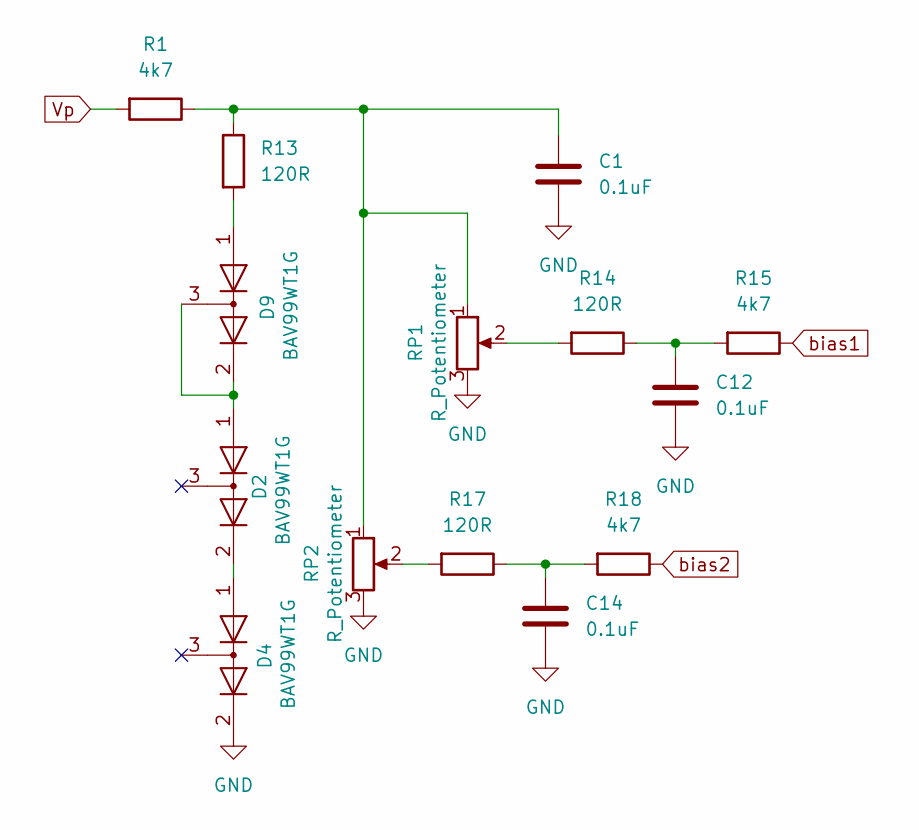
[picture p185: schematic Bias.kicad_sch]

Parts:
C1, C12, C14: 0.1uF; C_0603_1608Metric_Pad1.08x0.95mm_HandSolder
D2, D4, D9: BAV99WT1G; SOT-323_SC-70
R1, R15, R18: 4k7; R_0603_1608Metric_Pad0.98x0.95mm_HandSolder
R13, R14, R17: 120R; R_0603_1608Metric_Pad0.98x0.95mm_HandSolder
RP1, RP2: R_Potentiometer; PVG3A

Connections:
GND: C1.2, C12.2, C14.2, D4.2 (A), RP1.3, RP2.3; also elsewhere on the board
unnamed: C1.1, R1.1, R13.1, RP1.1, RP2.1
unnamed: C12.1, R14.1, R15.2
unnamed: C14.1, R17.1, R18.2
unnamed: D2.2 (A), D4.1 (K)
unnamed: D2.1 (K), D9.2 (A), D9.3 (K)
unnamed: D9.1 (K), R13.2
unnamed: R14.2, RP1.2
unnamed: R17.2, RP2.2
Vp: R1.2; also elsewhere on the board
bias1: R15.1; also elsewhere on the board
bias2: R18.1; also elsewhere on the board

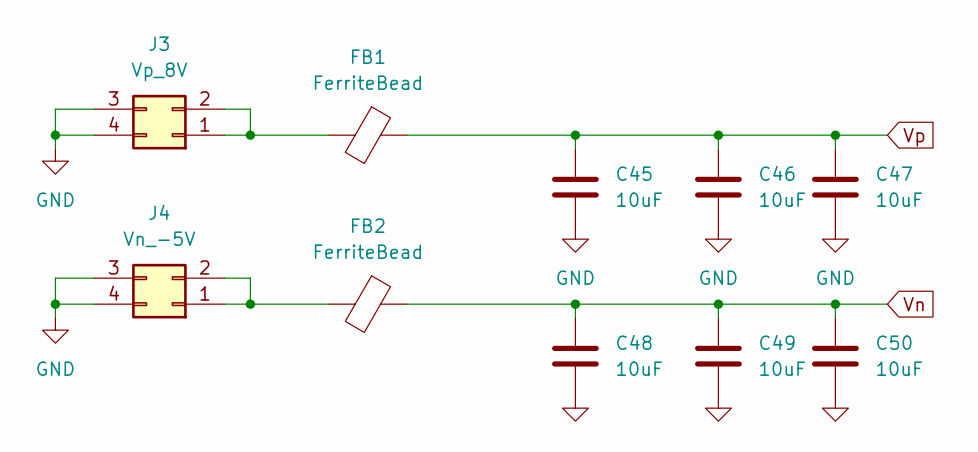
[picture p186: schematic Voltage_Supply.kicad_sch]

Parts:
C45, C46, C47, C48, C49, C50: 10uF; C_1210_3225Metric_Pad1.33x2.70mm_HandSolder
FB1, FB2: FerriteBead; BLM21PG300SN1B
J3: Vp_8V; MOLEX_26013115
J4: Vn_-5V; MOLEX_26013115

Connections:
GND: C45.2, C46.2, C47.2, C48.2, C49.2, C50.2, J3.3, J3.4, J4.3, J4.4; also elsewhere on the board
unnamed: FB1.2, J3.1, J3.2
unnamed: FB2.2, J4.1, J4.2
Vn: C48.1, C49.1, C50.1, FB2.1; also elsewhere on the board
Vp: C45.1, C46.1, C47.1, FB1.1; also elsewhere on the board

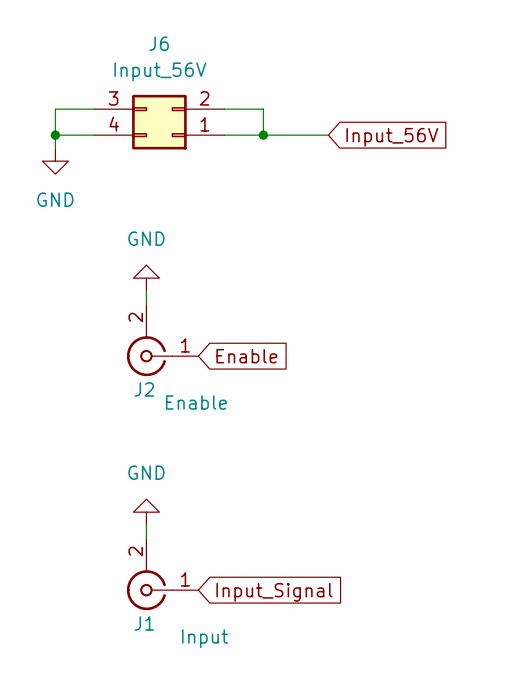
[picture p187: schematic Inputs.kicad_sch]

Parts:
J1: Input; SMA_Amphenol_901-144_Vertical
J2: Enable; SMA_Amphenol_901-144_Vertical
J6: Input_56V; MOLEX_26013115

Connections:
Enable: J2.1 (In); also elsewhere on the board
GND: J1.2 (Ext), J2.2 (Ext), J6.3, J6.4; also elsewhere on the board
Input_56V: J6.1, J6.2; also elsewhere on the board
Input_Signal: J1.1 (In); also elsewhere on the board

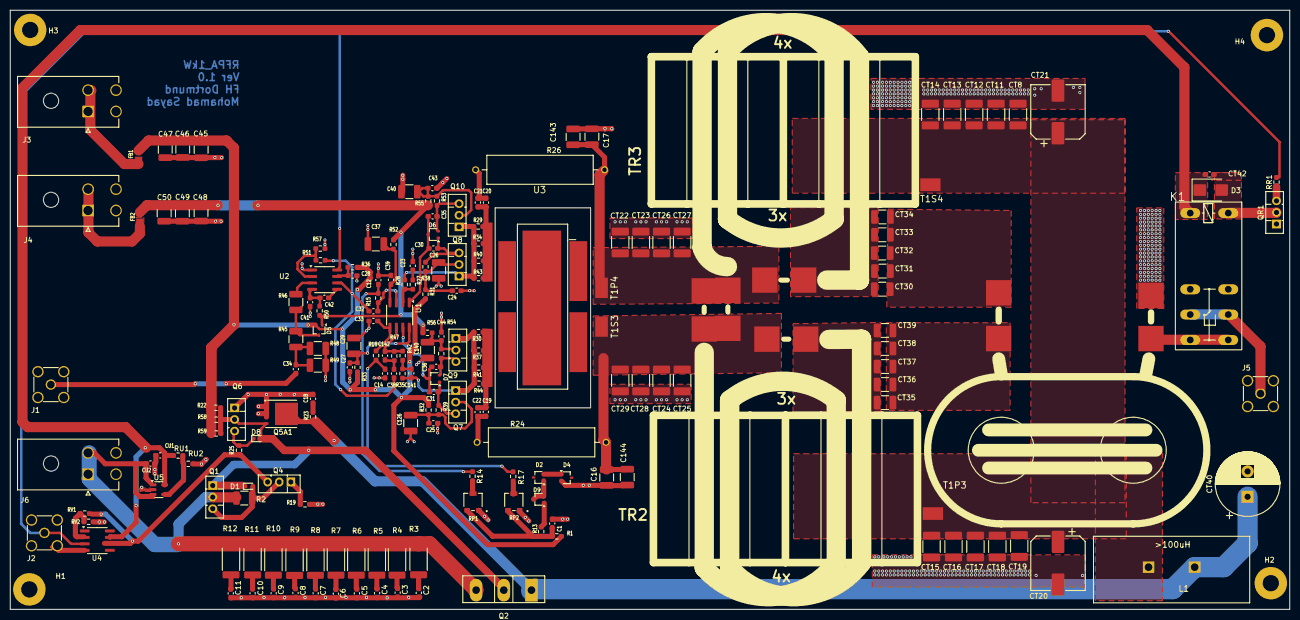
[picture p188: board Amplifier2.kicad_pcb from above]

Board: 4 copper layers, 252.0 x 118.0 mm, 196 parts (0 on the bottom side), 80 nets.
