msayad97/Amplifier/KiCad/Projects/kwpa_ldmos2/kwpa_ldmos2.kicad_pcb

## KiCad design KiCad/Projects/kwpa_ldmos2/kwpa_ldmos2.kicad_pcb (2024-08-29)

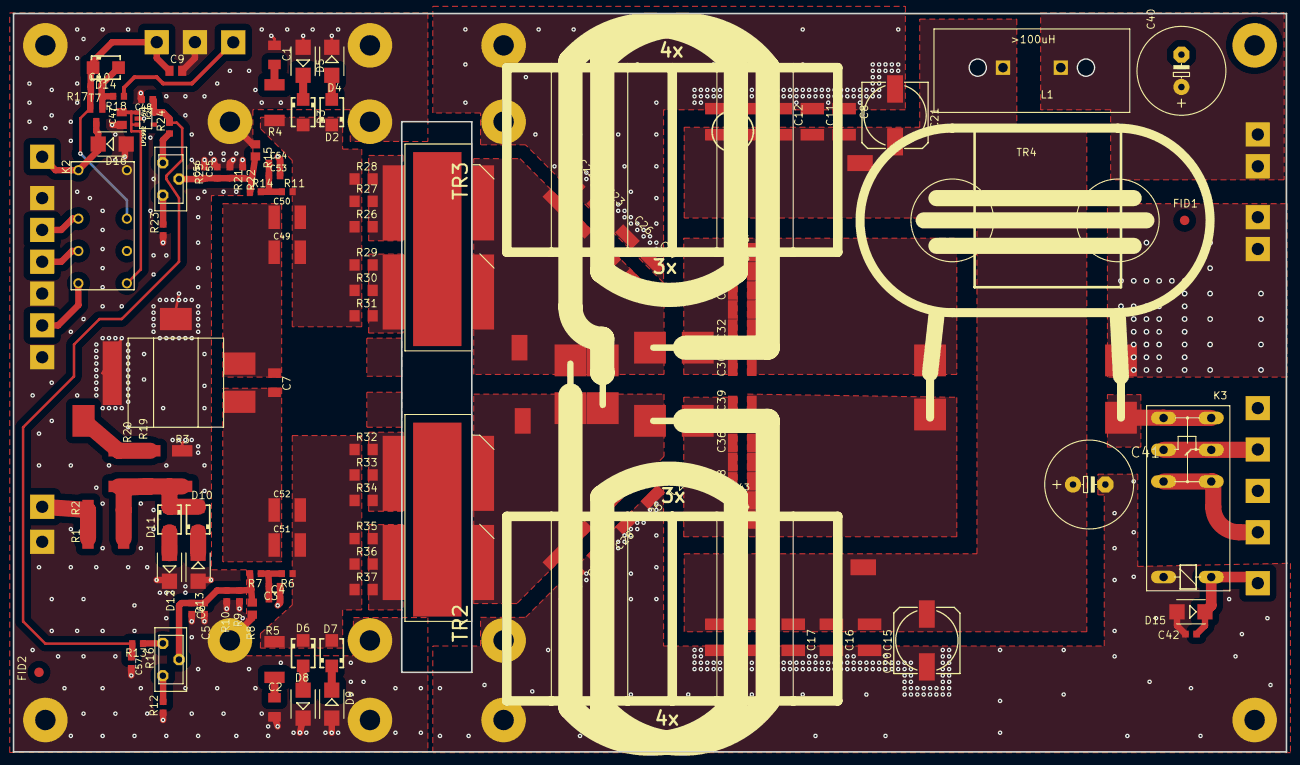
[picture p189: board kwpa_ldmos2.kicad_pcb from above]

Board: 2 copper layers, 200.0 x 116.0 mm, 161 parts (0 on the bottom side), 49 nets.

Parts:
C1, C2: 10n/450V; C1206K
C3, C5, C53, C55, C57: 1u; C0603K
C4, C42, C54: 100n; C0603K
C6, C10, C56: 10n; C0603K
C7: opt.; C1206K
C8, C11, C15, C16: 10n; C1812K
C9: 10u/25; C0805K
C12, C13, C17, C18, C49, C50, C51, C52: 100n; C1812K
C14, C19: 1u; C1812K
C20, C21: 100u/63; 153CLV-1014
C22, C23, C24, C25, C26, C27, C28, C29: 120p; C1812K
C30, C31, C32, C33, C34, C35, C36, C37, C38, C39, C43, C44, C45, C46: 10n; C1210K
C40, C41: 470uF/63V; E5-13
C47: 10u; C0805K
C48: 10u; C0603K
D2, D6: 8,2V; SMA
D3, D7: 4,7V; SMA
D4, D5, D8, D9, D12, D13, D15, D16: DIODE SMB; SMB
D10, D11: SMBJ15A; SMA
D14: 6,2V/1W; SMA
FID1, FID2: FIDUCIAL
H1, H2, H3, H4, H5, H6, H7, H8, H9, H10, H11, H12, H13, H14: HOLE_32; HOLE32
IC2: LP2992 - 5V; SOT23-5
JP1: RF_IN; THICKPIN
JP2, JP3, JP8, JP10, JP12, JP14, JP15, JP20, JP22: GND; THICKPIN
JP4: RXBYP-2; THICKPIN
JP5: +12..+14V; THICKPIN
JP7: RX_BYP1; THICKPIN
JP9: PTT; THICKPIN
JP11: RF-OUT; THICKPIN
JP13, JP16: +50V; THICKPIN
JP17, JP18: RELAIS; THICKPIN
JP19: TO_ATT; THICKPIN
JP21: FROM_ATT; THICKPIN
K2: FINDER-30.22
K3: G5RL-1E-HR-12V; G2RE
L1: >100uH; KERN90_STEHEND_2PIN
R1, R2, R19, R20: 22/2W; R2512
R3: 100/2W; R2512
R4, R5: 10/2W; R2512
R6, R11: 1k; R0603
R7, R14: 470; R0603
R8, R15: NTC0805J5K0; R0805
R9, R21: 560; R0603
R10, R22: 5k6; R0603
R12, R23: 47; R0603
R13, R24: 270; R0603
R16, R25: 250; MINIPOTI
R17, R18: 10k; R0603
R26, R27, R28, R29, R30, R31, R32, R33, R34, R35, R36, R37: 10; R1206
T1, T2: BLF188
T1P3, T1P4, T1S3, T1S4: SMDPAD2,5X4
T7: IRLML6401; SOT23
TR1: 4:1 Laird 28B0562-100; KW-INPUT_LAIRD_28B0562-100
TR2: DOPPELRINGKERN
TR3: DOPPELRINGKERN_REV
TR4: DOPPELLMANTEL_STEHEND

Connections:
ATTM: D10.A, D11.C, R1.2, R2.2, R3.2, R19.1, R20.1
BYP1: JP7.1, K2.12
DD1: C49.2, C50.2, D2.C, D3.A, R4.1, R11.2, R26.1, R27.1, R28.1, R29.1, R30.1, R31.1
DD2: C51.2, C52.2, D6.C, D7.A, R5.2, R6.2, R32.1, R33.1, R34.1, R35.1, R36.1, R37.1
DI1: C7.1, C49.1, C50.1, TR1.OUT2
DI2: C7.2, C51.1, C52.1, TR1.OUT1
DRAIN1: C22.2, C23.2, C26.2, C27.2, T1P4.P$1, T2.1, T2.2, TR2.P1, TR3.P2, TR3.S1
DRAIN2: C24.2, C25.2, C28.2, C29.2, T1.1, T1.2, T1S3.P$1, TR2.P2, TR2.S1, TR3.P1
G1: R26.2, R27.2, R28.2, T2.3
G2: R29.2, R30.2, R31.2, T2.4
G3: R32.2, R33.2, R34.2, T1.3
G4: R35.2, R36.2, R37.2, T1.4
GND: C1.1, C2.2, C3.2, C4.2, C5.2, C6.2, C8.2, C9.2, C11.2, C12.2, C13.2, C14.2, C15.1, C16.1, C17.1, C18.1, C19.1, C20.-, C21.-, C22.1, C23.1, C24.1, C25.1, C26.1, C27.1, C28.1, C29.1, C40.-, C41.-, C42.1, C47.1, C48.2, C53.2, C54.2, C55.2, C56.2, C57.2, D4.C, D5.A, D8.C, D9.A, D12.C, D13.A, D15.A, D16.A, H1.P$1, H2.P$1, H3.P$1, H4.P$1, H5.P$1, H6.P$1, H7.P$1, H8.P$1, H9.P$1, H10.P$1, H11.P$1, H12.P$1, H13.P$1, H14.P$1, IC2.2, JP2.1, JP3.1, JP8.1, JP10.1, JP12.1, JP14.1, JP15.1, JP20.1, JP22.1, K2.A2, K3.2, R3.1, R8.1, R9.1, R10.1, R12.1, R15.1, R21.1, R22.1, R23.1, TR1.COM, TR1.GND, TR4.S1
unnamed: JP21.1, R1.1, R2.1
unnamed: C47.2, IC2.1, IC2.3, K2.24
unnamed: D10.C, D13.C
unnamed: JP11.1, K3.P0, K3.P1
unnamed: C1.2, R4.2
unnamed: C2.1, R5.1
unnamed: JP19.1, K2.14
unnamed: C3.1, C4.1, R6.1, R7.2
unnamed: C5.1, C6.1, R7.1, R8.2, R9.2, R10.2, R16.3
unnamed: R12.2, R16.2
unnamed: R13.1, R16.1
unnamed: C48.1, C57.1, IC2.5, R13.2, R24.2
unnamed: D3.C, D5.C
unnamed: D2.A, D4.A
unnamed: C53.1, C54.1, R11.1, R14.2
unnamed: D7.C, D9.C
unnamed: D6.A, D8.A
unnamed: D11.A, D12.A
unnamed: C55.1, C56.1, R14.1, R15.2, R21.2, R22.2, R25.3
unnamed: R23.2, R25.2
unnamed: R24.1, R25.1
unnamed: C10.2, D14.A, R17.2, R18.2, T7.1
unnamed: JP4.1, K3.O0, K3.O1
unnamed: JP9.1, R18.1
unnamed: R19.2, R20.2, TR1.IN
OUTP1: C30.1, C31.1, C32.1, C33.1, C34.1, C45.1, C46.1, TR3.S2
OUTP2: C35.1, C36.1, C37.1, C38.1, C39.1, C43.1, C44.1, TR2.S2
OUTR1: K3.S0, K3.S1, TR4.P1
OUTS1: C30.2, C31.2, C32.2, C33.2, C34.2, C45.2, C46.2, TR4.S2
OUTS2: C35.2, C36.2, C37.2, C38.2, C39.2, C43.2, C44.2, TR4.P2
RELAIS: C42.2, D15.C, JP18.1, K3.1
RELAISOUT: D16.C, JP17.1, K2.A1, T7.3
RFIN: JP1.1, K2.11
U12: C9.1, C10.1, D14.C, JP5.1, K2.21, R17.1, T7.2
UIN: C40.+, JP13.1, JP16.1, L1.P$1
UVERS: C8.1, C11.1, C12.1, C13.1, C14.1, C15.2, C16.2, C17.2, C18.2, C19.2, C20.+, C21.+, C41.+, L1.P$2, T1P3.P$1, T1S4.P$1
