msayad97/Amplifier/1kw-peak-rfpa-rc-1.0/1kw-peak-rfpa-rc-1.0/src/MRIamp/MRIAMP.kicad_pcb

## KiCad design 1kw-peak-rfpa-rc-1.0/1kw-peak-rfpa-rc-1.0/src/MRIamp/MRIAMP.kicad_pcb (2024-08-07)

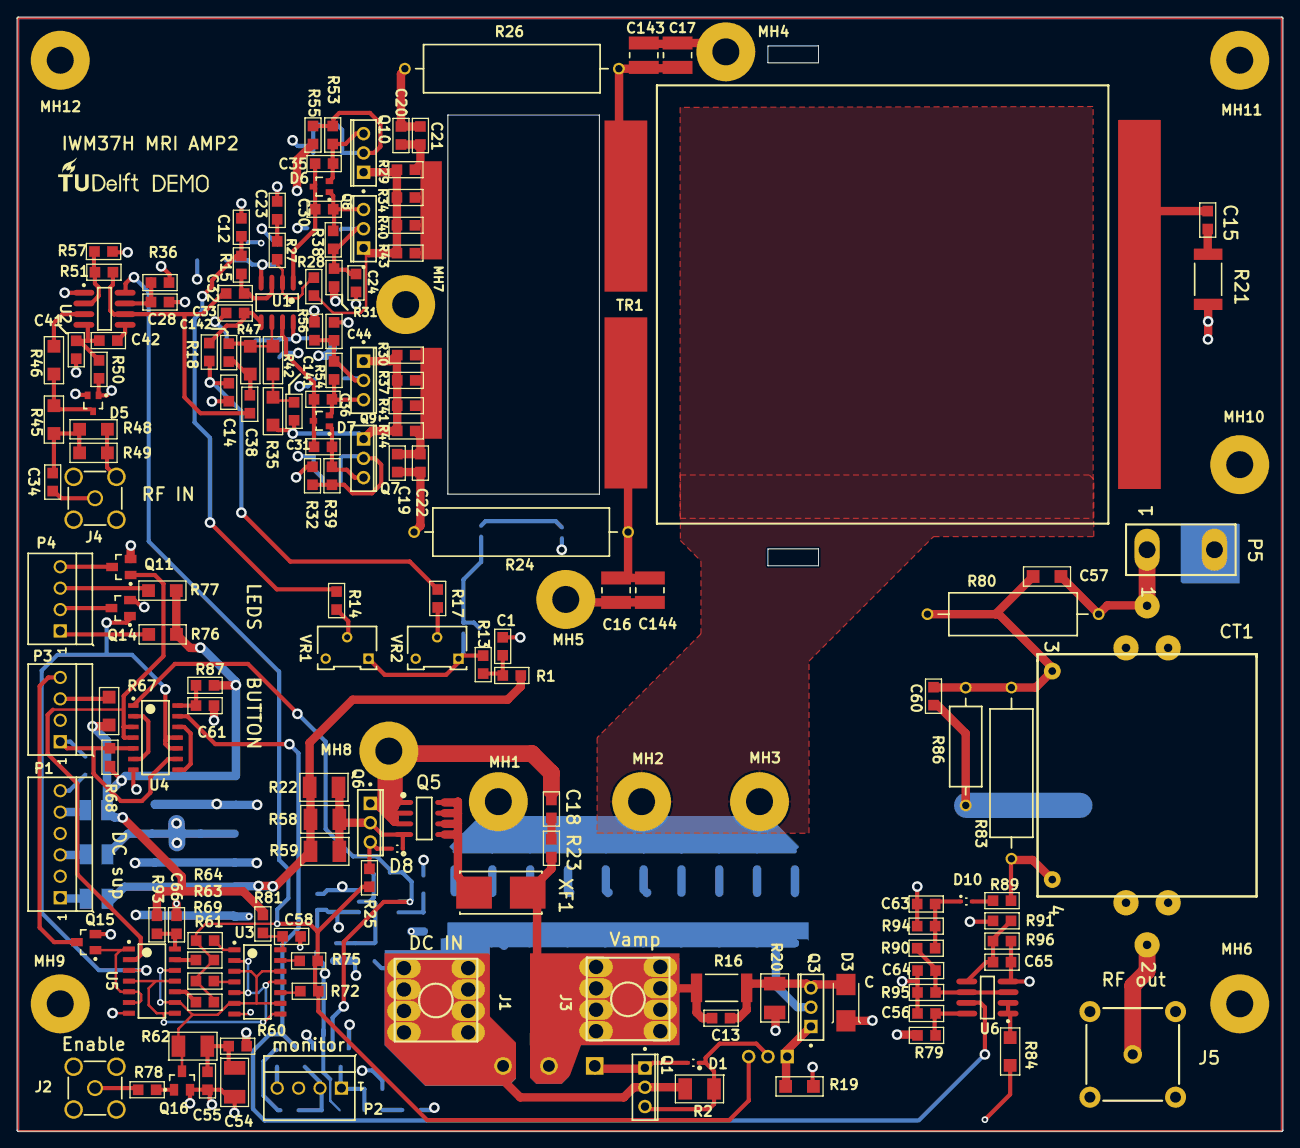
[picture p190: board MRIAMP.kicad_pcb from above]

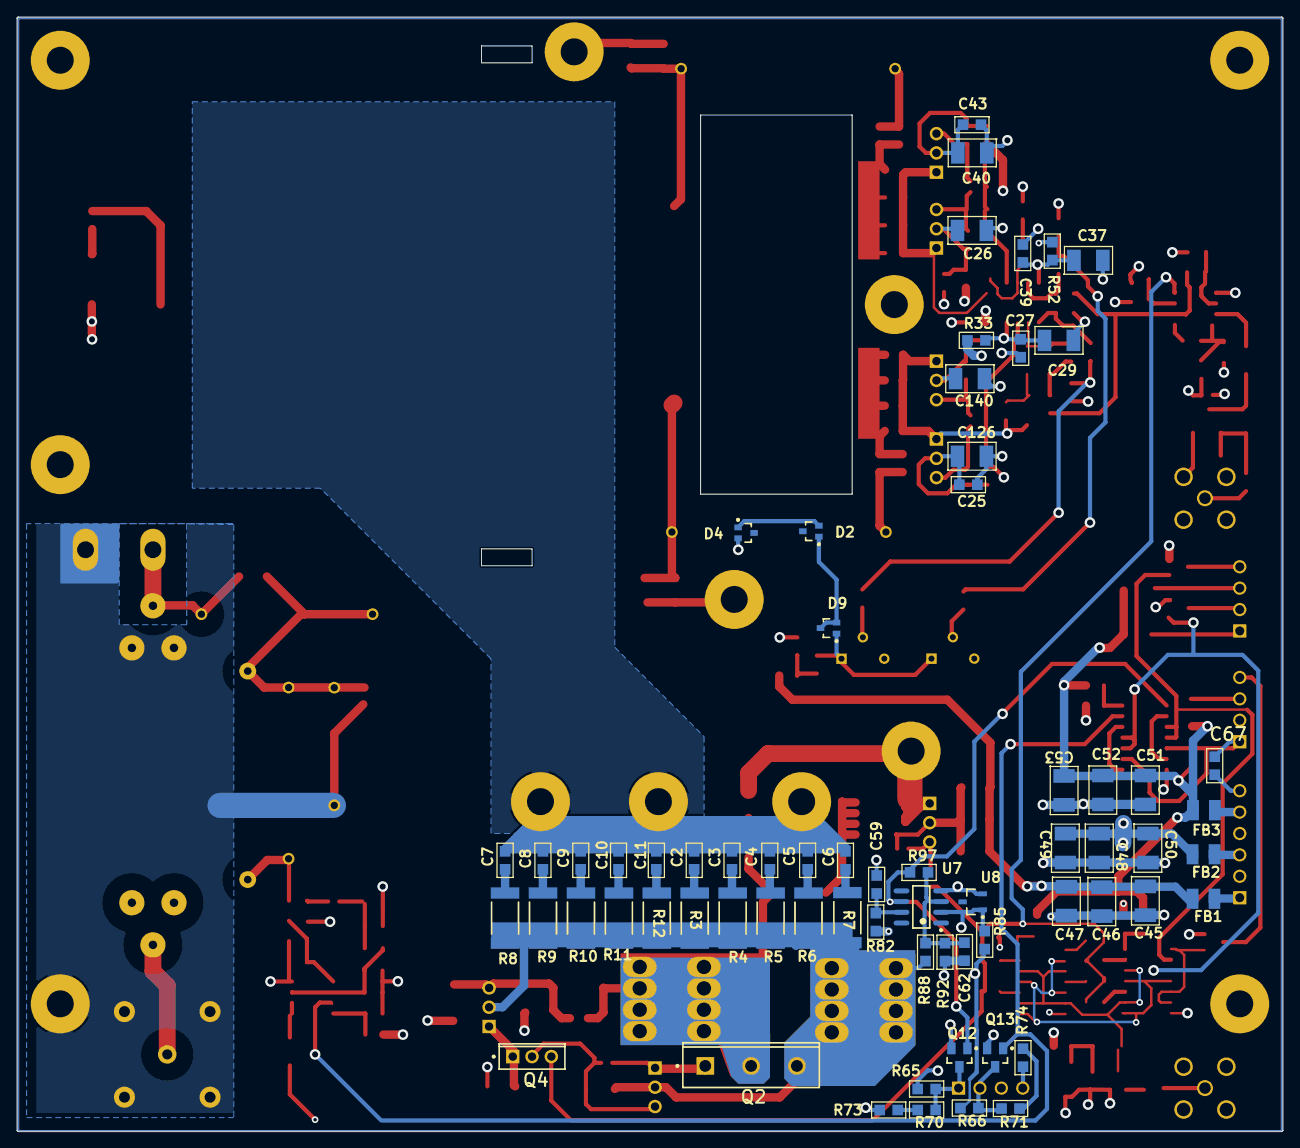
[picture p191: board MRIAMP.kicad_pcb from below]

Board: 4 copper layers, 150.3 x 132.3 mm, 235 parts (68 on the bottom side), 124 nets.

Parts:
C1, C2, C3, C4, C5, C6, C7, C8, C9, C10, C11, C12, C13, C14, C15, C18, C19, C20, C21, C22, C23, C24, C25, C27, C28, C30, C31, C32, C33, C34, C35, C36, C38, C39, C41, C42, C43, C44, C55, C56, C58, C59, C60, C61, C62, C63, C64, C65, C66, C67, C141, C142: Cap; SM/C_0805
C16, C17, C143, C144: Cap; SMD/C_1111
C26, C29, C37, C40, C45, C46, C47, C48, C49, C50, C51, C52, C53, C54, C126, C140: Cap; SM/C_1210
C57: Cap; SM/C_1206
CT1: CT1:10; CT
D1, D8, D10: BAT54XV2T5G; ONSC-SOD-523-2-502-01_V
D2, D4, D5, D6, D7, D9: BAV99WT1G; ONSC-SOT-323-3-419-04_V
D3: ES1C; SM/DO214AC_12
FB1, FB2, FB3: BLM21PG300SN1B; MURA-BLM21-B40-CHIP-2_V1
IWM37H MRI AMP2: Comment; LOGO3
J1, J3: M4 bushing; BUSHING_M4
J2, J4: CONSMA008; SMA-Grotere-Gaten
J5: R141426161; BNC_Danny
MH1, MH2, MH3, MH4, MH5, MH6, MH7, MH8, MH9, MH10, MH11, MH12: M3spacer; MTHOLE3.2MM_TOPBOT7MM
P1: Header 6; POLCON.100/VH/TM1SQS/W.300/6
P2, P3, P4: HEADER 4; POLCON.100/VH/TM1SQS/W.300/4
P5: RFin; megaheader
Q1, Q3, Q4, Q6, Q7, Q8: BD139; ONSC-TO-225-3-77-09
Q2: IXTH90P10P; INF-PG-TO247-3-44
Q5: BSC340N08NS3; SO8_N
Q9, Q10: BD140; ONSC-TO-225-3-77-09
Q11, Q12, Q13, Q14, Q15, Q16: FDV301N; FAIR-SOT23-3_V
R1, R13, R14, R15, R17, R18, R23, R25, R27, R28, R29, R30, R31, R32, R33, R34, R36, R37, R38, R39, R40, R41, R43, R44, R50, R51, R52, R53, R54, R55, R56, R57, R60, R61, R63, R64, R65, R66, R68, R69, R70, R71, R72, R73, R74, R75, R78, R79, R81, R82, R85, R87, R88, R89, R90, R91, R92, R93, R94, R95, R96, R97: Res2; SM/R_0805
R2, R20, R22, R58, R59, R62: Res2; SM/R_1210
R3, R4, R5, R6, R7, R8, R9, R10, R11, R12, R16, R21: Res2; SMD/R_2512
R19: Res2; SM/R_1206
R24, R26: Res2; AX/1.000X.225/.034
R35, R42, R45, R46, R47, R48, R49, R67, R76, R77, R84: Res2; SM/C_1206
R80, R83: Res2; AX/.800X.200/.037
R86: Res2; AX/.550X.150/.034
TR1: 1:1:4:4; PCBComponent_1
U1: AD8017ARZ; ADI-R-8_L
U2: AD8021ARZ; ADI-R-8_M
U3, U5: SN74HC02D; D0014A_N
U4: SN74AHCT132D; D0014A_L
U6: AD822ARZ; ADI-R-8_M
U7: AD820ARZ; ADI-R-8_L
U8: LM4040CIM3-2.5; DBZ0003A_N
VR1, VR2: 10k; VRES38
XF1: 0154010.DR; LFUS-154_V

Connections:
BIAS1: C32.1, R15.1, U1.3
BIAS2: C33.1, R18.1, U1.5
DCok: Q12.1, R97.2, U4.1, U7.6
DRAIN1: C17.2, C143.2, R26.2, TR1.1
DRAIN2: C16.2, C144.2, R24.2, TR1.3
ENABLE: Q4.3, R25.2, R61.2, R63.2, R64.2, R69.2, R72.2, R75.2, U2.8
GATE1: C20.1, C21.1, R29.2, R34.2, R40.2, R43.2
GATE2: C19.1, C22.1, R30.2, R37.2, R41.2, R44.2
GND: C1.1, C12.1, C14.1, C18.1, C23.1, C24.1, C25.1, C26.2, C27.1, C28.1, C29.2, C33.2, C37.2, C39.2, C40.1, C41.1, C43.2, C44.2, C45.2, C46.2, C47.2, C48.2, C49.2, C50.2, C51.2, C52.2, C53.2, C54.2, C55.1, C56.1, C58.1, C59.1, C61.1, C62.1, C63.1, C64.1, C65.1, C66.1, C67.1, C126.2, C140.1, D3.1, D4.2, J2.2, J2.3, J2.4, J2.5, J4.2, J4.3, J4.4, J4.5, MH7.1, MH8.1, P1.2, P1.4, P1.6, P2.4, P3.2, Q5.1, Q5.2, Q5.3, Q6.1, Q11.2, Q12.2, Q13.2, Q14.2, Q15.2, Q16.2, R19.1, R20.1, R21.2, R48.1, R49.1, R57.1, R73.2, R74.2, R92.2, R94.2, R95.1, R96.1, U2.1, U3.7, U4.7, U5.7, U6.4, U7.4, U8.2, VR1.3, VR2.3
LEDactive: P3.4, Q15.3
LEDdcfail: P4.4, Q11.3
LEDprfl: P4.2, Q14.3
NetC1_2: C1.2, R1.1, R13.2
NetC2_1: C2.1, C3.1, C4.1, C5.1, C6.1, C7.1, C8.1, C9.1, C10.1, C11.1, MH1.1, MH2.1, MH3.1
NetC2_2: C2.2, R3.1
NetC3_2: C3.2, R4.1
NetC4_2: C4.2, R5.1
NetC5_2: C5.2, R6.1
NetC6_2: C6.2, R7.1
NetC7_2: C7.2, R8.1
NetC8_2: C8.2, R9.1
NetC9_2: C9.2, R10.1
NetC10_2: C10.2, R11.1
NetC11_2: C11.2, R12.1
NetC12_2: C12.2, R14.1, R15.2
NetC13_1: C13.1, D3.2, Q3.3, R16.2, R20.2
NetC14_2: C14.2, R17.1, R18.2
NetC15_1: C15.1, TR1.2
NetC15_2: C15.2, R21.1
NetC16_1: C16.1, C144.1, MH5.1
NetC17_1: C17.1, C143.1, MH4.1
NetC18_2: C18.2, R23.1
NetC23_2: C23.2, R27.1
NetC24_2: C24.2, C26.1, Q8.2, R31.1, R38.1
NetC25_2: C25.2, C126.1, Q7.2, R32.2, R39.1
NetC27_2: C27.2, C29.1, R33.1, U1.8
NetC28_2: C28.2, R36.1, U2.7
NetC30_1: C30.1, D6.1, Q8.3, R38.2
NetC30_2: C30.2, C35.2, D6.3, U1.1
NetC31_1: C31.1, D7.1, Q7.3, R39.2
NetC31_2: C31.2, C36.2, D7.3, U1.7
NetC32_2: C32.2, C38.1, R51.2, U2.6
NetC34_2: C34.2, J4.1
NetC35_1: C35.1, D6.2, Q10.3, R53.1
NetC36_1: C36.1, D7.2, Q9.3, R54.1
NetC37_1: C37.1, C39.1, R52.1, U1.4
NetC38_2: C38.2, C142.2, R47.2
NetC40_2: C40.2, C43.1, Q10.2, R53.2, R55.1
NetC41_2: C41.2, C42.2, R50.1, U2.4
NetC42_1: C42.1, U2.5
NetC44_1: C44.1, C140.2, Q9.2, R54.2, R56.2
NetC54_1: C54.1, C55.2, R60.2, R62.2
NetC56_2: C56.2, R79.2, U6.8
NetC57_1: C57.1, C60.2, CT1.3, R80.2, R83.2, R86.1
NetC57_2: C57.2, CT1.1, P5.1, R80.1
NetC58_2: C58.2, R81.2, U3.14
NetC59_2: C59.2, R82.2, U7.7
NetC61_2: C61.2, R87.2, U4.14
NetC62_2: C62.2, R88.2, R92.1, R97.1, U7.3
NetC63_2: C63.2, D10.1, R90.1, R94.1
NetC64_2: C64.2, R90.2, R95.2, U6.3, U6.6
NetC65_2: C65.2, R91.2, R96.2, U6.5
NetC66_2: C66.2, R93.2, U5.14
NetC67_2: C67.2, P3.1, R68.2, U4.5, U4.9
NetC141_1: C141.1, Q7.1, Q9.1, R30.1, R35.1, R37.1, R41.1, R44.1
NetC141_2: C141.2, R35.2, R42.1
NetC142_1: C142.1, R42.2, R47.1, U1.6
NetCT1_2: CT1.2, J5.1
NetCT1_4: CT1.4, R83.1, R89.1
NetD1_1: D1.1, Q1.3, Q4.2, R2.1
NetD1_2: D1.2, Q1.1, Q2.1
NetD2_1: D2.1, D9.2, D9.3
NetD2_2: D2.2, D4.1
NetD5_3: D5.3, R45.1, R46.2
NetD8_1: D8.1, Q5.4, Q6.2, R22.1, R58.1, R59.1
NetD8_2: D8.2, Q6.3, R25.1
NetD9_1: D9.1, R13.1, VR1.1, VR2.1
NetD10_2: D10.2, R89.2
NetFB1_1: FB1.1, P1.1
NetFB2_1: FB2.1, P1.3
NetFB3_1: FB3.1, P1.5
NetJ2_1: J2.1, R78.1
NetP2_1: P2.1, Q12.3, R65.2, R70.1
NetP2_2: P2.2, Q13.3, R66.2, R71.1
NetP2_3: P2.3, R84.1
NetP3_3: P3.3, R67.2
NetP4_1: P4.1, R76.2
NetP4_3: P4.3, R77.2
NetQ3_1: Q3.1, Q4.1, R19.2
NetQ5_5: Q5.5, Q5.6, Q5.7, Q5.8, XF1.1
NetQ8_1: Q8.1, Q10.1, R28.2, R29.1, R34.1, R40.1, R43.1
NetQ11_1: Q11.1, U4.3, U4.4, U5.2
NetQ14_1: Q14.1, U4.10, U4.11, U5.3
NetQ15_1: Q15.1, U5.1, U5.5, U5.6
NetQ16_1: Q16.1, R78.2
NetQ16_3: Q16.3, R62.1, U3.3, U3.6, U3.9, U3.12, U5.9, U5.12
NetR14_2: R14.2, VR1.2
NetR17_2: R17.2, VR2.2
NetR27_2: R27.2, R28.1, U1.2
NetR46_1: R46.1, U2.3
NetR51_1: R51.1, R57.2, U2.2
NetR61_1: R61.1, U5.10
NetR63_1: R63.1, U5.13
NetR64_1: R64.1, U3.1
NetR69_1: R69.1, U3.4
NetR70_2: R70.2, R73.1
NetR71_2: R71.2, R74.1
NetR72_1: R72.1, U3.10
NetR75_1: R75.1, U3.13
NetR84_2: R84.2, U6.1, U6.2
NetU3_2: U3.2, U3.5, U3.8, U3.11, U5.4, U5.8, U5.11
NetU4_2: U4.2, U4.6
NetU4_8: U4.8, U4.12
RFB1: C20.2, C21.2, R26.1
RFB2: C19.2, C22.2, R24.1
RFIN: C34.1, R45.2, R48.2, R49.2
RFgnd: C60.1, CT1.5, CT1.6, J5.2, J5.3, J5.4, J5.5, MH6.1, P5.2, R86.2
SWRok: Q13.1, U4.13, U6.7
VAMP: C13.2, J3.1, J3.2, J3.3, J3.4, J3.5, J3.6, J3.7, J3.8, Q2.2, R16.1, R23.2, XF1.2
VN: C48.1, C49.1, C50.1, D5.1, FB2.2, R50.2, R52.2, R55.2, R56.1
VP: C45.1, C46.1, C47.1, D5.2, FB1.2, R1.2, R22.2, R31.2, R32.1, R33.2, R36.2, R58.2, R59.2
VSUP: J1.1, J1.2, J1.3, J1.4, J1.5, J1.6, J1.7, J1.8, Q1.2, Q2.3, Q3.2, R2.2, R3.2, R4.2, R5.2, R6.2, R7.2, R8.2, R9.2, R10.2, R11.2, R12.2, R88.1
Vd: C51.1, C52.1, C53.1, FB3.2, R60.1, R65.1, R66.1, R67.1, R68.1, R76.1, R77.1, R79.1, R81.1, R82.1, R85.1, R87.1, R93.1
ref2V5: R85.2, R91.1, U7.2, U8.1
