msayad97/Amplifier/(commit log)

2023-06-23 Änderung
    Simulationszeit und Pulse
2023-06-23 Probe Simulation
2023-06-24 update
    test Simulation durchgeführt. Vp und Vin wurden geändert.
2023-06-24 update und simulation
2023-06-27 Analyse
    Q3 und Q4 Differentialpaar. Differezverstärker
2023-06-28 update
    Änderung der Schaltung
2023-07-31 new mosfets
2023-10-25 Kicad design
    nicht vollständig. Spannungsquelle muss noch mitreingefügt
    [Switch.kicad_pcb, Switch.kicad_sch]
2023-10-30 update sockets
2023-10-30 update ground plate
    [Switch.kicad_pcb, Switch.kicad_sch]
2023-10-30 update vin/vout
    [Switch.kicad_sch]
2023-10-30 Ground plate connected
    [Switch.kicad_pcb]
2023-10-30 groundplate altered
    all the ground sockets are connected
2023-10-30 connection complete
    [Switch.kicad_pcb]
2023-10-31 Vp1 socket
    install Vp1 socket
    [Switch.kicad_pcb, Switch.kicad_sch]
2023-11-01 new version update
    [Switch.kicad_pcb, Switch.kicad_sch, Switch6.0.kicad_pcb, Switch6.0.kicad_sch]
2023-11-06 name change
    [Switch.kicad_pcb, Switch.kicad_sch]
2023-11-06 replace file
    [Switch.kicad_pcb, Switch.kicad_sch, Switch6.0.kicad_pcb, Switch6.0.kicad_sch, Switch7.0.kicad_pcb, Switch7.0.kicad_sch]
2023-11-06 version 6.0 and 7.0
    [Switch.kicad_pcb, Switch.kicad_sch, Switch6.0.kicad_pcb, Switch6.0.kicad_sch]
2023-11-06 replace old file
    [Switch.kicad_pcb, Switch.kicad_sch, Switch6.0.kicad_pcb, Switch6.0.kicad_sch]
2023-11-06 paste right copy
    [Switch6.0.kicad_pcb, Switch6.0.kicad_sch, Switch7.0.kicad_pcb, Switch7.0.kicad_sch]
2023-11-08 new upload.
    correct versions
    [Switch6.0.kicad_pcb, Switch6.0.kicad_sch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]
2023-11-13 Final results
    [Switch6.0.kicad_pcb, Switch6.0.kicad_sch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]
2024-01-10 Simulation and Kicad update
    Simulation oof the Switch updated with an op amp. Kicad structure updated (0.2 version)
    [BOM behuizing.xlsx, BOM_MRIamp2.xlsx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]
2024-01-10 files added
    description files added
    [RF output measurements.xlsx]
2024-01-12 Switch Platine
    Platine 0.2 Entwurf mit OpV
    [Switch6.0.kicad_pcb, Switch6.0.kicad_sch, Switch7.0.kicad_pcb, Switch7.0.kicad_sch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]
2024-01-18 Simulation und PCB update
    [Switch.kicad_pcb, Switch.kicad_sch, Switch0.2.kicad_pcb, Switch0.2.kicad_sch]
2024-01-22 kicad switch LDO install
    [Switch.kicad_pcb, Switch.kicad_sch]
2024-06-18 Update Simulation and Schematic
2024-07-01 Update
    KiCad Schaltplan und Footprints unter Ampilfier.
    Data Sheets zusammengefasst.
    [Amplifier.kicad_pcb, Amplifier.kicad_sch]
2024-07-03 update Ampilfier
    Schematic updated with separate pages.
    all footprints added.
    to do :
    HF Part
    [Amplifier.kicad_sch, Bias.kicad_sch, HF_Part.kicad_sch, OPV1.kicad_sch, OPV2.kicad_sch, Switch.kicad_sch, Voltage_Supply.kicad_sch]
2024-07-07 Footprint created
    still needs work. embedded Pad design
    [Amplifier.kicad_pcb, BLF188XRU.STEP]
2024-08-07 Platinenentwurf
    die Platine wurde aufgebaut. Kontrolle fehlt
    [Amplifier.kicad_pcb, Amplifier.kicad_sch, BOM.csv, Bias.kicad_sch, DBZ0003AakaMF03A.stp, HF_Part.kicad_sch, INF-PG-TO247-3-44.PcbLib, IWM37H-01-M303~Capacitor_holder_cup_PVC.dxf]
2024-08-15 Update PCB
    update PCB
    [26-01-3115--3DModel-STEP-269445.STEP, 901-144.stp, Amplifier.kicad_pcb, Amplifier.kicad_sch, BLF188XRU.STEP, BLM21PG300SN1B.STEP, PVG3A504C01R00.STEP, Voltage_Supply.kicad_sch]
2024-08-29 Update PCB
    new design for the HF part
    [Amplifier.kicad_pcb, Amplifier.kicad_sch, Amplifier2.kicad_pcb, Amplifier2.kicad_sch, Bias.kicad_sch, DBZ0003AakaMF03A.stp, HF_Part.kicad_sch, Input.kicad_sch]
2024-09-01 update
    completed design and parts
    [Amplifier2.kicad_pcb, Bias.kicad_sch, HF_Part.kicad_sch, OPV1.kicad_sch, OPV2.kicad_sch, Parts.xlsx, Switch.kicad_sch]
2024-09-03 Amplifier2 Version 1.0
    PCB Design Ver 1.0 & List for Parts
    [Amplifier.kicad_pcb, Amplifier.kicad_sch, Amplifier2.kicad_pcb, Amplifier2.kicad_sch, Bias.kicad_sch, DBZ0003AakaMF03A.stp, HF_Part.kicad_sch, Input.kicad_sch]
2025-01-21 new Update
    latest simulations and PCB designs
    [26-01-3115--3DModel-STEP-269445.STEP, 901-144.stp, A3.kicad_pcb, A3.kicad_sch, Amplifier.kicad_pcb, Amplifier.kicad_sch, Amplifier2.kicad_pcb, Amplifier2.kicad_sch]
